dkeenan7/LyteFyba/web/BMUs_installed.jpg

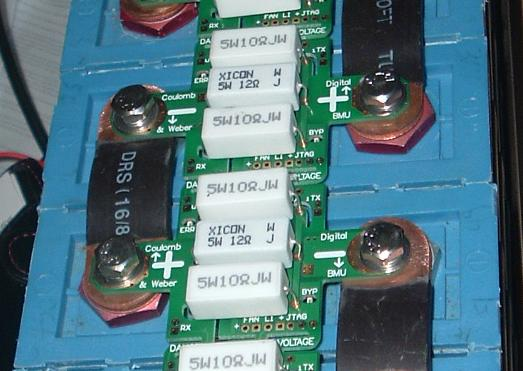
web/BMUs_installed.jpg
