dkeenan7/LyteFyba/web/BMU_tester_04_sm.jpg

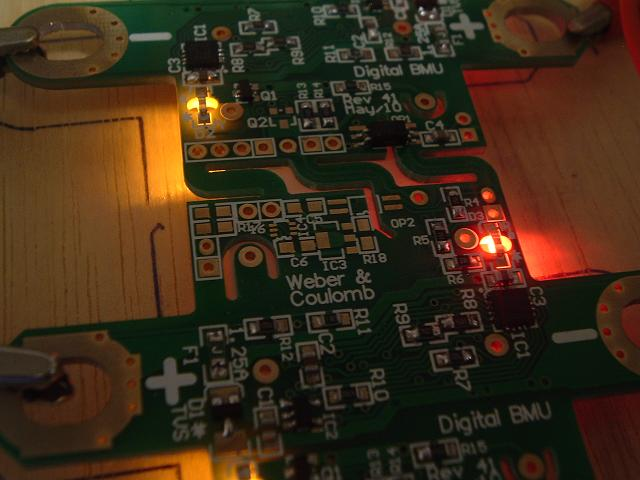
web/BMU_tester_04_sm.jpg
