dkeenan7/LyteFyba/wmonolith/LyteFyba Modbus protocol.odt

LyteFyba BMS

Modbus Protocol

The LyteFyba Battery Management System can communicate with the system controller using Modbus/ASCII over an RS232 port at 9600 bits per second, with a male D9 connector configured as a DTE. No handshaking is required, and appropriate signals are set so that any system expecting hardware handshaking will be satisfied. The communications port requires either 8 bits, no parity, and 1 stop bit, or 7 bits, space parity, and 1 stop bit.

Modbus commands must end with a carriage return character (hex 0D), which can optionally be followed by a linefeed character (hex 0A). All LyteFyba Modbus responses are terminated with a carriage return and a linefeed.

The main device address is 247 (although it may be changed in the source code, e.g. 100 for Geli). Results are read with function code 3 (read holding registers) only. All results are single register.

Parameter name | Register | Type | Units | Range | Equivalent plain-text command
Battery Energy Capacity | 43649 | Uint16 | Wh | 0-65,535 Wh | E@
Battery Discharge Capability | 43393 | Uint16 | W | 0-65,535 W | D@
Battery Charge Capability | 43137 | Uint16 | W | 0-65,535 W | C@
Battery Voltage | 40119 | Uint16 | 0.1 V | 0-400 V | v
Battery Current | 40109 | Sint16 | 0.5 A | -750 to 750 A | l
State Of Charge | 40103 | Uint16 | 0.1% | 0-100% | f
Maximum Cell Stress | 40113 | Bit fields | | See below | p

The register numbers above, use the strange Modbus convention whereby you must subtract 40001 to obtain the register address that is actually transmitted. For LyteFyba, this address corresponds to the equivalent plain-text (non-modbus) command, hence the large gaps between the numbers.

Uint16 = unsigned integer, 16 bits, range 0 to 65535

Sint16 = signed integer, 16 bits, range -32768 to 32767

It is also possible to address individual Cell Management Units (CMUs), using their cell number as their device address (e.g. 1-16 in a typical 48 V LiFePO4 battery). In this case, the Battery Voltage register contains the cell's voltage in millivolts, and the Maximum Cell Stress register contains the stress bit fields for that cell alone. There is also a broadcast device address, 246 (or one less than the main device address), to which all devices will respond – their responses arriving sequentially.

Maximum Cell Stress bit fields:

15-7 6 5 4 3 2 1 0

+------- -------+---------+---------+---------+---------+---------+---------+---------+

| Always | Comms | Stress type | Stress level (0 to 15 in binary) |

| 0 | error | | |

+------- -------+---------+---------+---------+---------+---------+---------+---------+

Treat 00 don't ignore 0-7 Normal

as 01 ignore on discharge 8-11 Warning

stress 10 ignore on charge 12-15 Alarm

8 11 all in bypass, and (BMU disconnects battery at 15)

ignore on discharge

Cell stress

The simplest battery monitoring systems use a single alarm-wire which is daisy-chained through all of the CMUs (Cell Management Units) so that if any cell goes outside its safe operating area the circuit is broken. This single-bit all-or-nothing approach does not give the rest of the system any warning of impending disconnection and so the LyteFyba system instead uses a four-bit number (0 to 15) to represent the "stress level" of each cell. Stress may be due to under-voltage, over-voltage, under-temperature, over-temperature, excessive charge current or excessive discharge current (whichever is the worst at the time). Stress levels 7 down to 0 are increasingly safe and levels 8 up to 15 are increasingly unsafe.

At regular intervals, the first CMU sends its stress level to the second CMU which, like all the remaining CMUs, either passes it on or substitutes its own stress level if this is greater. So the stress level that arrives at the BMU (Battery Management Unit) a few milliseconds later is the stress level of the most stressed cell. The BMU then substitutes a stress level based on the current if this is greater, and makes this available as register 40113 to the system controller. Stress updates can be configured to be as fast as 15 times per second or as slow as one every 1.9 seconds.

If stress is starting to rise when the system controller is discharging the battery, it can anticipate problems by responding to the increasing stress of say 8 to 9 to 10 by reducing the demand on the battery (direct the inverter to transfer less power). By reacting to the lower levels of stress, a potentially unstable situation where the battery voltage oscillates due to the inverter power surging high and low, as could happen with a single alarm condition, is avoided. Similarly, when charging the battery, as the battery approaches higher states of charge, its impedance rises, making it susceptible to surges. By heeding the lower stress levels and smoothly tapering the charge power, instability is again avoided.

The system controller, battery management system and battery form a control system. Ideally, but not required, a proportional / integral (PI) control algorithm would be used to control both discharge power (and hence current), and charge power (and hence current; the cells only care about current). That is the reason for the wide range of normal stress levels; a PI control algorithm is able to use these stress levels to better anticipate an alarm condition, resulting in better protection of the cells.

When the stress-type field is 00, 01 or 11, the stress should be treated like maximum cell voltage, and when the stress-type field is 00 or 10, the stress should be treated like minimum cell voltage, except in this case higher stress corresponds to lower cell voltage. If the stress is actually due to temperature or current, the same strategy will act to protect the battery, lowering discharge or charge current as needed. In all cases, the goal is to keep the stress below 8.

End of charge

For the BMS to consider that charging is complete and so resynchronise the coulomb-counting State-of-Charge register at 100%, and to avoid loss of capacity by keeping the cells balanced, the charge current will need to be reduced to a low value after the first cell nears full charge, and it will need to be held there while the other cells come up to the same voltage, which is the voltage at which the bypass resistors turn on. The bypass resistors can bypass a maximum of 0.8 amps.

A PI-control algorithm based on a stress setpoint of 7 would automatically accomplish this. Balancing is complete, and hence charging should be terminated, when the stress-type field of the stress register contains the bit values 11 and the stress-level field contains 7.

– Mike Van Emmerik, 05-Oct-2015 [Updated, 15-Feb-2016]
