dkeenan7/LyteFyba/PCB/TC charger/charger_interface2.gif

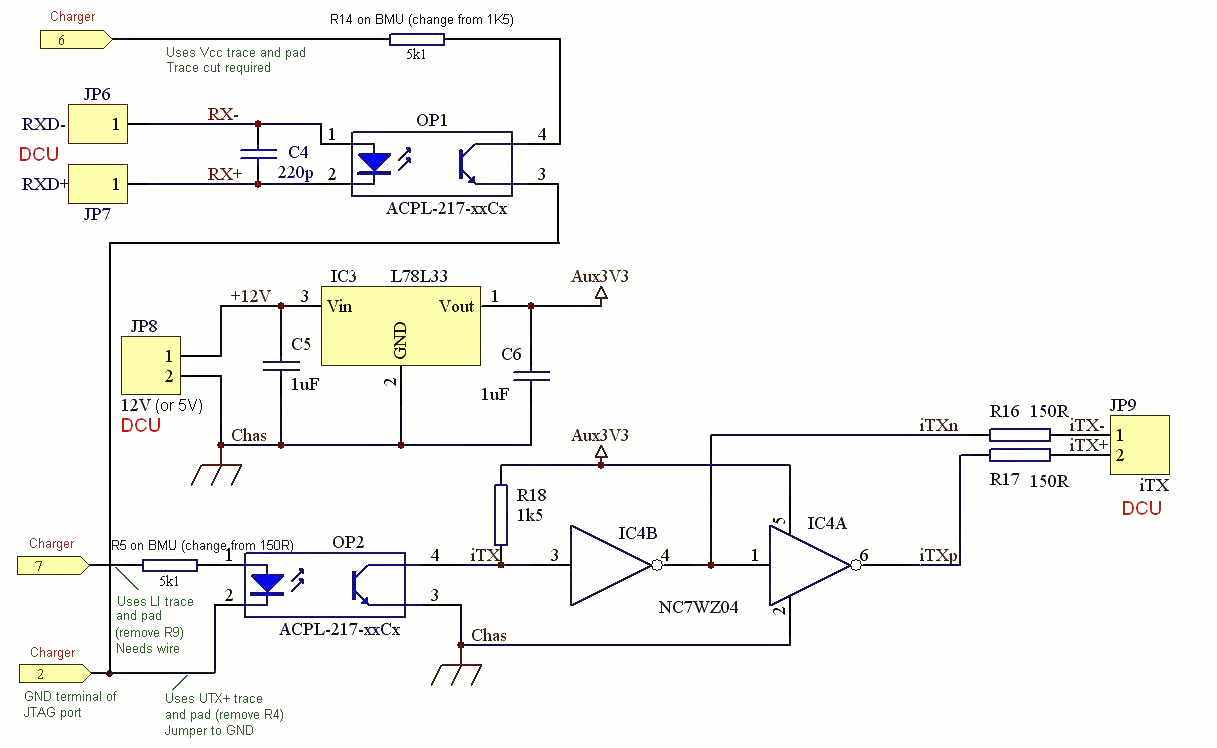
PCB/TC charger/charger_interface2.gif
