dkeenan7/LyteFyba/web/bms_digital41_pcb.gif

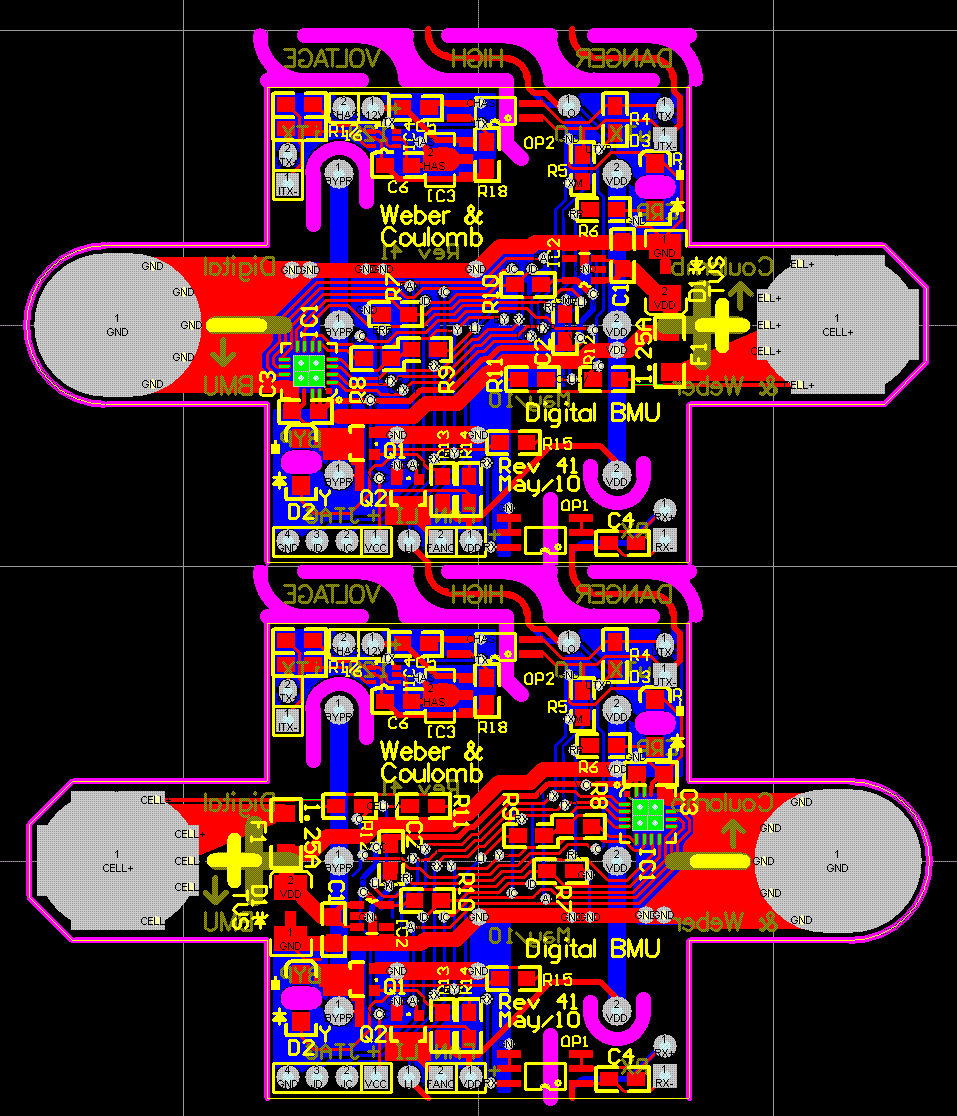
web/bms_digital41_pcb.gif
