dkeenan7/LyteFyba/web/bms_digital41_sch1.gif

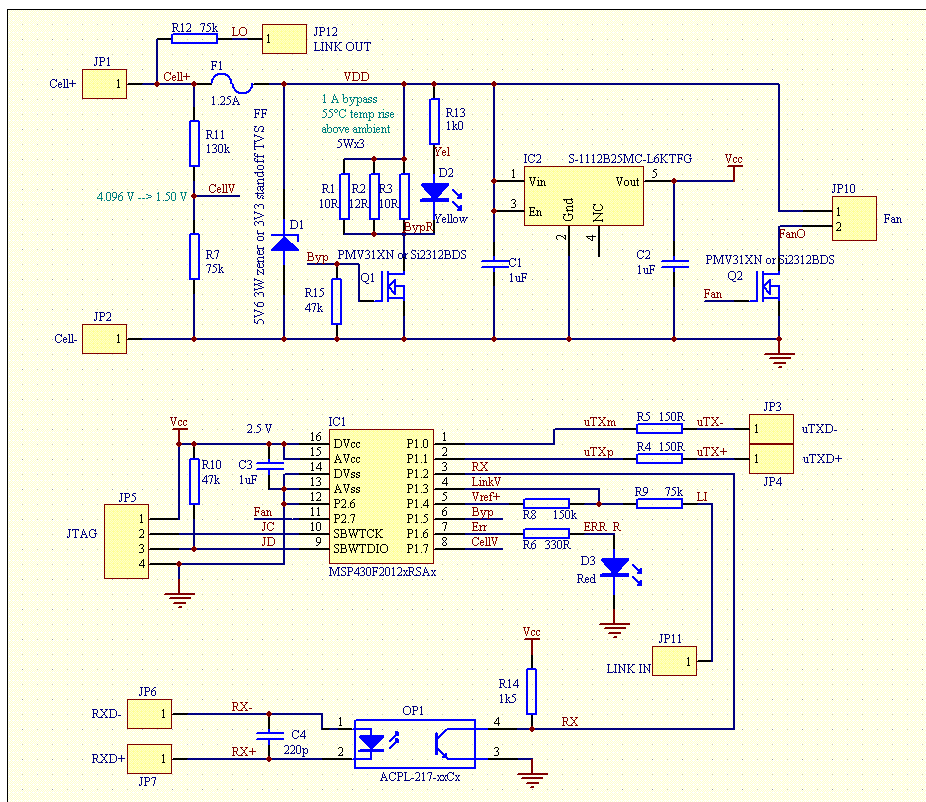
web/bms_digital41_sch1.gif
