dkeenan7/LyteFyba/web/bms_digital41_sch2.gif

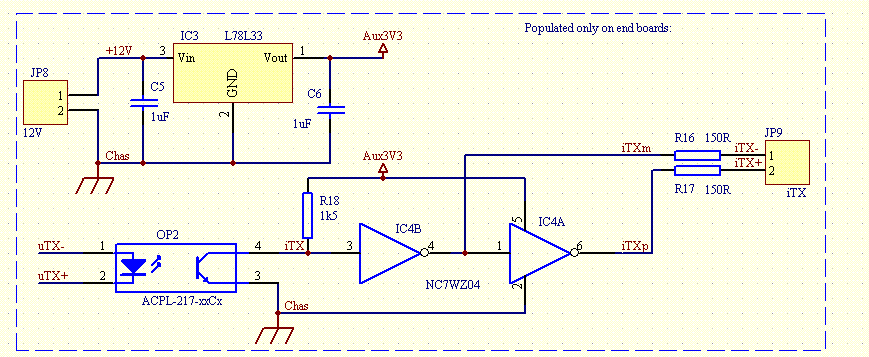
web/bms_digital41_sch2.gif
