dkeenan7/LyteFyba/web/JTAG 003 crop_sm.jpg

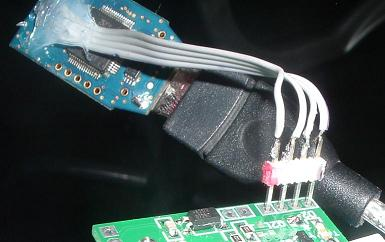
web/JTAG 003 crop_sm.jpg
