dkeenan7/LyteFyba/PCB/MidCMU (BoM).xlsx

Ref Name | Qty | Total | THD-DNP | Component | Description | Value | Package | Manufacturer | MPN | Digikey | Mouser
D5, D6 | 2 | 288 |  | 1N4148 |  |  | SOD523 | Micro Commercial Co | 1N4148X-TP | http://www.digikey.com.au/product-detail/en/micro-commercial-co/1N4148X-TP/1N4148XTPMSCT-ND/789335 | http://au.mouser.com/ProductDetail/Micro-Commercial-Components-MCC/1N4148X-TP/
P2, P3 | 2 | 288 | THD | 3WP | 3 way Pin Header |  | DSC | Wurth | 61300311121 | http://www.digikey.com.au/products/en?keywords=61300311121 | http://au.mouser.com/ProductDetail/Wurth-Electronics/61300311121/
P4, P5 | 2 | 288 | DNP | 4-2WP | 4 way Pin Header |  | DSC |  |  | http://www.digikey.com.au/product-detail/en/640453-4/A1917-ND/108991
P1, P6 | 2 | 288 | DNP | 4WP | 4 way Pin Header | Molex22-05-2041 | DSC |  |  | http://www.digikey.com.au/scripts/DkSearch/dksus.dll?vendor=0&keywords=WM4102-ND
C6, C7, C8, C9 | 4 | 576 |  | C | Capacitor | 1u0 | M1608 | Samsung | CL10B105MO8NNWC | http://www.digikey.com.au/product-detail/en/samsung-electro-mechanics-america-inc/CL10B105MO8NNWC/1276-6524-1-ND/5961383 | http://au.mouser.com/ProductDetail/Murata-Electronics/GRM188R71C105KA12J/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
C2, C3, C4 | 3 | 432 |  | C | Capacitor | 2n2 | M1608 | Samsung | CL10B222KB8WPNC | http://www.digikey.com.au/product-detail/en/samsung-electro-mechanics-america-inc/CL10B222KB8WPNC/1276-6530-1-ND/5961389 | http://au.mouser.com/ProductDetail/Wurth-Electronics/885012206085/
D1 | 1 | 144 |  | DIODE 2010 |  | CGRA4007-G | SM | Comchip Technology | CGRA4007-G | http://www.digikey.com.au/product-detail/en/CGRA4007-G/641-1018-1-ND/1121140 | http://au.mouser.com/ProductDetail/Comchip-Technology/CGRA4007-G/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
U4 | 1 | 144 |  | Dual Inverter |  | 74LVC2G04DW-7 | SOT363 | Diodes Inc | 74LVC2G04DW-7 | http://www.digikey.com.au/product-detail/en/diodes-incorporated/74LVC2G04DW-7/74LVC2G04DW-7DICT-ND/4505236 | http://au.mouser.com/ProductDetail/Diodes-Incorporated/74LVC2G04DW-7/
F1 | 1 | 144 |  | FUSE IEC |  | 1.25A | 2410 | Bell Fuse Inc | SSQ 1.25 | http://www.digikey.com.au/product-detail/en/SSQ%201.25/507-1046-1-ND/615027 | http://au.mouser.com/ProductDetail/Bel-Fuse/SSQ-125-1K/
U3 | 1 | 144 | DNP | IR RECEIVER |  | TSDP34156 | MISC |  |  | http://www.digikey.com.au/product-search/en?vendor=0&keywords=tsdp34156&stock=1 | http://au.mouser.com/ProductDetail/Vishay/TSDP34156/
D9 | 1 | 144 |  | LED |  | LB Q39G-L2OO-35-1 | LED M1608 | Osram | LB Q39G-L2OO-35-1 | http://www.digikey.com.au/product-detail/en/osram-opto-semiconductors-inc/LB-Q39G-L2OO-35-1/475-2816-1-ND/2176355 | http://au.mouser.com/ProductDetail/Osram-Opto-Semiconductor/LB-Q39G-L2OO-35-1/
D4 | 1 | 144 | DNP | LED |  | LTE-302 | LED side view thru hole |  |  | http://www.digikey.com.au/product-detail/en/LTE-302/160-1063-ND/153264 | http://au.mouser.com/ProductDetail/Lite-On/LTE-302/
D8 | 1 | 144 |  | LED |  | SML-D12M1WT86 | LED M1608 | Rohm | SML-D12M1WT86 | http://www.digikey.com.au/product-detail/en/rohm-semiconductor/SML-D12M1WT86/SML-D12M1WT86CT-ND/5843861 | http://au.mouser.com/ProductDetail/ROHM-Semiconductor/SML-D12M1WT86/
D16 | 1 | 144 |  | LED |  | SML-D12U1WT86 | LED M1608 | Rohm | SML-D12U1WT86 | http://www.digikey.com.au/product-detail/en/rohm-semiconductor/SML-D12U1WT86/SML-D12U1WT86CT-ND/5843858 | http://au.mouser.com/ProductDetail/ROHM-Semiconductor/SML-D12U1WT86/
D2 | 1 | 144 |  | LED |  | SML-D12Y1WT86 | LED M1608 | Rohm | SML-D12Y1WT86 | http://www.digikey.com.au/product-detail/en/rohm-semiconductor/SML-D12Y1WT86/SML-D12Y1WT86CT-ND/5843860 | http://au.mouser.com/ProductDetail/ROHM-Semiconductor/SML-D12Y1WT86/
U1 | 1 | 144 |  | MSP430G2553IPW20 | MSP430 Ultra-Low Power Microcontroller | MSP430G2553IPW20 | IPW20 | Texas Instruments | MSP430G2553IPW20R | http://www.digikey.com.au/product-detail/en/MSP430G2553IPW20R/296-28430-1-ND/2638889 | http://au.mouser.com/ProductDetail/Texas-Instruments/MSP430G2553IPW20R/
Q1 | 1 | 144 |  | NMOS SMD | MOSFET | RTR030N05TL | SMD | Alpha & Omega | AO3422 | https://www.digikey.com.au/product-detail/en/rohm-semiconductor/RTR030N05TL/RTR030N05TLCT-ND/2000247 | http://au.mouser.com/ProductDetail/ROHM-Semiconductor/RTR030N05TL/
OP1 | 1 | 144 |  | OPTO |  | TLP293(GR-TPL,E | SM | Toshiba | TLP293(GR-TPL,E | http://www.digikey.com.au/product-detail/en/toshiba-semiconductor-and-storage/TLP293(GR-TPL,E/TLP293(GR-TPLECT-ND/4562968 | http://au.mouser.com/ProductDetail/Broadcom-Avago/ACPL-217-50BE/
SG1 | 1 | 144 | THD | PIEZO_SMD |  | 4 kHz peak | PIEZO |  |  | http://www.digikey.com.au/products/en?keywords=PKM13EPYH4000 | http://au.mouser.com/ProductDetail/Murata/PKM13EPYH4000-A0/
R1 | 1 | 144 | DNP | R | Resistor | 0R | SM
R18 | 1 | 144 |  | R | Resistor | 5k1 | M1608 | Yageo | RC0603JR-075K1L | https://www.digikey.com.au/product-detail/en/yageo/RC0603JR-075K1L/311-5.1KGRCT-ND/729743 | http://au.mouser.com/ProductDetail/Yageo/RC0603JR-075K1L/
R17 | 1 | 144 |  | R | Resistor | 6k8 | M1608 | Yageo | RC0603JR-076K8L | https://www.digikey.com.au/product-detail/en/yageo/RC0603JR-076K8L/311-6.8KGRCT-ND/729760 | http://au.mouser.com/ProductDetail/Yageo/RC0603JR-076K8L/
R16, R19 | 2 | 288 |  | R | Resistor | 39R | M1608 | Yageo | RC0603JR-0739RL | https://www.digikey.com.au/product-detail/en/yageo/RC0603JR-0739RL/311-39GRCT-ND/729726 | http://au.mouser.com/ProductDetail/Yageo/RC0603JR-0739RL/
R10, R15 | 2 | 288 |  | R | Resistor | 47k | M1608 | Yageo | RC0603JR-0747KL | https://www.digikey.com.au/product-detail/en/yageo/RC0603JR-0747KL/311-47KGRCT-ND/729741 | http://au.mouser.com/ProductDetail/Yageo/RC0603JR-0747KL/
R5, R6 | 2 | 288 |  | R | Resistor | 150R | M1608 | Yageo | RC0603JR-07150RL | https://www.digikey.com.au/product-detail/en/yageo/RC0603JR-07150RL/311-150GRCT-ND/729661 | http://au.mouser.com/ProductDetail/Yageo/RC0603JR-07150RL/
R3, R4 (abc) | 6 | 864 |  | R | Resistor | 150k 0.1% | 0805 HV | Yageo | RT0805BRD07150KL | http://www.digikey.com.au/product-detail/en/yageo/RT0805BRD07150KL/YAG1784CT-ND/5139232 | http://au.mouser.com/ProductDetail/TE-Connectivity-Neohm/CPF0805B150KE1/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
R2, R7, R8, R9 | 4 | 576 |  | R | Resistor | 237k 0.1% | M1608 | Panasonic | ERA-3AEB2373V | http://www.digikey.com.au/product-detail/en/panasonic-electronic-components/ERA-3AEB2373V/P237KDBCT-ND/3075878 | http://au.mouser.com/ProductDetail/Susumu/RG1608P-2373-B-T5/
R13, R14 | 2 | 288 |  | R | Resistor | 510R | M1608 | Yageo | RC0603JR-07510RL | http://www.digikey.com.au/product-detail/en/yageo/RC0603JR-07510RL/311-510GRCT-ND/729748 | http://au.mouser.com/ProductDetail/Yageo/RC0603JR-07510RL/
R11 | 1 | 144 |  | R | Resistor | 750k | M1608 | Yageo | RC0603JR-07750KL | https://www.digikey.com.au/product-detail/en/yageo/RC0603JR-07750KL/311-750KGRCT-ND/729773 | http://au.mouser.com/ProductDetail/Yageo/RC0603JR-07750KL/
B1 | 1 | 144 | DNP | R | Resistor | Incandescent lamp | T-1-3_4 lamp | Visual Communications Company | 2181 | https://www.digikey.com.au/product-detail/en/visual-communications-company-vcc/2181/CM2181-ND/3151432 | http://au.mouser.com/ProductDetail/JKL-Components/2181/?qs=sGAEpiMZZMuSFBMFeRq2EXVNJElXobfD
C1 | 1 | 144 | THD | Supercap | Electrolytic Capacitor | 1F | DSCV | Nichicon | JUWT1105MCD | http://www.digikey.com.au/product-detail/en/JUWT1105MCD/493-4330-ND/2538684 | http://au.mouser.com/ProductDetail/Nichicon/JUWT1105MCD/
U2 | 1 | 144 |  | VREG |  | NCP699SN25T1G | SOT23-5 | ON Semiconductor | NCP699SN25T1G | http://www.digikey.com.au/product-detail/en/NCP699SN25T1G/NCP699SN25T1GOSCT-ND/1630377 | http://au.mouser.com/ProductDetail/ON-Semiconductor/NCP699SN25T1G/
XT1 | 1 | 144 |  | XTAL SMD |  |  | MC-146 | Abracon | AB26TRQ-32.768KHZ-T | http://www.digikey.com.au/product-detail/en/abracon-llc/AB26TRQ-32.768KHZ-T/535-12051-1-ND/3915232 | http://au.mouser.com/ProductDetail/ABRACON/AB26TRQ-32768kHz-T/
