dkeenan7/LyteFyba/PCB/bms_digital.xls

 |  |  |  | Mouser |  |  |  |  | Digikey |  |  |  |  | Element 14 (formerly Farnell)
Comment | Pattern | Quantity | Components | Part number | Price @1 | Price @250 | Total @1 | Total @250 | Part number | Price US$ | US$ @250 | US$ @1 | US$ @250 | Part number | Price @1 | Price @250 | Total @1 | Total @250
1.25A Superfast fuse | 1206 | 1 | F1 | 576-04661.25NR (http://au.mouser.com/ProductDetail/Xicon/280-CR5-10-RC/?qs=q%2fLDDvhnLwxm9P97CSW9MQ%3d%3d) | 0.621 (http://au.mouser.com/ProductDetail/Xicon/280-CR5-10-RC/?qs=q%2fLDDvhnLwxm9P97CSW9MQ%3d%3d) | 0.513 (http://au.mouser.com/ProductDetail/Xicon/280-CR5-10-RC/?qs=q%2fLDDvhnLwxm9P97CSW9MQ%3d%3d) | 0.621 (http://au.mouser.com/ProductDetail/Xicon/280-CR5-10-RC/?qs=q%2fLDDvhnLwxm9P97CSW9MQ%3d%3d) | 0.513 | MFU12061.25CT-ND (http://search.digikey.com/scripts/DkSearch/dksus.dll?Detail&name=MFU12061.25CT-ND) | 0.58 | 0.4038 | 0.58 | 0.4038 | 1596526 | 0.782 | 0.733 | 0.782 | 0.733
10R 5W | 5W | 2 | R1 R3 | 280-CR5-10-RC (http://au.mouser.com/ProductDetail/Xicon/280-CR5-10-RC/?qs=q%2fLDDvhnLwxm9P97CSW9MQ%3d%3d) | 0.527 (http://au.mouser.com/ProductDetail/Xicon/280-CR5-10-RC/?qs=q%2fLDDvhnLwxm9P97CSW9MQ%3d%3d) | 0.324 (http://au.mouser.com/ProductDetail/Xicon/280-CR5-10-RC/?qs=q%2fLDDvhnLwxm9P97CSW9MQ%3d%3d) | 1.054 (http://au.mouser.com/ProductDetail/Xicon/280-CR5-10-RC/?qs=q%2fLDDvhnLwxm9P97CSW9MQ%3d%3d) | 0.648 | 10W-5-ND | 0.34 | 0.225 | 0.68 | 0.45 | 1457957 (http://au.farnell.com/irc-tt-electronics/caw510r0jlf/power-resistor/dp/1457957) | 0.273 | 0.223 | 0.546 | 0.446
12R 5W | 5W | 1 | R2 | 280-CR5-12-RC (http://au.mouser.com/ProductDetail/Xicon/280-CR5-12-RC/) | 0.527 | 0.324 | 0.527 | 0.324 | 12W-5-ND | 0.34 | 0.225 | 0.34 | 0.225 | none in the shape we want (same as 10R) |  |  | 0.000 | 0.000
150R resistor | 0805 | 2 | R5 R4 | 260-150-RC | 0.054 | 0.027 | 0.108 | 0.054 | RHM150ARCT-ND | 0.034 | 0.02 | 0.068 | 0.04 | 1514819 | 0.046 | 0.028 | 0.092 | 0.056
330R | 0805 | 1 | R6 | 260-330-RC (http://au.mouser.com/ProductDetail/Xicon/260-330-RC/?qs=gb35HGp1gQJqBE8HQDEi3A%3d%3d) | 0.054 | 0.027 | 0.054 | 0.027 | RHM330ARCT-ND | 0.034 | 0.02 | 0.034 | 0.02 | 1127768 (http://au.farnell.com/multicomp/mc0805waf3300t5e-tc/thick-film-chip-resistor/dp/1127768) | 0.037 | 0.017 | 0.037 | 0.017 | Prices have increased
750R | 0805 | 1 | R15 | 260-750-RC (http://au.mouser.com/ProductDetail/Xicon/260-750-RC/) | 0.054 | 0.027 | 0.054 | 0.027 | RHM750ACCT-ND (http://search.digikey.com/scripts/DkSearch/dksus.dll?Detail&name=RHM750ARCT-ND) | 0.034 | 0.02 | 0.034 | 0.02 | 1537995 (http://au.element14.com/vishay-dale/crcw0805750rjnea/resistor-thick-film-750ohm-125mw/dp/1537995) | 0.075 | 0.025 | 0.075 | 0.025 | Value may change
1k5 | 0805 | 2 | R13 R14 | 260-1.5K-RC | 0.054 | 0.027 | 0.108 | 0.054 | RHM1.5KARCT-ND | 0.034 | 0.02 | 0.068 | 0.04 | 1652940 (http://au.farnell.com/vishay-draloric/crcw08051k50fkea/thick-film-chip-resistor/dp/1652940) | 0.021 | 0.019 | 0.042 | 0.038
75k 1% | 0805 | 2 | R7 R9 | 292-75K-RC | 0.054 | 0.035 | 0.108 | 0.070 | RHM75.0KCRCT-ND | 0.038 | 0.022 | 0.076 | 0.044 | 1632515 (http://au.farnell.com/multicomp/mc0805s8f7502t5e/thick-film-chip-resistor/dp/1632515?Ntt=1632515) | 0.061 | 0.024 | 0.122 | 0.048
130k 1% | 0805 | 1 | R11 | 292-130K-RC (http://au.mouser.com/ProductDetail/Xicon/292-130K-RC/?qs=iOOsOneZHhauxxWjN%2f7VTw%3d%3d) | 0.054 | 0.027 | 0.054 | 0.027 | RHM130KCRCT-ND | 0.038 | 0.022 | 0.038 | 0.022 | 9332570RL (http://au.farnell.com/multicomp/mc-0-1w-0805-1-130k/resistor-0805-130k/dp/9332570RL) | 0.01 | 0.075 | 0.010 | 0.075 | Use 3218314 for qty 1 (http://au.farnell.com/multicomp/mc-0-1w-0805-1-130k/resistor-0805-130k/dp/3218314)
150k 1% | 0805 | 1 | R8 | 292-150K-RC (http://au.mouser.com/ProductDetail/Xicon/292-150K-RC/?qs=wz62vPPJnUwi2jwBiBIyvw%3d%3d) | 0.054 | 0.027 | 0.054 | 0.027 | RHM150KCRCT-ND | 0.038 | 0.022 | 0.038 | 0.022 | 1500680RL | 0.268 | 0.208 | 0.268 | 0.208
47k | 0805 | 1 | R10 | 260-47K_RC | 0.054 | 0.027 | 0.054 | 0.027 | RHM47KARCT-ND | 0.034 | 0.02 | 0.034 | 0.02 | 1469929 | 0.03 | 0.02 | 0.030 | 0.020
1u0 capacitor | 0805 | 3 | C1 C2 C3 | 81-GRM219R71E105KA8D (http://au.mouser.com/ProductDetail/Murata/GRM219R71E105KA88D/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) | 0.068 | 0.049 | 0.204 | 0.147 | 445-3463-1-ND | 0.099 | 0.034 | 0.297 | 0.102 | 1683651 (http://au.farnell.com/taiyo-yuden/emk212b7105kd-t/ceramic-multilayer-capacitor/dp/1683651) | 0.05 | 0.05 | 0.150 | 0.150
220p | 0805 | 1 | C4 | 140-CC501B221K-RC (http://au.mouser.com/ProductDetail/Xicon/140-CC501B221K-RC/) | 0.054 | 0.036 | 0.054 | 0.036 | 445-4133-1-ND | 0.099 | 0.059 | 0.099 | 0.059 | 1708766 (http://au.farnell.com/multicomp/mc0805b221m101ct/multilayer-ceramic-capacitor/dp/1708766) | 0.037 | 0.031 | 0.037 | 0.031
3V3 standoff TVS | SOT-23 | 1 | D1 | 78-GSOT03C | 0.149 | 0.122 | 0.149 | 0.122 | 751-1398-1-ND | 0.5 | 0.169 | 0.5 | 0.169 | 1617669 | 0.63 | 0.393 | 0.630 | 0.393
Red LED Lite-On LTST-S110KRKT | 1206P | 1 | D3 | 859-LTST-S110KRKT | 0.203 | 0.135 | 0.203 | 0.135 | 54-1165-1-ND | 0.19 | 0.19 | 0.19 | 0.19 | 8530106 (http://au.farnell.com/kingbright/kptd-3216surc/led-smd-1206-lens-red/dp/8530106) | 0.355 | 0.254 | 0.355 | 0.254
Yellow LED Lite-On LTST-S110KSKT | 1206P | 1 | D2 | 859-LTST-S110KSKT | 0.203 | 0.135 | 0.203 | 0.135 | 754-1166-1-ND | 0.19 | 0.19 | 0.19 | 0.19 | 8530084 (http://au.farnell.com/kingbright/kptd-3216syc/led-smd-1206-lens-yellow/dp/8530084) | 0.355 | 0.254 | 0.355 | 0.254
MSP430F2012 microcontroller | PQFP16 | 1 | IC1 | 595-MSP430F2012IRSAT | 3.200 | 1.920 | 3.200 | 1.920 | 296-19732-1-ND (http://search.digikey.com/scripts/DkSearch/dksus.dll?Detail&name=296-19732-1-ND) | 3.33 | 1.943 | 3.33 | 1.943 | 1649403 (http://au.farnell.com/texas-instruments/msp430f2012irsat/16-bit-microcontroller-ic/dp/1649403) | 3.74 | 2.48 | 3.740 | 2.480 | Digikey no stock
ACPL-217 opto isolator (rank C) | SOP-4 | 1 | OP1 | ACPL-217-56CE (http://au.mouser.com/ProductDetail/Avago-Technologies/ACPL-217-56CE/?qs=dcm2zoLQumDNSqvWo37Wmw%3d%3d) | 0.405 | 0.338 | 0.405 | 0.338 | None suitable;some 2.54 mm pin spacing | 0 | 0 | 0 | 0 | 1602619 (http://au.farnell.com/avago-technologies/acpl-217-50ce/optocoupler-transistor-o-p/dp/1602619) | 0.707 | 0.368 | 0.707 | 0.368 | ACPL-M75L-000E; Digikey no stock
Si2312BDS 31 mR mosfet | SOT-23 | 1 | Q1 | 781-SI2312BDS-E3 (http://au.mouser.com/ProductDetail/Vishay/SI2312BDS-T1-E3/?qs=jcx%252b0HVgj2b3YhM4OoQ%252brQ%3d%3d) | 0.486 | 0.378 | 0.486 | 0.378 | SI2312BDS-T1-GE3CT-ND | 0.67 | 0.348 | 0.67 | 0.348 | 1497608 | 1.05 | 0.56 | 1.050 | 0.560 | PMV31XN is cheaper from Farnell
Voltage reg LDO 2V5 | SOT23-5 | 1 | IC2 | 628-1112B25MC-G (http://au.mouser.com/ProductDetail/Seiko-Instruments/S-1112B25MC-L6KTFG/?qs=KgNrcv8ZCHN3XG62sC2pOw%3d%3d) | 0.648 | 0.594 | 0.648 | 0.594 | TC1014-2.5VCT713CT-ND | 0.41 | 0.25 | 0.41 | 0.25 | 1736452 | 1.09 | 0.515 | 1.090 | 0.515 | Mouser region problem? Farnell was 1706403
Total |  | 26 |  |  |  |  | 8.348 | 5.603 |  |  |  | 7.676 | 4.5578 |  |  |  | 10.118 | 6.671
End of row only:
150R | 0805 | 2 | R16 R17 | 260-150-RC | 0.054 | 0.027 | 0.108 | 0.054 | RHM150ARCT-ND | 0.034 | 0.022 | 0.068 | 0.044 | 1514819 | 0.046 | 0.028 | 0.092 | 0.056
1k5 | 0805 | 1 | R18 | 260-1.5K-RC | 0.054 | 0.027 | 0.054 | 0.027 | RHM1.5KARCT-ND | 0.034 | 0.022 | 0.034 | 0.022 | 1652937 (http://au.farnell.com/vishay-draloric/crcw08051k00jnea/thick-film-chip-resistor/dp/1652937) | 0.055 | 0.033 | 0.055 | 0.033
1u0 | 0805 | 2 | C5 C6 | 81-GRM219R71E105KA8D (http://au.mouser.com/ProductDetail/Murata/GRM219R71E105KA88D/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) | 0.068 | 0.049 | 0.136 | 0.098 | 445-3463-1-ND | 0.099 | 0.034 | 0.198 | 0.068 | 1683651 (http://au.farnell.com/taiyo-yuden/emk212b7105kd-t/ceramic-multilayer-capacitor/dp/1683651) | 0.05 | 0.05 | 0.100 | 0.100
NC7WZ04 dual inverter | SC70-6 | 1 | IC4 | 512-NC7WZ04P6X_Q (http://au.mouser.com/ProductDetail/Fairchild-Semiconductor/NC7WZ04P6X_Q/) | 0.122 | 0.109 | 0.122 | 0.122 | NC7WZ04P6XCT-ND | 0.52 | 0.52 | 0.52 | 0.52 | 1417665 (http://au.farnell.com/jsp/search/productdetail.jsp?sku=1417665) | 0.33 | 0.322 | 0.330 | 0.322
L78L33 | SOT-89 | 1 | IC3 | 511-L78L33ACU (http://au.mouser.com/ProductDetail/STMicroelectronics/L78L33ACUTR/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) | 0.527 | 0.385 | 0.527 | 0.527 | 497-1200-1-ND | 0.66 | 0.66 | 0.66 | 0.66 | 1467767 (http://au.farnell.com/jsp/search/productdetail.jsp?sku=1467767) | 0.784 | 0.61 | 0.784 | 0.610
ACPL-217 opto isolator (rank C) | SOP-4 | 1 | OP2 | ACPL-217-56CE (http://au.mouser.com/ProductDetail/Avago-Technologies/ACPL-217-56CE/?qs=dcm2zoLQumDNSqvWo37Wmw%3d%3d) | 0.405 | 0.338 | 0.405 | 0.338 | None suitable | 0 | 0 | 0 | 0 | 1602619 (http://au.farnell.com/avago-technologies/acpl-217-50ce/optocoupler-transistor-o-p/dp/1602619) | 0.707 | 0.368 | 0.707 | 0.368 | ACPL-M75L-000E
Total |  | 8 |  |  |  |  | 1.244 | 1.112 |  |  |  | 1.48 | 1.314 |  |  |  | 2.068 | 1.489
Optional:
Si2312BDS 31 mR mosfet | SOT-23 | 1 | Q2 (fan) | 781-SI2312BDS-E3 | 0.783 | 0.324 | 0.783 | 0.324 |  |  |  | 0 | 0 | 1497608 (http://au.farnell.com/vishay-siliconix/si2312bds-t1-e3/mosfet-n-sot-23/dp/1497608) | 1.05 | 0.56 | 1.050 | 0.560 | PMV31XN is cheaper from Farnell
Alternatives:
ACPL-M75L opto isolator | SOP-5 | 2 | OP1 OP2 | ACPL-M75L-000E | 3.960 | 2.630 | 7.920 | 5.260 |  |  |  | 0 | 0 | 1640554 (http://au.farnell.com/avago-technologies/acpl-m75l-000e/optocoupler-smd-cmos/dp/1640554?Ntt=acpl-m75l) | 6.88 | 3.6 | 13.760 | 7.200
5V6 3W zener | 1810P | 1 | D1 | 863-1SMB5919BT3G (http://au.mouser.com/ProductDetail/ON-Semiconductor/1SMB5919BT3G/?qs=y2kkmE52mdM3jh3bYB7JjQ%3d%3d) | 0.338 | 0.227 | 0.338 | 0.227 |  |  |  | 0 | 0 | 1431162 (http://au.farnell.com/on-semiconductor/1smb5919bt3g/diode-zener-5-6v-3w/dp/1431162) | 0.24 | 0.176 | 0.240 | 0.176
Voltage reg LDO 3V3 | SOT-23-5 | 1 | IC2 | 628-1112B33MC-G (http://au.mouser.com/ProductDetail/Seiko-Instruments/S-1112B33MC-L6STFG/?qs=BnzAdGEH%252bAfFoO6Kq4fgFg%3d%3d) | 0.648 | 0.594 | 0.648 | 0.594 |  |  |  | 0 | 0 | 1706429 (http://au.farnell.com/austriamicrosystems/as13985h28-t/ldo-regulator-ic/dp/1706429) | 1.16 | 0.968 | 1.160 | 0.968
PMV31XN Threshold vrange too wide!! | SOT-23 | 1 | Q1 | 771-PMV31XN-T/R | 0.783 | 0.324 | 0.783 | 0.324 |  |  |  | 0 | 0 | 1081481 | 0.269 | 0.207 | 0.269 | 0.207
Diffamp boards only:
MCP6001 | SOT23-5 | 1 | IC5 |  |  |  |  |  | MCP6001T-I/OTCT-ND (http://search.digikey.com/scripts/DkSearch/dksus.dll?Detail&name=MCP6001T-I/OTCT-ND)
150k 0.1% | 0805 | 1 | R20 |  |  |  |  |  | RG20P150KBCT-ND (http://search.digikey.com/scripts/DkSearch/dksus.dll?Detail&name=RG20P150KBCT-ND) |  |  | 0.409
15k 0.1% | 0805 | 2 | R21 R22 |  |  |  |  |  | RG20P15.0KBCT-ND (http://search.digikey.com/scripts/DkSearch/dksus.dll?Detail&name=RG20P15.0KBCT-ND) |  |  | 0.409
300k 0.1% | 0805 | 2 | R23 R24 |  |  |  |  |  | RG20P300KBCT-ND (http://search.digikey.com/scripts/DkSearch/dksus.dll?Detail&name=RG20P300KBCT-ND) |  |  | 0.409
100n 2% PPS | 1210 | 2 | C20 C21 |  |  |  |  |  | PCF1189CT-ND (http://search.digikey.com/scripts/DkSearch/dksus.dll?Detail&name=PCF1189CT-ND)
1u0 | 0805 | 1 | C22 |  |  |  |  |  | 445-3463-1-ND
1k0 alternative value | 0805 | 1 | R8 |  |  |  |  |  | RHM1.0KARCT-ND
200A 50mV shunt 0.25% |  | 1 |  |  |  |  |  |  | 811-1096-ND (http://search.digikey.com/scripts/DkSearch/dksus.dll?Detail&name=811-1096-ND) |  |  | 30 |  | 1454630 (http://au.element14.com/murata-power-solutions/3020-01101-0/shunt/dp/1454630) | 65
 |  |  |  |  |  |  |  |  |  |  |  |  |  | http://www.rpc.com.au/catalog/external-shunt-200a-75mv-with-base-p-338.html
