dkeenan7/LyteFyba/(list of files, drawings)

Other design files:
PCB/12MidCMUs.pcb
PCB/BMU.pcb
PCB/CMU daughters.pcb
PCB/CMU.pcb
PCB/IMsection.pcb
PCB/MidCMU.pcb
PCB/MinCMU.pcb
PCB/OctCMU.pcb
