dkeenan7/LyteFyba/master/tritium/tri86.c

/*
 * Tritium TRI86 EV Driver Controls, version 2 hardware
 * Copyright (c) 2010, Tritium Pty Ltd.  All rights reserved.
 *
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
 */

// Include files
#include <msp430x24x.h>
#include <signal.h>
#include "tri86.h"
#include "can.h"
#include "usci.h"
#include "pedal.h"
#include "gauge.h"
#include "bms.h"
#include "charger.h"
#include "control.h"

#ifdef __ICC430__								// MVE: attempt to make the source code more IAR friendly, in case
#define __inline__								//	press F7, and so that "go to definition of X" works better
#define __volatile__
#define interrupt(x) void
void eint();
void dint();
#endif

#define LED_PORT			P4OUT				// MVE: modified DCU; uses port 3 for UART, port 4 for
												//	GREENn and REDn LEDs

// Macro needed to swap from little to big endian for 16-bit charger quantities:
#define SWAP16(x) ((x >> 8) | ((x & 0xFF) << 8))

// Function prototypes
void clock_init( void );
void io_init( void );
void timerA_init( void );
void timerB_init( void );
void adc_init( void );
static void __inline__ brief_pause(register unsigned int n);
void update_switches( unsigned int *state, unsigned int *difference);

// Global variables
// Status and event flags
volatile unsigned int events = 0x0000;
unsigned int charger_count = CHARGER_SPEED;
ctl_state hCtlDrive;						// State for the control algorithm for drive current
ctl_state hCtlCharge;						// State for the control algorithm for charge current

// Data from controller
float motor_rpm = 0;
float motor_temp = 0;
float controller_temp = 0;
float battery_voltage = 0;
float battery_current = 0;


void fault() {
	events |= EVENT_FAULT;				// Breakpoint this instruction and use stack backtrace
										//	(but beware the compiler may well inline it)
}

// Main routine
int main( void )
{
	// Local variables
	// Switch inputs - same bitfield positions as CAN packet spec
	unsigned int switches = 0x0000;
	unsigned int switches_diff = 0x0000;
	unsigned char next_state = MODE_OFF;
	// Comms
	unsigned int comms_event_count = 0;
	// LED flashing
	unsigned char charge_flash_count = CHARGE_FLASH_SPEED;
	// Debug
	unsigned int i;
	
	// Stop watchdog timer
	WDTCTL = WDTPW + WDTHOLD;

	// Initialise I/O ports
	io_init();

	// Wait a bit for clocks etc to stabilise, and power to come up for external devices
	// MSP430 starts at 1.8V, CAN controller need 3.3V
	for(i = 0; i < 10000; i++) brief_pause(10);

	// Initialise clock module - internal osciallator
	clock_init();

	// Initialise SPI port for CAN controller (running with SMCLK)
	usci_init(0);
	
	// Reset CAN controller and initialise
	// This also changes the clock output from the MCP2515, but we're not using it in this software
	can_init();
	events |= EVENT_CONNECTED;

	// Initialise Timer A (10ms timing ticks)
	timerA_init();

	// Initialise Timer B (gauge outputs PWM / pulses)
	timerB_init();

	// Initialise A/D converter for potentiometer and current sense inputs
	adc_init();

	// Initialise switch & encoder positions
	update_switches(&switches, &switches_diff);
	
	// Initialise command state
	command.rpm = 0.0;
	command.current = 0.0;
	command.bus_current = 1.0;
	command.flags = 0x00;
//	command.state = MODE_OFF;
	command.state = MODE_D;			// For now, we're like "drive, baby, drive!" (FIXME)
	
	// Init gauges
	gauge_init();
	
	// Init BMS and charger
	bms_init();
	chgr_init();

	// Enable interrupts
	eint();

	// Check switch inputs and generate command packets to motor controller
	// and control charging while monitoring BMUs.
	while(TRUE){
		// Monitor switch positions & analog inputs
		if( events & EVENT_TIMER ) {
			events &= ~EVENT_TIMER;

			// Convert potentiometer and current monitoring inputs
			ADC12CTL0 |= ADC12SC;               	// Start A/D conversions. Reset automatically by hardware
			while ( ADC12CTL1 & ADC12BUSY );		// DCK: Busy wait for all conversions to complete TODO: replace with ADC ISR

			// TODO: Check for 5V pedal supply errors
			// TODO: Check for overcurrent errors on 12V outputs
			// Update motor commands based on pedal and slider positions
			process_pedal( ADC12MEM0, ADC12MEM1, ADC_MAX, motor_rpm );	// MVE: For now, pass constant regen as 3rd arg
			
			// Update current state of the switch inputs
			update_switches(&switches, &switches_diff);
			
			// Track current operating state
			switch(command.state){
				case MODE_OFF:
					if(switches & SW_IGN_ON) next_state = MODE_N;
					else next_state = MODE_OFF;
					P5OUT &= ~(LED_GEAR_ALL);
					break;
				case MODE_N:	// MVE: we get here briefly when the fuel door closes, and a few other cases
								// With the
#if 0
					if((switches & SW_MODE_R) && ((events & EVENT_SLOW) || (events & EVENT_REVERSE))) next_state = MODE_R;
					else if((switches & SW_MODE_B) && ((events & EVENT_SLOW) || (events & EVENT_FORWARD))) next_state = MODE_B;
					else if((switches & SW_MODE_D) && ((events & EVENT_SLOW) || (events & EVENT_FORWARD))) next_state = MODE_D;
					else
#endif
						 if (!(switches & SW_IGN_ON)) next_state = MODE_OFF;
					else if (switches & SW_CHARGE_CABLE) next_state = MODE_CHARGE;
//					else next_state = MODE_N;
					else next_state = MODE_D;			// Always proceed to MODE_D unless ignition is off or fuel door is open
					P5OUT &= ~(LED_GEAR_ALL);
					P5OUT |= LED_GEAR_3;
					break;
				case MODE_R:							// MVE: we never get here now
					if(switches & SW_MODE_N) next_state = MODE_N;
					else if((switches & SW_MODE_B) && ((events & EVENT_SLOW) || (events & EVENT_FORWARD))) next_state = MODE_B;
					else if((switches & SW_MODE_D) && ((events & EVENT_SLOW) || (events & EVENT_FORWARD))) next_state = MODE_D;
					else if (!(switches & SW_IGN_ON)) next_state = MODE_OFF;
					else if (switches & SW_CHARGE_CABLE) next_state = MODE_CHARGE;
					else next_state = MODE_R;
					P5OUT &= ~(LED_GEAR_ALL);
					P5OUT |= LED_GEAR_4;
					break;
				case MODE_B:
					if(switches & SW_MODE_N) next_state = MODE_N;
					else if((switches & SW_MODE_R) && ((events & EVENT_SLOW) || (events & EVENT_REVERSE))) next_state = MODE_R;
					else if((switches & SW_MODE_D) && ((events & EVENT_SLOW) || (events & EVENT_FORWARD))) next_state = MODE_D;
					else if (!(switches & SW_IGN_ON)) next_state = MODE_OFF;
					else if (switches & SW_CHARGE_CABLE) next_state = MODE_CHARGE;
					else next_state = MODE_B;
					P5OUT &= ~(LED_GEAR_ALL);
					P5OUT |= LED_GEAR_2;
					break;
				case MODE_D:
#if 0
					if(switches & SW_MODE_N) next_state = MODE_N;
					else if((switches & SW_MODE_B) && ((events & EVENT_SLOW) || (events & EVENT_FORWARD))) next_state = MODE_B;
					else if((switches & SW_MODE_R) && ((events & EVENT_SLOW) || (events & EVENT_REVERSE))) next_state = MODE_R;
					else
#endif
						if (!(switches & SW_IGN_ON)) next_state = MODE_OFF;
					else if (switches & SW_CHARGE_CABLE) next_state = MODE_CHARGE;
					else next_state = MODE_D;
					P5OUT &= ~(LED_GEAR_ALL);
					P5OUT |= LED_GEAR_1;
					break;
				case MODE_CHARGE:
					if (switches_diff & SW_CHARGE_CABLE)
						// Just started charging
						chgr_start();
					if(!(switches & SW_CHARGE_CABLE)) next_state = MODE_N;
					else if (!(switches & SW_IGN_ON)) next_state = MODE_OFF;
					else next_state = MODE_CHARGE;
					if (next_state != MODE_CHARGE) {
						// Coming out of charge mode, because the cable is pulled, or the ignition is on
						chgr_off();
					}
					// Flash N LED in charge mode
					charge_flash_count--;
					P5OUT &= ~(LED_GEAR_4);
					if(charge_flash_count == 0){
						charge_flash_count = (CHARGE_FLASH_SPEED * 2);
						P5OUT |= LED_GEAR_3;
					}
					else if(charge_flash_count == CHARGE_FLASH_SPEED){
						P5OUT &= ~LED_GEAR_3;
					}
					break;
				default:
					next_state = MODE_OFF;
					break;
			}
			command.state = next_state;
				
			// Control brake lights
			if((switches & SW_BRAKE) || (events & EVENT_REGEN)) P1OUT |= BRAKE_OUT;
			else P1OUT &= ~BRAKE_OUT;
			
			// Control reversing lights
			if(command.state == MODE_R) P1OUT |= REVERSE_OUT;
			else P1OUT &= ~REVERSE_OUT;
			
			// Control CAN bus and pedal sense power
			if((switches & SW_IGN_ACC) || (switches & SW_IGN_ON)) {
			  	P1OUT |= CAN_PWR_OUT;
				P6OUT |= ANLG_V_ENABLE;
			}
			else{
				P1OUT &= ~CAN_PWR_OUT;
				P6OUT &= ~ANLG_V_ENABLE;
				events &= ~EVENT_CONNECTED;
				events |= EVENT_REQ_SLEEP;
			}

			chgr_timer();
			bmu_timer();
			
		} // End if( events & EVENT_TIMER )
		
		readBMUbytes(command.state == MODE_CHARGE);
		readChargerBytes();
		
		// Handle outgoing communications events (to motor controller)
		if(events & EVENT_COMMS){
			events &= ~EVENT_COMMS;

			// Update command state and override pedal commands if necessary
			if(switches & SW_IGN_ON){
				switch(command.state){
					case MODE_R:
					case MODE_D:
					case MODE_B:
						if(switches & SW_BRAKE){
							command.current = 0.0;	
							command.rpm = 0.0;
						}
						break;
					case MODE_CHARGE:
					case MODE_N:
					case MODE_START:
					case MODE_OFF:
					case MODE_ON:
					default:
						command.current = 0.0;
						command.rpm = 0.0;
						break;
				}
			}
			else{
				command.current = 0.0;
				command.rpm = 0.0;
			}

			// Transmit commands and telemetry
			if(events & EVENT_CONNECTED){
				// Blink activity LED
				// events |= EVENT_ACTIVITY;

				// Transmit drive command frame
				can.identifier = DC_CAN_BASE + DC_DRIVE;
				can.data.data_fp[1] = command.current;
				can.data.data_fp[0] = command.rpm;
				can_transmit();	
	
				// Transmit bus command frame
				can.identifier = DC_CAN_BASE + DC_POWER;
				can.data.data_fp[1] = command.bus_current;
				can.data.data_fp[0] = 0.0;
				can_transmit();
				
				// Transmit switch position/activity frame and clear switch differences variables
				can.identifier = DC_CAN_BASE + DC_SWITCH;
				can.data.data_u8[7] = command.state;
				can.data.data_u8[6] = command.flags;
				can.data.data_u16[2] = 0;
				can.data.data_u16[1] = 0;
				can.data.data_u16[0] = switches;
				can_transmit();
				
				// Transmit our ID frame at a slower rate (every 10 events = 1/second)
				comms_event_count++;
				if(comms_event_count == 10){
					comms_event_count = 0;
					can.identifier = DC_CAN_BASE;
					can.data.data_u8[7] = 'T';
					can.data.data_u8[6] = '0';
					can.data.data_u8[5] = '8';
					can.data.data_u8[4] = '6';
					can.data.data_u32[0] = DEVICE_SERIAL;
					can_transmit();		
				}
			}
		}
			
		
		// MVE: send packet to charger
		// Even though the current may not have changed, so we haven't sent a message for a while, the
		// charger will still time out if it doesn't see any message for ~ 10 seconds
		if (events & EVENT_CHARGER) {
			events &= ~EVENT_CHARGER;
			handleChargerEvent();
		}

		// Check for CAN packet reception
		if((P2IN & CAN_INTn) == 0x00){
			// IRQ flag is set, so run the receive routine to either get the message, or the error
			can_receive();
			// Check the status
			if(can.status == CAN_OK){
				// We've received a packet, so must be connected to something
					// MVE TODO: Distinguish between connecting to other DCU and to motor controller?
				events |= EVENT_CONNECTED;
				// Process the packet
				switch(can.identifier){
					case MC_CAN_BASE + MC_VELOCITY:
						// Update speed threshold event flags
						if(can.data.data_fp[1] > ENGAGE_VEL_F) events |= EVENT_FORWARD;
						else events &= ~EVENT_FORWARD;
						if(can.data.data_fp[1] < ENGAGE_VEL_R) events |= EVENT_REVERSE;
						else events &= ~EVENT_REVERSE;
						if((can.data.data_fp[1] >= ENGAGE_VEL_R) && (can.data.data_fp[1] <= ENGAGE_VEL_F)) events |= EVENT_SLOW;
						else events &= ~EVENT_SLOW;
						motor_rpm = can.data.data_fp[0];		// DCK: Was [1] for m/s (confirmed with TJ)
						gauge_tach_update( motor_rpm );
						break;
					case MC_CAN_BASE + MC_I_VECTOR:
						// Update regen status flags
						if(can.data.data_fp[0] < REGEN_THRESHOLD) events |= EVENT_REGEN;
						else events &= ~EVENT_REGEN;
						break;
					case MC_CAN_BASE + MC_TEMP1:
						// Update data for temp gauge
						controller_temp = can.data.data_fp[1];
						motor_temp = can.data.data_fp[0];
						gauge_temp_update( motor_temp, controller_temp );
						break;
					case MC_CAN_BASE + MC_BUS:
						// Update battery voltage and current for fuel and power gauges
						battery_voltage = can.data.data_fp[0];
						battery_current = can.data.data_fp[1];
						gauge_power_update( battery_voltage, battery_current );
						gauge_fuel_update( battery_voltage );
						break;
				}
			}
			if(can.status == CAN_RTR){
				// Remote request packet received - reply to it
				switch(can.identifier){
					case DC_CAN_BASE:
						can.data.data_u8[3] = 'T';
						can.data.data_u8[2] = '0';
						can.data.data_u8[1] = '8';
						can.data.data_u8[0] = '6';
						can.data.data_u32[1] = DEVICE_SERIAL;
						can_transmit();
						break;
					case DC_CAN_BASE + DC_DRIVE:
						can.data.data_fp[1] = command.current;
						can.data.data_fp[0] = command.rpm;
						can_transmit();
						break;
					case DC_CAN_BASE + DC_POWER:
						can.data.data_fp[1] = command.bus_current;
						can.data.data_fp[0] = 0.0;
						can_transmit();
						break;
					case DC_CAN_BASE + DC_SWITCH:
						can.data.data_u8[7] = command.state;
						can.data.data_u8[6] = command.flags;
						can.data.data_u16[2] = 0;
						can.data.data_u16[1] = 0;
						can.data.data_u16[0] = switches;
						can_transmit();
						break;
				}
			}
			if (can.status == CAN_ERROR) {
				if (can.identifier == 0x0002) {
					// Wake up CAN controller
					can_wake();
				}
				// Comment out for now: will always get CAN errors
				// fault();		// MVE: see the CAN error in fault light
			}
		}
		
		// Check sleep mode requests
/*		if(events & EVENT_REQ_SLEEP){
			events &= ~EVENT_REQ_SLEEP;
			can_abort_transmit();
			can_sleep();
			P4OUT &= ~LED_PWM;
			__bis_SR_register(LPM3_bits);     // Enter LPM3
		}
*/	} // End of while(True) do
	
	// Will never get here, keeps compiler happy
	return(1);
} // End of main


/*
 * Delay function
 */
static void __inline__ brief_pause(register unsigned int n)
{
#ifndef __ICC430__
    __asm__ __volatile__ (
		"1: \n"
		" dec	%[n] \n"
		" jne	1b \n"
        : [n] "+r"(n));
#endif
}

/*
 * Initialise clock module
 *	- Setup MCLK, ACLK, SMCLK dividers and clock sources
 *	- ACLK  = 0
 *	- MCLK  = 16 MHz internal oscillator
 *	- SMCLK = 16 MHz internal oscillator
 *
 * Note: We can also use the 2, 4, 8 or 16MHz crystal clock output from the MCP2515 CAN controller, which
 *       is a more accurate source than the internal oscillator.  However, using the internal
 *       source makes using sleep modes for both the MSP430 and the MCP2515 much simpler.
 */
void clock_init( void )
{
	BCSCTL1 = CALBC1_16MHZ;
	DCOCTL = CALDCO_16MHZ;
//	BCSCTL1 = 0x8F;			// FIXME!
//	DCOCTL = 0x83;
}

/*
 * Initialise I/O port directions and states
 *	- Drive unused pins as outputs to avoid floating inputs
 *
 */
void io_init( void )
{
	P1OUT = 0x00;
	P1DIR = BRAKE_OUT | REVERSE_OUT | CAN_PWR_OUT | P1_UNUSED;
	
	P2OUT = 0x00;
	P2DIR = P2_UNUSED;

//	P3OUT = CAN_CSn | EXPANSION_TXD | LED_REDn | LED_GREENn;
	P3OUT = CAN_CSn | CHARGER_TXD | BMS_TXD;
//	P3DIR = CAN_CSn | CAN_MOSI | CAN_SCLK | EXPANSION_TXD | LED_REDn | LED_GREENn | P3_UNUSED;
	P3DIR = CAN_CSn | CAN_MOSI | CAN_SCLK | CHARGER_TXD | BMS_TXD | P3_UNUSED;
	
	P4OUT = LED_PWM | LED_REDn | LED_GREENn;
	P4DIR = GAUGE_1_OUT | GAUGE_2_OUT | GAUGE_3_OUT | GAUGE_4_OUT | LED_PWM | LED_REDn | LED_GREENn;
	
	P5OUT = 0x00;
	P5DIR = LED_FAULT_1 | LED_FAULT_2 | LED_FAULT_3 | LED_GEAR_BL | LED_GEAR_4 | LED_GEAR_3 | LED_GEAR_2 | LED_GEAR_1 | P5_UNUSED;
	
	P6OUT = 0x00;
	P6DIR = ANLG_V_ENABLE | P6_UNUSED;
	
	// Initialise charger and BMS UARTs
	P3SEL |= CHARGER_TXD | CHARGER_RXD | BMS_TXD | BMS_RXD;// Set pins to peripheral function, not GPIO
	UCA0CTL1 |= UCSSEL_2;					// SMCLK
	UCA1CTL1 |= UCSSEL_2;					// SMCLK
	// Baud rate charger 2400 b/s, 16000 / 2.4 / 16 = 416.667 = 0x01A0 with 0xB1 for the fractional part
	UCA0BR1=0x01; UCA0BR0=0xA0; UCA0MCTL=0xB1;
	// Baud rate BMS     9600 b/s, 16000 / 9.6 / 16 = 104.167 = 0x0068 with 0x31 for the fractional part
	UCA1BR1=0x00; UCA1BR0=0x68; UCA1MCTL=0x31;
	UCA0CTL1 &= ~UCSWRST;					// **Initialize USCI state machine**
	UCA1CTL1 &= ~UCSWRST;
	IE2 |= UCA0RXIE;						// Enable charger RX interrupt
	UC1IE |= UCA1RXIE;						// Enable BMS RX interrupt
}


/*
 * Initialise Timer A
 *	- Provides timer tick timebase at 100 Hz
 */
void timerA_init( void )
{
	TACTL = TASSEL_2 | ID_3 | TACLR;			// MCLK/8, clear TAR
	TACCR0 = (INPUT_CLOCK/8/TICK_RATE);			// Set timer to count to this value = TICK_RATE overflow
	TACCTL0 = CCIE;								// Enable CCR0 interrrupt
	TACTL |= MC_1;								// Set timer to 'up' count mode
}


/*
 * Initialise Timer B
 *	- Provides PWM and pulse outputs for gauges
 *	- 10000Hz timer ISR
 *	- With 16MHz clock/8 = 200 count resolution on PWM
 *
 */
void timerB_init( void )
{
	TBCTL = TBSSEL_2 | ID_3 | TBCLR;			// MCLK/8, clear TBR
	TBCCR0 = GAUGE_PWM_PERIOD;					// Set timer to count to this value
	TBCCR2 = 0;									// Gauge 3
	TBCCTL2 = OUTMOD_7;
	TBCCR1 = 0;									// Gauge 4
	TBCCTL1 = OUTMOD_7;
	P4SEL |= GAUGE_3_OUT | GAUGE_4_OUT;			// PWM -> output pins for fuel and temp gauges (tacho and power are software freq outputs)
	TBCCTL0 = CCIE;								// Enable CCR0 interrupt
	TBCTL |= MC_1;								// Set timer to 'up' count mode
}

/*
 * Initialise A/D converter
 */
void adc_init( void )
{
	// Enable A/D input channels											
	P6SEL |= ANLG_SENSE_A | ANLG_SENSE_B | ANLG_SENSE_C | ANLG_SENSE_V | ANLG_BRAKE_I | ANLG_REVERSE_I | ANLG_CAN_PWR_I;
	// Turn on ADC12, set sampling time = 256 ADCCLK, multiple conv, start internal 2.5V reference
	ADC12CTL0 = ADC12ON | SHT0_8 | SHT1_8 | MSC | REFON | REF2_5V;	
	// Use sampling timer, ADCCLK = MCLK/4, run a single sequence per conversion start
	ADC12CTL1 = ADC12SSEL_2 | ADC12DIV_3 | SHP | CONSEQ_1;
	// Map conversion channels to input channels & reference voltages
	ADC12MCTL0 = INCH_3 | SREF_1;			// Analog A
	ADC12MCTL1 = INCH_2 | SREF_1;			// Analog B
	ADC12MCTL2 = INCH_1 | SREF_1;			// Analog C
	ADC12MCTL3 = INCH_4 | SREF_1;			// Analog V Supply
	ADC12MCTL4 = INCH_5 | SREF_1;			// Brake light current
	ADC12MCTL5 = INCH_6 | SREF_1;			// Reverse light current
	ADC12MCTL6 = INCH_7 | SREF_1 | EOS;		// CAN Bus current / End of sequence
	// Enable interrupts on final conversion in sequence
//	ADC12IE = BIT6;	// Some bug with this - keep using polling for the moment
	// Enable conversions
	ADC12CTL0 |= ENC;											
}

/*
 * Timer B CCR0 Interrupt Service Routine
 *	- Interrupts on Timer B CCR0 match at GAUGE_FREQUENCY (10kHz)
 */
interrupt(TIMERB0_VECTOR) timer_b0(void)
{
	static unsigned int gauge_count;
	static unsigned int gauge1_on, gauge1_off;
	static unsigned int gauge2_on, gauge2_off;
	
	// Toggle gauge 1 & 2 pulse frequency outputs
	if(gauge_count == gauge1_on){
		P4OUT |= GAUGE_1_OUT;
		gauge1_on = gauge_count + gauge.g1_count;
		gauge1_off = gauge_count + (gauge.g1_count >> 2);
	}
	if(gauge_count == gauge1_off){
		P4OUT &= ~GAUGE_1_OUT;
	}

	if(gauge_count == gauge2_on){
		P4OUT |= GAUGE_2_OUT;
		gauge2_on = gauge_count + gauge.g2_count;
		gauge2_off = gauge_count + (gauge.g2_count >> 2);
	}
	if(gauge_count == gauge2_off){
		P4OUT &= ~GAUGE_2_OUT;
	}

	// Update pulse output timebase counter
	gauge_count++;
	
	// Update outputs if necessary
	if(events & EVENT_GAUGE1){
		events &= ~EVENT_GAUGE1;
	}
	if(events & EVENT_GAUGE2){
		events &= ~EVENT_GAUGE2;
	}
	if(events & EVENT_GAUGE3){
		events &= ~EVENT_GAUGE3;
		TBCCR2 = gauge.g3_duty;		
	}
	if(events & EVENT_GAUGE4){
		events &= ~EVENT_GAUGE4;
		TBCCR1 = gauge.g4_duty;		
	}	
}

/*
 * Timer A CCR0 Interrupt Service Routine
 *	- Interrupts on Timer A CCR0 match at 100Hz
 *	- Sets Time_Flag variable
 */

interrupt(TIMERA0_VECTOR) timer_a0(void)
{
	static unsigned char comms_count = COMMS_SPEED;
	static unsigned char activity_count;
	static unsigned char fault_count;

	
	// Trigger timer based events
	events |= EVENT_TIMER;	


	// Trigger comms events (command packet transmission)
	comms_count--;
	if( comms_count == 0 ){
		comms_count = COMMS_SPEED;
		events |= EVENT_COMMS;
	}

	// MVE: Trigger charger events (command packet transmission)
	if((command.state == MODE_CHARGE) && (--charger_count == 0) ){
		charger_count = CHARGER_SPEED;
		events |= EVENT_CHARGER;
	}

	// Check for CAN activity events and blink LED
	if(events & EVENT_ACTIVITY){
		events &= ~EVENT_ACTIVITY;
		activity_count = ACTIVITY_SPEED;
		LED_PORT &= ~LED_GREENn;
	}
	if( activity_count == 0 ){
		LED_PORT |= LED_GREENn;
	}
	else{
		activity_count--;
	}

	// MVE: similarly for FAULT LED
	if (events & EVENT_FAULT) {
		events &= ~EVENT_FAULT;
		fault_count = FAULT_SPEED;
		LED_PORT &= ~LED_REDn;
	}
	if ( fault_count == 0)
		LED_PORT |= LED_REDn;
	else
		--fault_count;

}

/*
 * Collect switch inputs from hardware and fill out current state, and state changes
 *	- Inverts active low switches so that all bits in register are active high
 */
void update_switches( unsigned int *state, unsigned int *difference)
{
	unsigned int old_switches;
	
	// Save state for difference tracking
	old_switches = *state;

	// Import switches into register

#if 0
	if(P2IN & IN_GEAR_4) *state |= SW_MODE_R;
	else *state &= ~SW_MODE_R;
	
	if(P2IN & IN_GEAR_3) *state |= SW_MODE_N;
	else *state &= ~SW_MODE_N;

	if(P2IN & IN_GEAR_2) *state |= SW_MODE_B;
	else *state &= ~SW_MODE_B;

	if(P2IN & IN_GEAR_1) *state |= SW_MODE_D;
	else *state &= ~SW_MODE_D;
#endif
	
	if(P1IN & IN_IGN_ACCn) *state &= ~SW_IGN_ACC;
	else *state |= SW_IGN_ACC;
	
	if(P1IN & IN_IGN_ONn) *state &= ~SW_IGN_ON;
	else *state |= SW_IGN_ON;

	if(P1IN & IN_IGN_STARTn) *state &= ~SW_IGN_START;
	else *state |= SW_IGN_START;

	if(P1IN & IN_BRAKEn) *state &= ~SW_BRAKE;
	else *state |= SW_BRAKE;

	if(P1IN & IN_FUEL) *state |= SW_CHARGE_CABLE;
	else *state &= ~SW_CHARGE_CABLE;

	// Update changed switches
	*difference = *state ^ old_switches;	
}

/*
 * ADC12 Interrupt Service Routine
 *	- Interrupts on channel 6 conversion (end of sequence)
 */
 /*
interrupt(ADC12_VECTOR) adc_isr(void)
{
	// Read data to clear ISR flag
	ADC12IFG = 0x0000;

	// Trigger adc events
	events |= EVENT_ADC;
}
*/
