dkeenan7/LyteFyba/master/tritium/control.h

//	Control.h
//	Interface for a simple PID controller
//

#ifndef __CONTROL_H_
#define __CONTROL_H_

typedef struct _ctl_state {
	int		set_point;		// Desired set point
	int		Kp;				// Proportional control constant
	int		Ki;				// Integral control constant
	int		Kd;				// Derivative control constant
	int		prev_error;		// Previous error
	int		prev_result;	// Previous result
	int		prev_deriv;		// Previous derivative, to find second derivative
} ctl_state;

int ctl_tick(ctl_state* pState, int measure);	// Main function every tick of time:
												// Use the measurement to produce an output

void ctl_init(ctl_state* pState, int iSet_point, int iKp, int iKi, int iKd, int measure);

#endif		// ifndef __CONTROL_H_
