dkeenan7/LyteFyba/LyteFlash/MainFrm.cpp

// MainFrm.cpp : implementation of the CMainFrame class
//

#include "stdafx.h"
#include "LyteFlash.h"

#include "MainFrm.h"

#ifdef _DEBUG
#define new DEBUG_NEW
#endif


// CMainFrame

IMPLEMENT_DYNCREATE(CMainFrame, CFrameWnd)

BEGIN_MESSAGE_MAP(CMainFrame, CFrameWnd)
	ON_WM_CREATE()
END_MESSAGE_MAP()

static UINT indicators[] =
{
	ID_SEPARATOR,           // status line indicator
	ID_INDICATOR_CAPS,
	ID_INDICATOR_NUM,
	ID_INDICATOR_SCRL,
};


// CMainFrame construction/destruction

CMainFrame::CMainFrame()
{
}

CMainFrame::~CMainFrame()
{
}


int CMainFrame::OnCreate(LPCREATESTRUCT lpCreateStruct)
{
	if (CFrameWnd::OnCreate(lpCreateStruct) == -1)
		return -1;
	
	if (!m_wndToolBar.CreateEx(this, TBSTYLE_FLAT, WS_CHILD | WS_VISIBLE | CBRS_TOP
		| CBRS_GRIPPER | CBRS_TOOLTIPS | CBRS_FLYBY | CBRS_SIZE_DYNAMIC) ||
		!m_wndToolBar.LoadToolBar(IDR_MAINFRAME))
	{
		TRACE0("Failed to create toolbar\n");
		return -1;      // fail to create
	}

	if (!m_wndStatusBar.Create(this) ||
		!m_wndStatusBar.SetIndicators(indicators,
		  sizeof(indicators)/sizeof(UINT)))
	{
		TRACE0("Failed to create status bar\n");
		return -1;      // fail to create
	}

	// TODO: Delete these three lines if you don't want the toolbar to be dockable
	m_wndToolBar.EnableDocking(CBRS_ALIGN_ANY);
	EnableDocking(CBRS_ALIGN_ANY);
	DockControlBar(&m_wndToolBar);

	return 0;
}

BOOL CMainFrame::PreCreateWindow(CREATESTRUCT& cs)
{
	if( !CFrameWnd::PreCreateWindow(cs) )
		return FALSE;
	// TODO: Modify the Window class or styles here by modifying
	//  the CREATESTRUCT cs
	cs.cx = 500;
	cs.cy = 200;

	return TRUE;
}


// CMainFrame diagnostics

#ifdef _DEBUG
void CMainFrame::AssertValid() const
{
	CFrameWnd::AssertValid();
}

void CMainFrame::Dump(CDumpContext& dc) const
{
	CFrameWnd::Dump(dc);
}

#endif //_DEBUG


// CMainFrame message handlers



CMainFrame* GetFrame() {return (CMainFrame*)theApp.m_pMainWnd;}

void CMainFrame::GetMessageString(UINT nID, CString& rMessage) const {
	if ((nID >= ID_FILE_MRU_FILE1) && (nID <= ID_FILE_MRU_FILE16))
		rMessage = theApp.GetRecentFile(nID - ID_FILE_MRU_FILE1);
	else
		CFrameWnd::GetMessageString(nID, rMessage);
}
