dkeenan7/LyteFyba/LyteFlash/MainFrm.h

// MainFrm.h : interface of the CMainFrame class
//


#pragma once

class CMainFrame : public CFrameWnd
{
	
protected: // create from serialization only
	CMainFrame();
	DECLARE_DYNCREATE(CMainFrame)

// Attributes
public:
	CStatusBar& GetStatusBar() {return m_wndStatusBar;}


// Operations
public:

// Overrides
public:
	virtual BOOL PreCreateWindow(CREATESTRUCT& cs);
	virtual void GetMessageString(UINT nID, CString& rMessage) const;

// Implementation
public:
	virtual ~CMainFrame();
#ifdef _DEBUG
	virtual void AssertValid() const;
	virtual void Dump(CDumpContext& dc) const;
#endif

protected:  // control bar embedded members
	CStatusBar  m_wndStatusBar;
	CToolBar    m_wndToolBar;

// Generated message map functions
protected:
	afx_msg int OnCreate(LPCREATESTRUCT lpCreateStruct);
	DECLARE_MESSAGE_MAP()
};

CMainFrame* GetFrame();
