dkeenan7/LyteFyba/(commit log)

2010-08-05 * Fixed major problems caused by using xLIT with the addresses of labels * Added 'b' command (caliBrate link voltage) * Added flashWrite (non-interactive) command * Added MS1 for 1.04 ms delay (saves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
2010-08-05 Control flow macros required by the interpreter
2010-08-08 Split off voltage measurement to separate file measure.s43; changed temp calibration to be a non-shifted offset from 273. No new data format for this.
2010-08-09 Oops! Was not calling measure at all. Fixed some missing <<12. Document that measure returns a 12.2 bit result. Don't calibrate twice. Fix typo ADC10AE -> ADC10AE0
2010-08-10 GUI BMUsend program now with Refresh button in Serial dialog
2010-08-10 Clear the listbox before adding items when the Refresh button is pressed
2010-08-11 Implemented Mike's excellent saving of three words in the BSL (for a total of 4 spare) due to his brilliant transformation of the password-recognising FSM to eliminate two unconditional jumps, and mo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
2010-08-13 Reread the file before sending, in case sending the same file with changes (saves a little time)
2010-08-13 Oops, infinite recursion fixed. Reread the file before sending, in case sending the same file with changes (saves a little time)
2010-08-14 Separation of WriteByte from Readbyte. This necessitates version 4 data layout for the BSLwriter. sendprog has a double delay now; erasing happens between last password byte and first data byte now. 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
2010-08-16 Split off 3 include-files from interpreter.s43: ForthXCompileMacros.s43, ForthCoreWords.s43, BytecodeInterpreter.s43. Added macros and runtime support for all ISO-Forth counted loops, plus FOR..NEXT.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
2010-08-16 Used new xFOR xNEXT and other Forth control-flow macros to eliminate all labels and explicit jumps from all xColon definitions. See particularly EmitDec and Discharge. Wrote Forth versions of Bypass 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
2010-08-16 Added conditional assembly for CHECKSUM (off) and OKPROMPT (on). No need to type those fake checksums now.
    Replaced FOR NEXT loops with ISO standard ?DO LOOPs. '1m' now works correctly.
    I reinstated OnePlus, with bytecode ';' semicolon. Implemented 'TYPE', bytecode 'T' which EMITs a whole string. And I debugged the string literal macros and their runtime bytecode '"' (double-quote).
    I fixed 'z', 'q', and 'g' bytecodes which I had broken by redefining xNEXT for a loop ending without replacing their machine code routine endings with the new 'next'.
    Interpreter.txt now has a complete list of bytecode assignments in ASCII order, at the end.
2010-08-18 Fix a minor bug whereby IDs were not preserved if CALIBRATE was off
2010-08-19 Eliminated RETT bytecode in favour of EXIT. Added EXECUTE, EXECUTECODE Forth words and execute, executecode assembler subroutines for calling both bytecode and machine-code Forth words by address fro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
2010-08-23 First cut at badness channel logic. No change to 'u' command yet.
2010-08-24 Restored the machine code version of the outer interpreter as an option, and added backspace editing to it (shows how to use assembler _CASE macros). 6 bytes smaller without checksum checking, only 2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
2010-08-27 Implemented badness channel and timer interrupt based master/slave badness logic. Fixed incorrect word operations on CHKSUM byte. Removed some commented out code, e.g. SLOWSAMP is now effectively alw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
2010-08-30 Updated web page with circuit and PCB layout
2010-08-30 Added cellmonitor directory; has working timer interrupt based 9600 baud code designed for 1 MHz
2010-09-03 Committed optional code to use P1.5 as inverted TA0 via USI SCLK (for timer-synchronised jitter-free differential TXD output).
2010-09-05 Transmits to P1.5 and P1.1 now (inverted output to P1.1); simplified transmit interrupts
2010-09-05 Simplified receive interrupts (no false start bit detection; no majority voting; a larger capacitor is assumed
2010-09-06 First cut at assembly language measurement loop and badness logic; removed old callback code. NOTE: UNTESTED
2010-09-08 Support new layout with TXDp on TA0; clear bypass and LED at initialise time; fixed several compare and branch errors; disable link checking for now; turn off CPUOFF bit in saved status on timer over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
2010-09-09 Add support to the frequency calibration code at to uncompress 4 MHz calibration data
2010-09-09 Added facility to force a value to the 4MHz calibration byte (temporary)
2010-09-09 Added a jump to main at in case code is started by BSL; 4 MHz frequency is via MHz4Cal; forgot to clear R10 before a divide; saturate link voltage at zero (low end) in link badness code
2010-09-11 Version 5 calibration data layout and conversion from version 4. Removed conversions from earlier versions. Removed #if 0 code and #if TXONSCLK code. Wrapped comments to 104 chars max.
2010-09-12 Insert missing DB Space for 'b' (link caliBrate) command; still not working
2010-09-12 Can't use xLIT2 for 000 in 'b' (link caliBrate) command
2010-09-16 Added definitions.s43; moved definitions there; _OPCODETBL now 0 bytes hard against interrupt vectors
2010-09-17 Removed the TEST conditional assembly (so it's always on now)
2010-09-17 Mods to remove 32-byte sample buffer (1/4 of available RAM) with conditional assembly; modified measurement code to use 4 MHz clock regime; SetIDs command. All untested
2010-09-17 First cut at translating most of the BMU related functions to assembly language; not tested
2010-09-18 Now using a 3-register 'stack', though most application bytecodes don't DROP parameters. Moved #includes to end of monitor.s43. Fixed some tabs. Added l and y definitions. Changed LED behaviour.
2010-09-18 Simplified waitTxCmpl; minor changes to 's' command; use 15,000 to display ?000 for uncalibrated link voltage; Added 'b' command (caliBrate link); in 'i' command wait for transmit complete, at least 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
2010-09-20 Many mods to try and spend less time in interrupt routines, and keep interrupts off while in interrupt routines (not quite there yet). Not working all that well so far, for unknown reasons, but I sus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
2010-09-29 Reset to 0x1000 in case of crash; define BSLErase for data version 4
2010-09-30 Read 'I' and cell ID from serial port if RESETIDS; fixed clock #defines; reset watchdog timer where needed; adjust errorFlash timing as for 4MHz
2010-10-02 Changed the structure of the main loop to avoid double testing. Wrote it using structured control-flow macros. Made badness processing explicit in main loop, instead of by callback from RX_ByteNW.
2010-10-05 Implemented: ~ change-sign (postfix negate) k chec(K)sum toggle [type twice, in a packet of its own, to Kill chec(K)sum] x e(X)clusive (singleBMU interaction mode) <ESC> ESCape from eXclusive mode
2010-10-07 Made special link value that used to print as ?000, print as Q000.
2010-10-10 The debugger is ready for first test, though nowhere near finished yet. It has a ReadByte loop now. Improved copying of calibration values to RAM.
2010-10-11 Cleaned up measurement code for link voltages; might not have set P1.3 to analogue mode sometimes Finished converting 'c' command from old code; tested Added a version of measAndCal to debugger.d43
2010-10-14 Fixed a few copy and paste typos Set up P1OUT after all, in case need errorFlash Fixed data version logic Fix missing # on call to initialise Update command tested and working now
2010-10-15 Prettyprint works in the current output radix now (even for 'r' command which would normally want hex). Added 'g' and 'z' commands. Deleted some unused flash programming code. Moved 'i' code, though 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
2010-10-17 Changed comments. Deleted unused conditional assembly flags.
2010-10-17 Added interpreter project to celltopbmu.eww. Changed some command letters in interpreter to agree with monitor and debugger. Changed millisecond commands in interpreter to assume 4 MHz clock. In moni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
2010-10-18 Use structured control flow macros to avoid $+2+6
2010-10-18 Turned off FET debugger options: System breakpoints: PutChar and GetChar, in interpreter.ewd and BSLwriter.ewd.
2010-10-19 Removed now-unnecessary clearing of the watchdog timer in "i" command (no longer needed since the result is written to RAM, not flash-programmed) Renamed monitor target from cellmonitor.hex to monito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
2010-10-20 Added slash '/' as synonym for '|' EXIT/comment command and made PrettyPrint output the slash. Output only 2 digits for temperature and change emitNum to never use less than 2 digits irespective of h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
2010-10-23 Adding the PCB folder. These were originally called bms_digital_panel41.ddb (Protel Design Explorer 99) bms_digital_with_sense2.ddb (also Protel; this has just one board with the end-of-row circuit r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
    [bms_digital.xls]
2010-10-24 Replaced the 7M bms_digital_panel.ddb with the 1M bms_digital_panel.zip Compressed bms_digital_with_sense.ddb with the Protel utility Added bms_digital.ddb (single BMU version, the one that is modifi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
    In the previous checkin, I incorrectly named the original file as bms_digital_panel41.ddb; it was bms_digital42_panel.ddb
    This is the canonical checkin for Rev 41 BMU PCB files.
2010-10-28 ReadMe.txt: Added description of PCB folder. common/definitions.txt: Changed descriptions 'b' to uppercase 'K' for KillBadnessSending (toggle). Assigned 'b' to local badness. 'c' for commsState (moni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
2010-10-29 Fixed bug I introduced into "measure" at last commit. And another of long-standing where the ADC core and reference were left on all the time, after the first call of "measure". Previous commit fixed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
    Restored optional buffered version of "measure" selected by "NOBUF=0" conditional assembly.
2010-10-29 74 bytes free in monitor now. Wohoo! I factored the common code out of "measures" and the 'v', 't' and 'l' commands and put it in common/measure.s43 as 3 routines called cellV, temp and linkV.
    Changed ADC10 to use MCLK and divide it by 2 itself. That way we're free to do what we like with SMCLK for the timer. Not that there's anything we need to change there AFAIK.
    Renamed measAndCal to measAndScale since the values it returns for temp and linkV are not fully calibrated.
    Changed 'c' for commsState to 'r' for RxState and made it return ticks since last Rx. Monitor only.
2010-11-02 There were no changes to the monitor code, but I have finally made it possible to bootstrap-load a new monitor using only TeraTerm or Hyperterminal. I have set the appropriate options in Projects/Opt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
    I added comments in monitor.s43 (near the end) regarding the necessary linker options.
2010-11-09 Applied the 'three wire rotation', e.g. processor pin 1 is now BYP
2010-11-12 Combined the diffamp and regular PCB artwork and schematics into one new file, bms_digital_diffamp.ddb. bms_digital.ddb is now deprecated; soon to be deleted. Rev 44 on the artwork; 2% capacitors are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
2010-11-15 Routed VREF+ to diff-amp at the expense of the FAN net. Cosmetic work on schematic.
2010-11-25 Rev 46. Made the layout of all the common components, tracks and vias the same in both iTX and diff-amp flavours. Added a pad for manual wiring of Fan net on diff-amp BMUs. Added note to schematic ab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
2010-11-25 Deleted the obsolete single-flavour .ddb file in favour of the one with both isolated-transmit and current-shunt-differential-amplifier variants ("flavours").
2010-12-14 no idea what changed
    [bms_digital.xls]
2010-12-29 Error LED goes on when any badness now minLEDbad is a new define for the badness threshold to turn on the LED monitor and debugger projects generate .hex instead of .bin now Removed some unused defin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
    [bms_digital.xls]
2010-12-29 Changed the 'a' command in monitor from r(a)w-voltage to (a)larm, as a toggle, which causes the affected BMU to stop sending badness information except by sending BELL characters when badness is non-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
2010-12-30 [f was Fetch word (peek word)] Saved space by using tables instead of CASE statements for translating sub $60 bytecodes and characters that specify calibration types. Reinstated watchdog timer use. C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
2011-01-04 New folder for BMS master(s). Initial checkin is of original source code for Tritium Driver Controls
2011-01-04 Some changes to compile under gcc Some custom hacks for using a CAN bus Elcon charger Other minor enhancements
2011-01-14 Rev 47: added dual diode D4 to hopefully make bypassing failsafe. That is, if the cell falls below about 3 V, the bypass transistor won't turn on.
2011-01-18 makefile makes verbose asm files if requested later .eww file version back to 500 kbps CAN bus speed added ASSUME_IGN_ON define, so the charger DCU doesn't need ignition on Added chgr_transmit(), UAR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
    [tri86.c, usci.c]
2011-01-20 LEDs on port5 now; restored handling of LEDs CAN_ACTIVITY -> ACTIVITY (RS232 or CAN) skeleton code to do something with received charger packets charger timeout and resend events variable for charger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
    [tri86.c, usci.c]
2011-01-25 Added Driver controls mods.gif image (needs LED mods completed)
2011-01-26 Transmit serial to charger, not CAN Remove hello world testing Moved some variable to tri86 so all code can access it Minor bug fixes: ignore key switch properly; turn on 5 V Declare more variables a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
    [tri86.c, usci.c]
2011-01-29 Attempt at implementing a simple charger algorithm (not finished yet)
2011-01-30 Strikethrough on PMV31 MOSFET in spreadsheet; removed from circuit diagrams Changed layout to make two diodes in series with the bypass transistor the default. Can still go to one diode by bridging a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
    [bms_digital.xls]
2011-02-01 Added code to drive second serial port (USC1A) as BMU string Added CHGR_CURR_DELTA to allow faster charger current ramps Process badness as an event
2011-02-01 End of charge check
2011-02-02 Parse the voltage response string correctly End of charge condition is 3.59 VPC minimum, was 3.60 VPC Initialise chgr_curr_cell at right place Fixed format string for sprintf for sending voltage comm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
    [tri86.c, usci.c]
2011-02-03 Comment out endless loop with ADC12 code; no idea why it's looping now Fix some, not all, errors with timing variables; is still sending voltage request to BMUs incorrectly Replace "sprinf" call with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
    [tri86.c, usci.c]
2011-02-04 R13 was listed as 1K0; we've made it 1K5 since we already need that value for R14, and the brightness of the yellow LED seems the same
    [bms_digital.xls]
2011-02-04 Rev 49: remove solder blob from under D4 Angled "arrows" on solder mask to distinguish them from component outlines Fixed spreadsheet: R15 now 750R, fixed R10
    [bms_digital.xls]
2011-02-04 Rev 50: Moved center of board to 2000,2000 in absolute terms. Added instructions to schematic saying to Edit/Origin/Reset before generating Gerbers and NC Drill files (to make them line up). Then set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
2011-02-04 Implement a round-robin voltage check that runs off badness coming from the BMU string. On all cells bypassing, there is a soak at 0.5 A for 5 minutes, then the charger is turned off. Added a workaro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
    [tri86.c]
2011-02-07 Move the charger soak timing logic inside the test for a timer event (was timing out way too quickly) Added test for CHGR_END_CHARGE so we don't send a voltage check at the end of charge
2011-02-09 If there is an unknown data version, instead of stopping with an error code, program as if it is the latest data version, then stop with the error flash code In errorFlash, set the frequency calibrat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
2011-02-09 monDefinitions.s43: Changed 'a' (alarm) command to take a boolean parameter instead of being a toggle. definitions.txt: Updated for change to Alarm command. comMisc.s43: Handled case of checksum = ca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
2011-02-10 comMisc.s43: Handled case of checksum = any control character by stuffing a space, but code is commented out for lack of space. serialio.s43: Added comments to transmit routines "Preserves R8. Trashe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
2011-02-10 Fixed bug where unbuffered ADC10 conversion was reading same value 16 times. Needed to clear interrupt flag after each conversion. Fixed bug where ADC10 buffer would be overwritten by text input buff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
2011-02-16 Preserve the link calibration value (why was this ever commented out?)
2011-03-01 Added resistor, diode and capacitor to detect a break on the serial input and cause it to reset the processor. Changed red error/activity LED to a bicolour LED with blue for activity and red for erro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
2011-03-01 Removed square outline used for alignment. Bumped rev number to 52 and month to Mar/11. Made creepage distance of rotated isomer as good as standard isomer. Added "ACT" text for blue LED. Added "+" s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
2011-03-02 Added TC Charger folder and charger_interface2.gif (circuit diagram of the charger interface)
2011-03-02 Changed RX, uTX and iTX pads to increase hole size from 40 to 48 mil (1.2 mm) and diameter from 80 to 100 mil (2.5 mm) and spacing between centres from 100 to 120 mil (3 mm) and to put them in lines 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
2011-03-03 Enlarged LI and LO pads and holes same as RX and TX. Made square 90x90 mil pads for iTX- and Chas. Swapped order of RX pads to agree with uTX (iTX still reversed). Moved via away from candy-cane rout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
2011-04-04 Rev 55. Pads for external wires have been enlarged on the diffamp board as they are on the iTX board (Sheet5.SCH and Unrotated.PCB). All the parts in common between diffamp and iTX boards have been m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
2011-04-10 Change the debugger so it doesn't immediately write a new BSL on power up. This immediate flash writing could happen when the cell and hence processor voltage is less than the 2.2 V needed to guarant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
2011-04-10 Made BSLWriter use the forced 4MHz clock cal value for its own operation, instead of using whatever random garbage might be in infoflash, when the FORCEFCAL4 conditional assembly flag is set.
2011-04-15 Added comments re 1p command not working (till we can control REFOUT correctly) Various improvements to the charging algorithm in Driver Controls
    [bms_digital.xls]
2011-04-20 Changes required to use MSP430G2452 (8k flash) and the diffamp for current measurement. Made BSLWriter and debugger check for $FFFF at $10C4 for new chip. Made debugger and monitor turn on the voltag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
2011-05-06 Use MCLK = DCOCLK/2 = 8MHz/2 Version 6 data Password is now ^C^B^A^@ Use ADC10 cal data from unprogrammed G2452 VoltCal is now a word Flash program and compareImage loops use bytes now; use xxxDataSt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
2011-05-06 Fixed frequency calibration transfer from V5 data to V6 Fixed voltage calibration Removed unused definitions
2011-05-06 Fixed voltage calibration (part of previous checkin)
2011-05-06 Problem with JTAGging BSLWriter on ASUS netbook (#M4) seems to be fixed. Don't know why. IDs are now preserved by BSLWriter unless RESETIDS = 1. In monitor fixed 'q' command by adding watchdog reset 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
2011-05-08 Trying to track down reason for 5 mV jitter in monitor voltage readings compared to 1 mV for debugger. In monitor.s43 made P1DIR init same as in debugger.s43. Removed ROTATE3 conditional assembly. Ad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
2011-05-13 ADC10CLK = ADC10OSC/3 innsread of MCLK/2 for stability of ADC readings (especially the monitor) Added #if WATCHDOG NOBUF -> ~ADCBUF
2011-05-21 First cut at implementing Dave's pedal algorithm. Untested.
2011-05-26 Simple hacks to force Driver Controls into SW_MODE_D (drive mode). For testing only.
2011-05-29 MVE added code to clear 7 ADC12 interrupt flags
2011-06-01 Removed "cut-throat" of can_transmit so we can talk to the WaveSculptor. Polled busy bits for ADC10 and ADC12 instead of interrupt flags. Tried to improve readability of pedal regen code. Deleted MIN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
2011-06-03 Changed print setup of Driver Controls mods.gif to portrait so it fills the page. Cleaned up REDn and GREENn LED modification and eliminated writes to GEAR_LED_1 and 2. Added test avoiding buffer ove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
    [tri86.c, usci.c]
2011-06-12 Wrote procedure for performing modifications to Tritium Driver Controls unit for async serial comms with our BMS and charger, and Mike updated the schematic to match.
2011-06-12 Fixed some typos in the Driver Controls mods.txt procedure
2011-06-12 Added missing "3.3V" to R44
2011-06-12 Minor mods, mainly labels on 3.3V and names of external signals
2011-06-13 Minimum and maximum cell voltage in 0x266 CAN packet Changes for front panel LEDs on port 4 Ignore gear change inputs Moved setting of EVENT_ERROR to central function for ease of debugging Charger ev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
2011-06-14 Set can.address_ext for 0x266 packet Comment dubious case label; should make no difference since we're not using the Elcon charger over real CAN
2011-06-17 Fixed apparent Tritium bug where motor_rpm was being set to vehicle velocity (m/s).
    [tri86.c]
2011-06-25 In DriverControlsMods.gif, changed "RX" labels to "RX-".
2011-06-25 Commented out CAN "printf" debugging in process_pedal. REGEN_MAX = 1.0. Initial BMU_MINMAX event. Treat as acked when correct cell id received. Show fault LED on timeout. Number of cells = 28. Test c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
    [tri86.c, usci.c]
2011-07-08 In common/measure.s43 cleared sum of samples where it used to be cleared by preceding loop. In master/tritium/tri86.c added and then commented out code to delay 1 ms between sent characters. In maste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
2011-07-09 Removed Rev 274's fiddling with stop bits. It didn't work, and after some thought, with interrupt latency and the receive and transmit buffers, it will always be ineffective.
2011-07-09 In monitor.s43 increased Rx buffer size from 4 bytes (3 used) to 8 bytes (7 used) to eliminate dropped bytes in chain of 28 BMUs doing repeated v commands.
2011-07-09 Added checksum code; untested, so disabled for now Removed code for using 2 stop bits; didn't fix the missing characters and never will
    [tri86.c, usci.c]
2011-07-11 Changed monitor and debugger initialisations to only clear variables in RAM, not all of RAM, to avoid clearing the stack. Got rid of the warning about a multiple-defined macro when assembling the mon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
2011-07-12 Switched back to the old (stack-using) version of emitNum to free up enough flash to implement the following. Enforced a 40 character limit on the Text Input Buffer (packet buffer) so it cannot run i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
2011-07-13 In serialio.s43, replaced #TAIV_TACCR1 with #2 because when we switch from MSP430F2012 to MSP430G2452 its name changes to #TA0IV_TACCR1 (zero inserted) for no apparent reason. Fixed emitNum (stack-us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
2011-07-14 Changed monitor initialisation so it does not clear worstBadness. Changed description of the character that follows a measurement from "unit" to "type", e.g. 'T' for 'Temperature'. Fixed worst-badnes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
2011-07-23 Partial implementation of a proper queues for bmu and charger I/O. Not complete yet, but compiles.
2011-07-28 Declare highly inlineable functions as static, so the compiler doesn't have to emit code for their bodies Fixed queue_length verses queue_space logic TX interrupts disable themselves when queue is em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
    [usci.c]
2011-07-28 Mainline uses chgr_lastrx and bmu_lastrx instead of interrupt queues now Added functions like bmu_getByte() and bmu_queueLength() for tri86.c to call
2011-07-28 Fixed another logic error in queue_space(). Don't check for dequeue() failure in the transmit interrupt routines, since it can never happen.
    [usci.c]
2011-11-25 Removed duplicated code from interrupt routines, that belongs in main line
2011-12-02 Removed queue_length() and made the getByte() functions return a bool with true on success. Code using queue_length() seemed to be inserting nulls into the bmu buffer
2011-12-04 Fixed bug where bmu_queueEmpty() and chgr_queueEmpty() mixed tx and rx pointers. Renamed them to bmu_tx_queueEmpty() and chgr_tx_queueEmpty().
    [tri86.c, usci.c]
2011-12-09 Temporary changes to allow inspection of bad checksum packets. Lots of things commented out with "FIXME!!!" just to get enough code space.
    [tri86.c]
2011-12-18 Output checksum and carriage return after bad packet from q command. Output residual checksum as a number, not a character. Added clearing of bad packet on { command. Renamed "checksum" to "RXCksum".
2012-01-12 Changed so any bad packet that gets recorded is terminated by carriage return and only that packet up to its CR is reported by "q" command.
2012-02-08 Update all .ewp and .ewd files to IAR version 5.40. Uncomment the EMIT routine in comDefinitions so debugger will assemble.
2012-02-09 Fixed the command to turn on checksumming; if checksumming is off, it would actually keep it turned off by sending "kk\r"
    [tri86.c]
2012-02-09 Enable charger code; set for 73 cells and 19 BMUs
2012-02-09 In Driver Controls mods schematic, added LED GEAR BL pin 14 going to iTX 12V.
2012-02-09 Removed CHGR_NEEDS_CAN code Removed other charger CAN code Fixed uninitialised charger off (i.e. chgr_txbuf[8] bug when soaking Defined CHGR_SOAK_CURR since BMU bypass capacity will be changing
    [tri86.c]
2012-02-11 Uncommented next_state code so MODE state machine could change from Drive to Charge and back. Renamed SW_FUEL to SW_FUEL_DR_OPEN. Corrected and expanded comments regarding turning BMU checksummming o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
    [tri86.c]
2012-02-12 Weber's updates; I only added that the .sch file is in the PCB folder. Includes instructions on enabling libraries that appear greyed.
2012-02-24 Re-enabled CAN_PWR_OUT logic to power the CAN bus. This was accidentally commented on in Rev 331.
2012-02-24 Send min and max cell voltages to CAN bus even if not driving (i.e. while charging). This is so we can watch the maximum cell voltage in the telemetry window while charging.
2012-02-26 First version of celltop BMU schematic in DesignSpark
    [CellTopBMU.sch]
2012-02-27 Almost complete DesignSpark schematic. Need piezo and LED part numbers. Beginning of moving BMS related code from tri86.c to new files bms.c and .h
    [CellTopBMU.sch]
2012-03-01 I believe the schematic is complete, apart from supplier catalog numbers (which are not required to generate a PCB).
    [CellTopBMU.sch]
2012-03-02 Made a start on the PCB in DesignSpark.
    [CellTopBMU.pcb, CellTopBMU.sch]
2012-03-04 More progress with blue side of the board. Added "connect" pad style (16 mil pad, no hole) for connections that are made when the middle part of the board is rotated.
    [CellTopBMU.pcb]
2012-03-04 Restored correct resistor and capacitor values. Flipped dual LED footprint and called it "Dual LED (shine thru PCB)". Changed order of Err LED and its resistor. Routed dual LED.
    [CellTopBMU.pcb, CellTopBMU.sch]
2012-03-05 Most of the stuff from the Protel artwork has has now been laid out and is passing DRC. The central rotating region is complete except for the cell terminal pads. SOT-23s need smaller pads to match P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
    [CellTopBMU.pcb, CellTopBMU.sch]
2012-03-09 Right angle IFO footprint; 2510 resistors; 3-pin Phoenix connectors; fixed some rotation connections; rotated opto
    [CellTopBMU.pcb, CellTopBMU.sch]
2012-03-10 Increased number of bypass resistors to 8 and placed them roughly symmetrically. Changed phoenix connectors back to 0.1" headers. Changed layer colours to match Protel.
    [CellTopBMU.pcb, CellTopBMU.sch]
2012-03-10 Bypass resistors 2512 size; added R9a-R9d; changed value of R12; minor track improvements
    [CellTopBMU.pcb, CellTopBMU.sch]
2012-03-10 Sorted out R19, C7, Q2, R10, D5. Moved bypass resistors around a little.
    [CellTopBMU.pcb, CellTopBMU.sch]
2012-03-11 Fixed logic error in makeVoltCmd(): was not sending tens digit if required by a hundreds digit The split of functions into bms.c and queue.c is complete enough now to compile Added some dependencies 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
    [tri86.c, usci.c]
2012-03-11 Finished laying out the south side components (except bypass resistors).
    [CellTopBMU.pcb, CellTopBMU.sch]
2012-03-11 North area red side components routed. Major progress on the bypass resistors. The West-Southwest one needs more work.
    [CellTopBMU.pcb, CellTopBMU.sch]
2012-03-15 Fully placed and routed with no design-rule failures. Still needs cell terminal holes and copper pours (filled polygons). Rotation catered for, but not tested. The bypass circuitry now rotates. i.e. 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
    [CellTopBMU.pcb, CellTopBMU.sch]
2012-03-16 First version where the mid-section rotates (saved as rotated isomer). Result of an EV day's work by Mike and Dave. Has bypass resistor heat sinking copper pours. Has routs in new layer "Unplated int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
    And still need to do squiggle joins.
    [CellTopBMU.pcb, CellTopBMU.sch]
2012-03-17 More clearance around unfused Cell+; vias over large pads for terminals; minor tidy-ups
    [CellTopBMU.pcb, CellTopBMU.sch]
2012-03-17 Thickened some ground tracks; added plus and minus signs; added tracks from processor grounds to thermal pad
    [CellTopBMU.pcb]
2012-03-17 Re-created the group selection; unrotated the middle section; fixed a few errors due to rotation.
    [CellTopBMU.pcb]
2012-03-17 Made board outline symmetrical. Added two slots under the opto and at 180 degrees from there. Added another bottom documentation guide-line. Removed unused other guide-lines.
    [CellTopBMU.pcb]
2012-03-18 Added text to bottom and top silkscreen layers. Centred slots under opto-coupler. Added keep-out area for P6. Still have squiggle joins to do.
    [CellTopBMU.pcb, CellTopBMU.sch]
2012-03-19 Moved the LEDs to clear bypass resistors better. Made board edge slots for LEDs. Put routs in cell terminal pads in the board-edge "layer" as outlines. Made bypass resistor layout more symmetrical. T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
    [CellTopBMU.pcb, CellTopBMU.sch]
2012-03-20 Schematic made publishable (screen shot posted on AEVA). Cell terminal slots and squiggle joins done in board outline "layer". See 3D/3D View.
    [CellTopBMU.pcb, CellTopBMU.sch]
2012-03-20 Fixed C&W library footprints so thru-hole parts appear on the correct side of the board in 3D view. They need to be mirrored in the PCB file, not in the library file.
    [CellTopBMU.pcb]
2012-03-21 Changed semi-octagonal positive end to semicircular so outline doesn't need to rotate. Routed squiggle-join tracks. Switched the order of layers Bottom Silkscreen and Bottom Copper back to the defaul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
    [CellTopBMU.pcb, CellTopBMU.sch]
2012-03-22 Flipped squiggle-joins and rerouted tracks to maintain 90 mil creepage between soldered copper and 70 mil between masked copper in the SE area.
    [CellTopBMU.pcb]
2012-03-22 Added more area to the SE bypass resistor heatsink, with a circular and rectangular keep-out pour to keep the creepage distances the same.
    [CellTopBMU.pcb]
2012-03-22 Enlarged corner heatsink areas as suggested by Mike
    [CellTopBMU.pcb]
2012-03-22 Reduced the thickness of reference labels, and 48 mil high text on the silkscreen layers. Improves readability.
    [CellTopBMU.pcb]
2012-03-23 Made JTAG pads bigger, and lotsa other stuff.
    [CellTopBMU.pcb]
2012-03-23 To workaround the lack of panellisation in DesignSpark we have hidden the real Names (designators/references) and created Values called "Name" with the same info. This is so the copies don't get auto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
    [CellTopBMU.pcb]
2012-03-24 Update panellisation procedure to rotate the upper board; has to be original board.
2012-03-24 Cleaned up blue tracks near JTAG connector Moved some text away from other silk screen items
    [CellTopBMU.pcb]
2012-03-24 Re-added LO tracks to Rotatables group; removed arrows from group; added arrows to their own tight group; added GND via and increased ground copper pour slightly
    [CellTopBMU.pcb]
2012-03-24 Fixed a minor but crucial error in the top documentation layer, that led to seven errors in the panellised string of 8
    [CellTopBMU.pcb]
2012-03-24 Turned off hilighting of LO net. Changed net highlight stripe colour to cyan. Changed dangling track stripe colour to purple. Turned on non-45-degree-multiple track stripe and set to grey. Straighten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
    [CellTopBMU.pcb]
2012-03-25 Added outline for 8 joined BMUs (by deleting all but second-bottom BMU from panel of 8 made by Mike and unrotating its mid-section). Added the new GND via to the Rotatables group. Remade the arrows o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
    [CellTopBMU.pcb]
2012-03-25 First pass at a daughter board for the IFO connectors.
    [CellTopBMU.pcb]
2012-03-25 IFO daughter board complete and able to be mounted either (a) horizontally within the cell footprint, pointing away from the RX or TX header, or (b) vertically down the side of the cell. Usable for e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
    [CellTopBMU.pcb]
2012-03-26 IFO daughter board completed ready for checking.
    [CellTopBMU.pcb]
2012-03-26 Widened the narrowest part of the daughter board to eliminate two P-B errors (actually hole-to-board-edge errors). Made all rotatable bottom silkscreen text run south to north, same as rotatable top 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
    [CellTopBMU.pcb]
2012-03-27 Changed holes for breaking off daughter-board tab from 50 mil to 48 mil (more like a multiple of 0.1 mm). Nudged a few component designators away from vias.
    [CellTopBMU.pcb]
2012-03-28 This is the first version to be sent to PCBcart (as a string of 8). Deleted multiple BMU outlines from Top Documentation layer. Changed Top Silkscreen + and - signs from characters to lines so they d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
    [CellTopBMU.pcb]
2012-03-28 Added "DANGER HIGH VOLTAGE" text on squiggles in largest possible Arial.
    [CellTopBMU.pcb]
2012-03-28 Made opto-RX GND stay separate from Bypass GND after rotation.
    [CellTopBMU.pcb]
2012-03-29 Moved IFO header RA and ST pad centres 16 mil apart as suggested by PCBcart so they would not break through to each other. Changed revision number text to "rev 57". Uploaded new 8 BMU board files to 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
    [CellTopBMU.pcb]
2012-03-29 Added all the "Name" values (hidden) to the schematic so it is safe to Forward Design Changes to the PCB again. Restored lost "Value" value of C6 to "100u 16V". Forwarded schematic changes to the PCB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
    [CellTopBMU.pcb, CellTopBMU.sch]
2012-03-30 Added E14, Digikey and Mouser URLs to some parts. Added P7 and P8 parts, 4-way right angle headers (with 2 middle pins removed) for optional IFO daughter boards.
    [CellTopBMU.sch]
2012-04-02 Added reverse blocking diode and reduced to one failsafe diode in series with the bypass MOSFET gate. Changed high divider resistor R11 to be 3 resistors in series, like R9. Change R9 and R11 to high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
    [CellTopBMU.sch]
2012-04-05 Re-arranged near D2 and R13 to make space north of U2. Started attempting to lay out R11 a/b/c. Bad mess.
    [CellTopBMU.pcb, CellTopBMU.sch]
2012-04-05 Triplicated R12 and increased values of R7 thru R12. Added C8, a 1F 2V7 supercap. Relocated and rearranged the triplicated resistors R9, R11 and R12 so the two isolation regions are more obvious on t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
    [CellTopBMU.sch]
2012-04-07 Completed PCB layout of version with blocking diode and three resistor ladders and supercap. Designed to not arc when subjected to 866 V in reverse or 63 V forward. It may even survive such events.
    [CellTopBMU.pcb, CellTopBMU.sch]
2012-04-08 Got rid of vestigial middle pads from P7 and P8 (IFO headers). Enlarged blue heatsink copper pours. Added central GND copper pour on red side, same size as on blue side. Moved text away from via hole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
    [CellTopBMU.pcb, CellTopBMU.sch]
2012-04-08 Moved C8 north to fix problem of interfering with C6 as suggested/noted by Mike. Moved various text items in response.
    [CellTopBMU.pcb, CellTopBMU.sch]
2012-04-09 Added bms.c and queue.c to the gcc project
2012-04-09 Work with all 19 BMUs (testing) Replaced constant 9 with BMU_BYPASS_CAP Don't send voltage request in response to receiving badness
2012-04-09 Move the resend packet code from the timer interrupt routine to the mainline, via CHGR_RESEND and BMU_RESEND events
2012-04-09 Don't increment current BMU number if the last packet wasn't valid or was for the wrong BMU number
2012-04-09 Corrected some typos made in a last minute bugfix attempt.
    [tri86.c]
2012-04-11 Corrected a couple of comments
2012-04-11 Added charger.c, charger.h, and moved charger related functions and data there Separated events and state for BMU and charger Added bmu_timer() and chgr_timer() chgr_soaking -> chgr_soakCnt Added han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
2012-04-12 Added charger.c to the project (gcc.ewp) file
2012-04-13 Eliminate BMU_RESEND event. Move bmu_timer() and chgr_timer() from from interrupt handler to main loop in response to EVENT_TIMER. Move readBMUbytes() and readChgrBytes() to part of main loop where t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
    [tri86.c]
2012-04-14 Moved bmu_sendVoltReq() call to inside of if (bmu_id == bmu_curr_cell) and if valid voltage response. And other changes to help with debugging.
2012-04-14 Back to optimisation level -O2 and re-enabled resend of voltage reqest on timeout.
2012-04-14 Re-enabled sending of \CHG messages. Tested. Charging works again!
2012-04-15 Changes to schematic and PCB in response to assembling and testing rev 57 PCBs. Quick-n-dirty change to BSLwriter to make blue activity LED do something on rev 57 PCBs.
    [CellTopBMU.pcb, CellTopBMU.sch]
2012-04-16 Many small changes arising out of testing the rev 57 PCB.
    [CellTopBMU.pcb, CellTopBMU.sch]
2012-04-16 Increased the minimum clearance around the LO net from 10 mil to 14.7 mil (15 mil in most places) in the hope of increasing the chance that the BMU will survive a high-R link or cell event.
    [CellTopBMU.pcb]
2012-04-17 Straightened out the R9abc staircase. Removed heatsink copper-pour area projecting into the "wing" from the junction of D1 and F1 because it would be sitting against the copper link between cells. Ad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
    [CellTopBMU.pcb, CellTopBMU.sch]
2012-04-17 Conditional assembly of BSLwriter, for PCBVERSION < 57 or otherwise, is no longer quick-n-dirty, but done properly. Still 6 bytes free in BSL. But pass-on-break on reset not implemented yet.
2012-04-18 In BSL, slowed watchdog clock by a factor of 8 (now 32 ms). A reset BMU will now send a 27 ms break to reset the next BMU. Updated Monitor, Debugger and Interpreter to use the new BSL on the pre-v57 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
2012-04-19 All BMU software (BSL, BSLwriter, debugger and monitor) has now been updated to operate on the rev 57 boards with the blue activity LED and different micro pin assignments and break-to-reset. All hav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
2012-04-20 Added to schematic, Digikey part number for D1. Added to debugger, initialisation for 3 kHz ACLK to drive piezo, and modified 'e' command to turn the piezo on and off as well as the red LED. Tested O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
    [CellTopBMU.pcb, CellTopBMU.sch]
2012-04-29 Changed 2.5 V regulator to NCP699SN25. Changed blue and yellow LED resistors to 39R and 560R and IFO PT pullup to 470R. Changed D6 (in IFO voltage doubler) to MBR0520L schottky. Can't get Value: Name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
    [CellTopBMU.pcb, CellTopBMU.sch]
2012-04-30 Changed fuse from 1206 to 2410 size to get voltage rating up from 63 V to 125 V. Increased rating from 750 mA to 1 A to allow for temperature and vibration. Changed yellow text "Digital BMU" to "Batt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
    [CellTopBMU.pcb, CellTopBMU.sch]
2012-04-30 Changed R8 to 1% 1M0 to take advantage of lower price than 1% 1M2. Changed R4abc and R9abc to 160k+180k+160k = 500k to match R8 = 1M0. Added several "E14" values (Element 14 URLs for parts).
    [CellTopBMU.pcb, CellTopBMU.sch]
2012-04-30 Added pads to allow for optional supercap with 8 mm dia and 3.5 mm lead spacing. Unfortunately such a supercap will hang over two edges of the board by about 0.7 mm.
    [CellTopBMU.pcb]
2012-05-03 Increased LI to IFO creepage from 30 to 62.5 mil. Changed reverse blocking diode D1 from SMA to SMC size (big). SMA can still be used.
    [CellTopBMU.pcb, CellTopBMU.sch]
2012-05-04 Implemented a myriad of creepage and heatsink area improvements suggested by Mike. Ready to get 30 boards (248 BMUs) made. Rev 58.
    [CellTopBMU.pcb]
2012-05-04 Fixed several problems with the LO net 14.7 mil clearance being violated. Also problems with Names being shown instead of "Name" Values on new components like the big diode, the supercap and the IFO 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
    Prevented the PCB from being a solder-paste spaghetti machine. I got all via holes off SMD pads, cut back LED and IFO mounting pads where they were hanging over the board edge, and I figured out how to make that IFO pad with the different sizes on the two sides work properly. It doesn't appear in the paste mask at all now, but still has the right sized hole in the solder mask.
    [CellTopBMU.pcb, CellTopBMU.sch]
2012-05-06 Added 125 mil mounting hole near OP1 so manufacturers can screw it down to fully rout the outline. Changed D1 to S8MC. Added some parts URLs. This was "panelised" and gerbers/drills sent to PCBcart a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
    [CellTopBMU.pcb, CellTopBMU.sch]
2012-06-01 PCB schematic: updated month April to May Added common/common.h for definitions like PCBVERSION and FLASH_START Set FLASH_START tp $E000 for 8k flash chips Changed bsl.s43 to use FLASH_START rather t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
    [CellTopBMU.sch]
2012-06-15 Experimental: use /8 instead of /3 for ADC10CLK. IImproves accuracy of link voltage 5%, and seems to reduce jitter on ordinary voltage measurements as well
2012-06-15 Reverted the /8 for ADC10CLK mod; seems to upset the monitor. Changed so now only the link voltage command uses /8
2012-06-22 Fixed bug where q command was falling thru to { command.
    [CellTopBMU.pcb, CellTopBMU.sch]
2012-06-22 Moved 'm' command from comDefinitions.s43 to debDefinitions.s43 Added a reset of the watchdog when measuring, for slower ADC samples Comment out 'b' command in 2K versions Moved badness table to make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
2012-06-22 More digikey component URLs added. BSLwriter and interpreter .ewp files changed to MSP430G2452.
    [CellTopBMU.sch]
2012-06-23 Added a heap of URLs for parts, mainly for Digi-key
    [CellTopBMU.sch]
2012-06-30 Changed red LED resistor to 470R. Completed Digikey URLs for everything.
    [CellTopBMU.pcb, CellTopBMU.sch]
2012-07-21 Changed paste-mask from 3 thou reduction to 2 thou enlargement (same as Protel) to give better paste coverage on microcontroller and other small pads.
    [CellTopBMU.pcb]
2012-07-27 Used $PROJ_DIR$\..\common for the path to the .ddf (device description) file, to avoid absolute path names that will change from computer to computer
2012-08-04 Moved "octave setting"" code to where a new chip is discovered Changed debugger config for the BSLWriter project to use $PROJ_DIR$ Added jInterpretByte vector to the BSLWriter project Started PCB/Tes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
2012-08-04 Fix or -> bis Initialise voltage and temp calibrations to $8000, not $FFFF
2012-08-04 Reduced R13 (the yellow LED's resistor) from 470R to 82R to give reasonable yellow LED brightness.
    [CellTopBMU.pcb, CellTopBMU.sch]
2012-08-11 Schematic changed to have correct part number for right-angle headers. Testing procedure extended.
    [CellTopBMU.sch]
2012-08-13 Enabled any printable ASCII character to be defined as a command, instead of only lowercase letters.
2012-08-13 Added '<n>z' command to send n nulls with no gaps. Max of 256. For testing for false positives in break-to-reset circuit of following BMU.
2012-08-14 Added piezo initialisation to monitor, same as debugger. Added 'Q' for 'Quiet' command to both monitor and debugger. 1Q prevents piezo from beeping, even when error LED is on. 0Q restores normal beha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
2012-08-17 Removed all references to PCBVERSION; for older boards, we'll now have to use older software.
2012-08-17 Added the some- and all- in-bypass logic. Assembles, but is NOT TESTED.
2012-08-18 Fixed a missing ".b" that was causing the type of worst badness not to be reported for the 'q' command Changed the measures logic to not update the worstBadMeas if the current badness is zero. The ef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
2012-09-01 BSLWriter: set most commonly needed octave for checked-in frequency cal value Debugger: initialise L cal value to zero; separate from temperature cal
2012-09-08 Completed the separation of charger code to charger.c. Various items of cleanup, e.g. better handling of pressing F7 or using Project/Make to attempt to compile the GCC code with the IAR compiler.
2012-09-09 Removed the charger "retransmit" logic; we don't get an echo from the charger, so we can't retransmit. However, added chgr_rx_timeout to check that we have received something from the charger in the 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
2012-09-09 Changed paste mask inset/outset to zero. Made test procedure less ambiguous for unskilled labour.
    [CellTopBMU.pcb]
2012-09-16 Pain -> stress or status as appropriate. New 5-bit stress encoding. Assembles, but is not yet functional.
2012-09-19 Fixed bug in monitor where blue LED would always stay on when red LED was on.
2012-09-23 Changed the thresholds as needed for the latest DCU charge algorithm Implemented latest status byte bit assignment Removed bypassVolts RAM location Implemented low temperature stress One last removal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
2012-10-01 First cut at PID control of charger current
2012-10-02 Don't send same-current commands to charger However, send every 5 seconds minimum End of charge logic
2012-10-02 Changed PID algorithm to "velocity form" to avoid integral wind-up.
    [control.c, control.h]
2012-10-03 Converted all code to C++; queues are object oriented now Added queue::empty, inlines properly Added assert2.h PID code still needs proper encapsulation Updated dependencies.in
2012-10-04 Use the hardware multiply and accumulate facility pid::tick() does clipping to +- 1.0 now No set point; pid algorithm works towards zero Adjusted bit assignments yet again; fixed scaling and biasing 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
2012-10-05 Fixed scaling on input and output from pid::tick() Fixed number of cells Ready fix for the can_transmit lockup problem (when debugging)
2012-10-05 Increased Kp, Kd and even Kd to get a more desirable charging response
2012-10-13 Oops bms.c should have been deleted with the other .c files
2012-10-13 Made voltage requests optional, and not continuous (Want to make them overlapped eventually, so the don't take so long) Make voltage limit 3.65 x number of cells Added bms.h and charger.h to the work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
2012-10-17 Eliminated all possibilities for overflow from pid::tick(measure). Untested. Renamed pid::dummy() to pid::tick().
2012-10-19 Changed RESLONG to signed, and PID controller works at last!
2012-10-20 Changed Monitor to send status at a regular 4 Hz. Untested
2012-10-20 Adjusted stress levels down 50 mV, since the PID and charger system seems to bias towards stress level 4. Bypass now down to 3.50 V, so stress level 3 is always in bypass now.
2012-10-20 Adjusted stress levels to be only 25 mV apart; bypass at 3.55 V, suitable for PID set point of 3.0
2012-10-20 In bms.cc, fixed 2 errors in the status encoding table and changed the status mask from $07 to $0F.
2012-10-21 Changed chargePID to the best possible Kp Ki Kd parameters. Explained in comments.
2012-10-22 Got rid of old code that was restarting charging at 1.5 A after charging had terminated normally.
2012-10-25 Prevent resending of "0K{" and "\CHG..." BMS packets. Remove workaround for * 100 compiler bug since it seems to be fixed.
2012-11-05 Some changes to help with debugging DCU code for charging.
2012-11-07 In master/tritium/tri86.h changed fault LED sustain from 200 ms to 10 ms. In monitor, rewrote DoMeasurement (factoring out DoStress) and rewrote DoStatus, all with the aim of making them easier to un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
2012-11-09 Add Mike's schematic and mechanical drawing for adding industrial fibre interfaces to the Tritium Driver Controls Unit. These mods are assumed by the master/tritium/ software.
2012-11-10 Restored logic for leaving the cells in the all-in-bypass state for 5 minutes at the end of the charge
2012-11-10 Fixed a bug in the logic for charge termination Set all-in-bypass time to 1 minute (was 5 minutes)
2012-11-10 Fix another thing causing an erroneous call to fault(): don't decrement chgr_rx_timeout if charger off.
2012-11-26 Renamed "debugger" to "TestICal" (TEST Id and CALibrate), to avoid confusion with the IAR Workbench IDE (JTAG) debugger.
2012-11-27 Added an Init Command String to TestICal to hopefully render BSLwriter unnecessary, even for resetting corrupted DCO frequency calibration values.
2012-11-27 Added code so the modified Tritium DCU's piezo beeper will operate at the same time as its red fault LED.
2012-11-29 Added a monitor command '1f' to mean "Freezing is stress". Modified the DCU master code to send it when going to charge mode and to send '0f' when leaving charge mode.
2013-03-29 Changed from 114 to 109 cells. Changed all_in_bypass to all_near_bypass (for charge termination). Changed bypass level from 3.56 to 3.57 V, leaving near-bypass at 3.56 V.
2013-03-29 Added test for quiescent current <= 1 mA to PCB test procedure.
2013-04-08 Added alternative part number for the voltage regulator (TLV713...)
    [CellTopBMU.sch]
2013-04-19 Fixed problem with DCU switching between charge and drive modes. Raised difference between link stress levels to 30 mV.
2013-04-26 First cut at limiting motor controller current (drive and regen) based on stress levels from the BMUs. Also has some debugging code, so we can test this with fake stress levels on a pot input.
2013-04-26 Use battery current, not motor current, in debugging code
2013-05-03 Fixed the annoying fauly light; was assuming always charging in chgr_timer()
2013-05-03 Fix side effect of last checkin (fixing fault LED and alarm); now there is a CHGR_CHARGING state.
2013-05-13 Testing wavesculptor dc current control by PID loop with BMS stress as input.
2013-05-13 Arranged for bus_current CAN packets to be sent immediately based on output of cell-stress PID controller.
2013-05-17 Added separate PID controller for Drive versus Charge.
2013-05-17 Added BMS status timeout and limp mode and started coordination of two DCUs.
2013-05-17 Added ADC conversion before first call to process_pedal(). Corrected LIMP mapping.
2013-05-18 Turned on power to pedal before first ADC conversion and test for pedal.
2013-05-18 Allowed a time delay between turning on power to pedal snd reading its value.
2013-05-23 Added 20 ms delay to end of adc_init() to allow time for Vref capacitor to charge before checking for existence of pedal.
2013-06-19 Added clock frequency check to PCB/Testing.txt. Increased commsErrTicks from 3 to 9 in monitor to avoid spurious comms errors during v or t commands now that we have 15 ticks per second.
2013-07-11 Merged Advanced/Password and Advanced/Image menus into one Image menu Fixed the lengths of two image selections
    [resource.h]
2013-07-12 More consistent naming of labels After monitor password detect, exit to BSL2 with suitable BSL1 address on stack Fixed bug in monitor password detect Synch interrupt vectors and entry point branches 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
2013-07-29 Set Monitor under and over voltage stress thresholds back to normal so bypass works again. In DCU, doubled size of Charger TX buffer to 32 bytes (untested).
2013-08-02 Rearranged the charger and bms queue classes so that the buffer size is always correct. I should make it so that queue can't be instantiated as a concrete class, but I'm rusty on how to do that clean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
2013-08-28 Added uCharging timer, and logic such that if we have seen charger packets in the last 60 seconds, we don't go to drive mode, and will go from drive mode to charge mode on charger activity. This is f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
2013-08-30 Changed DCU to default to charge mode to prevent drive-off when charger is active.
2013-08-30 bugfixes for charger activity detection
2013-08-31 Cleaned up anti-drive-off code and added charge termination on stress 11. Also distinguished charger idle from charger off.
2013-09-18 Added DCU pin assignments and wiring diagram and truth table for contactor control.
    [Contactors Truth Table.xlsx, DCU wiring.xlsx]
2013-09-20 Implemented contactor drive on brake and reverse outputs Differentiate between DCU A and B using FAULT_NO_PEDAL Implement crash switch logic
2013-09-21 Cleaned up OFF/DRIVE/CHARGE mode code
2013-09-22 Changed charge controller so it only sends a packet to the charger if the requested current has changed or if 500 ms has passed since the last packet.
2013-09-22 No more contactor activity on DCU startup. No more spurious dropping out of charge mode. No more fault() beeping. Can now charge without the key and cannot drive off when charger is powered.
2013-09-23 Tacho code that actually compiles, and better calibrated to our MX-5's tacho.
2013-09-23 Added required initialisation of counter I added in timerB interrupt for tacho
2013-09-27 Define waitingIDAddr in monitor, so it will assemble. Unforutunately, this means we can no longer use the BSL2 that is assembled as part of monitor.bin. This will all be rewritten soon when we rewrit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
2013-10-05 Try a dual linear torque pedal curve with a 5% dead zone (coasting, no power). This is an attempt at a temporary fix for the motor controller field weakening problem.
2013-10-06 Limit charge current to global uChgrCurrLim When receive CAN with ID CHGR_LIM, update this global charger current limit Fixed a typo in pedal.cc that failed compilation Fixed a warning about unused v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
2013-10-08 Choose 1/2, 3/4 or full charge current with a backwards-connected pot on the analog_b input. No pot = 0 V = full charge current. Reinstate Tritium's original no-regen torque-control accelerator pedal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
2013-10-08 Set up a CAN message box for the charger limit data
2013-10-08 Added global bDcuB to simplify code checking which DCU this is Added code to send status from DCUB to DCUA Added code to send CAN packet which should place the stress from half-pack A in the min cell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
2013-10-20 Increase chsrger voltage limit by 2.1% to allow for measurement error of charger-B. Reinstate quadratic regen pedal function, with 40% max regen.
2013-10-25 Treat communications errors on the BMU bus as stress 8 Should cut charge current to zero, end enter limp mode when driving
2013-10-29 Added the following commands to Monitor and TestICal, although most of them won't work properly with TestICal until we eliminate BSL1 and give TestICal more control over echoing. These have not been 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
2013-10-31 Set step size between link stress levels to 1500 mV so spurious link voltage measurements can have no effect on stress.
2013-10-31 Replaced these literals with named constants in bms.cc #define ALL_NBYP (1<<5) #define ENC_STRESS 0x1F #define STRESS 0x0F
2013-11-01 For sending worst stress from DCUB to DCUA, use a CAN ID in the DC_CAN_BASE range. We know this works. I can't figure out why the filter and mask doesn't work for CAN ID 0x7F0/7F2 - Mike
2013-11-01 When driving, consider stress of half-pack connected to DCU-B, and act on stress from worst half-pack. Initialise statusB to zero, in case there is no DCU-B or CAN communications isn't working - Mike
2013-11-01 Separate local and DCUB status bytes Process statusB for charging as well as driving When faking a status byte, add COM_ERR bit
2013-11-03 Restructured handleBMUstatusByte() for better flow and readability (without duplication). Untested. Renamed "bDcuB" to "bDCUb" as described here http://en.wikipedia.org/wiki/CamelCase#Criticism Chang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
2013-11-04 Corrected timer compare register assignments so gauge 2 can work as a PWM simulated resistance to represent stress on the oil pressure gauge.
2013-11-15 Trimmed the PEDAL_TRAVEL constants to the actual accelerator pedal range of the MX-5. Changed the test for pedal presence (DCU-A vs DCU-B) so it isn't fooled by a damaged analog input stage in the MS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
2013-11-16 Use only DCU-A's analog inputs; send current limit to DCU-B
2013-11-16 Increased PEDAL_TRAVEL_MIN and decreased PEDAL_TRAVEL_MAX to allow for noise on the pedal signal when motor controller is running. Added creep -- small torque and rpm with no pedal. Added BUS_CURRENT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
2013-11-16 Send charger currents to tacho during charging: MVE
2013-11-16 Had wrong update rate for charger current counter Was updating the wrong charger current on receipt of CAN packet: MVE
2013-11-16 Fixed bugs in code that displays the two charger currents on the tacho. -- Mike
2013-11-16 Changed so both charge currents are displayed on the tacho whenever we are not in drive mode. Non-charging DCUs should display as zero current. Untested.
2013-11-19 Increase the minimum charge terminstion current from 0.8 A to 1.0 A to allow for high powered accessories like headlights and fan (but not heater) also being powered by the charger via the DC-DC conv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
2013-11-22 Changed DCU code for crash switch moved from GEAR1 to GEAR2 input and LATCHED_START removed from BRAKE input and unlatched START connected to GEAR3 input.
2013-11-22 DCU wiring spreadsheet updated with new connections for (unlatched) START, crash switch, inhibit traction, brake switch, temp gauge, fuel gauge and alternator warning light.
    [DCU wiring.xlsx]
2013-11-24 Don't turn off DCU-B's brake output in MODE_OFF; would briefly turn off brake lights even with heavy regen or actual brake pedal Fixed comment re DCU-B's brake input (comes from DCU-A)
2013-11-24 Updated the diagram significantly. All computer drawn now. Don't know if we want to keep the logic equations on this diagram (two missing, one poorly copied) Partly colour coded wiring.
2013-11-24 Deleted second "A25" DCU pin designation and corrected some descriptions of wires between DCUs, in DCU wiring spreadsheet.
    [DCU wiring.xlsx]
2013-12-02 Improved some comments in DCU code and DCU wiring spreadsheet. Rescaled overvoltage stress so balancing occurs at 3.51 V instead of 3.56 V. Rescaled undervoltage after first run-flat event, to give m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
    [DCU wiring.xlsx]
2013-12-06 Made bsttery stress 1 occur more easily, for earlier warning. Over Voltage: One stress unit for each 20 mV in excess of 3.350 V, to a max of 15 at >= 3.65 V. Setpoint is 3.49 to 3.50 V. Alarm at 3.57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
2013-12-07 Limit tacho to 7000 rpm to hopefully prevent needle wraparound
2013-12-07 Increased the resolution of the tacho gauge output by a factor of 8 by using a timer B compare register to generate the required interrupts.
2013-12-08 Reduced tacho interrupt rate from 80 kHz to 40 kHz. Adjusted tacho calibration function. Commented tacho interrupt routine.
2013-12-08 Fixed bug in tacho interrupt routine. Tweaked tacho calibration. Now +-50 rpm from 1000 to 6000 rpm. Calibrated fuel gauge to show average cell voltage of 3.25 V as empty, 3.30 V as half-full and 3.3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
2013-12-09 For DCU code: Added compiler switches for warnings -Wconversion and -Wsign-conversion. Changed code as required to eliminate all warnings.
2013-12-09 Added the ability to use ignition key momentary start activations to cycle through the 3 charge currents in charge mode (240 Vac: 5 A, 7.5 A, 15 A)(DC 2.7 A, 3.1 A, 5.5 A), and the four tacho display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
2013-12-10 Added DCU code to allow BMS sniff and inject via CAN bus, and hence via Tritium's CAN-Ethernet Bridge.
2013-12-11 Recalibrated fuel gauge after changing switched resistor from 10R to 5R to allow it to reach full before 100% duty cycle.
2013-12-16 Temporarily disabled the charge cable and crash switch inputs where noise on them might cause us to drop out of drive mode, until 1k pullups can be installed in the DCUs to replace the original 10k.
2013-12-22 Initial commit of schematic and PCB for Insulation and current Monitoring Unit (IMU).
    [IMU.pcb, IMU.sch]
2013-12-23 Various corrections and improvements to the Insulation Monitoring Unit's DesignSpark files, including the updated libraries that I should have committed last time.
    [IMU.pcb, IMU.sch]
2013-12-25 Sch: fixed TouchV net PCB: moved manufacturing holes Tidied tracks: red near C6 red near U2 red near OP2, OP3 blue near P8 Centred "HIGH" on blue silkscreen Removed unused vias: Rly2, TouchV Thickene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
    [IMU.pcb, IMU.sch]
2014-01-01 Insulation Monitoring Unit schematic and PCB as ordered from BatchPCB.
    [IMU.pcb, IMU.sch]
2014-01-07 Added links to Element14 for parts in IMU schematic.
    [IMU.sch]
2014-02-07 Changed code to take advantage of Tritium giving us faster velocity telemetry. We now call process_pedal only when we receive a velocity packet and send the resulting drive command packet immediately.
2014-02-08 Changed tacho "torque display" mode from showing quadrature motor current (Iq) in amps x 100, to showing the product of direct and quadrature motor current (Id * Iq) in "square amps" x 1000. This is 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
2014-02-09 Added fifth tacho display in drive mode (instantaneous battery voltage). The order is now: rpm, power, torque, battery voltage, limiter.
2014-02-09 Changed tacho battery voltage display to an expanded scale, V-300 x 10, as per Mike's excellent suggestion.
    In gauge_tach_update(), made it clamp values below zero rather than taking absolute value. The callers apply fabsf() to the argument when required.
    The MX-5 tacho only has 3 divisions between 0 and 1 (r/min x 1000) while it has 4 divisions between the other integers. Normally it wouldn't move off zero until it got to 0.25 and the next two marks would represent 0.5 and 0.75. But because we use the tacho to display things other than rpm, I've offset and rescaled that section so these marks now represent 0.33 and 0.67.
2014-02-16 Changed worst-stress datalogging so it also records the worst case of each measurement separately - OV, UV, OT, UT, AL. All shown by the 'q' for query command.
2014-02-19 Apply a slew-rate-limit to torque zero-crossings in process_pedal() to try to avoid problems with backlash causing clutch slip.
    In DCU wiring.xlsx, remove the BLK-LGN from DCU-B (pin B2).
    [DCU wiring.xlsx]
2014-02-20 Added initialisation of variables for torque zero-crossing slew-rate limit. Extended slew rate limit from 80 to 160 ms. e.g. On a positive-going zero-crossing we spend 40 ms each at -10%, -1%, +1%, +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
2014-02-20 Fixed mistake in torque zero-crossing slew-rate limit.
2014-02-22 Display 12V battery voltage on tacho when key is on but we're not in drive mode or charge mode. With expanded scale V-10. Assumes DCU-A has been modified so BulbSense2 (Reversing light current sense 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
2014-02-26 Also put the 12V battery voltage display in the sequence of tacho displays in drive mode (between main battery voltage and limiter).
2014-02-27 In short-circuit conditionals, replaced _CS_SWAP _ENDIF with _END_PRIOR_IF.
2014-03-09 Fixed bug in printing worst stress in 'q' command. Had word move when it should have been byte.
2014-03-23 Added ramps to velocity setpoint
2014-03-25 Reinstated Tritium's original no-regen torque-only pedal mapping.
2014-03-27 Added a notch filter on command.current to try to reduce the 5 Hz drivetrain oscillation.
2014-03-28 Added notch filter constants for 3.8 Hz and 5.2 Hz. #ifdef out 100 ms sends of drive command CAN packets.
2014-03-28 Changed calling of process_pedal() so it is called at 100 Hz instead of only 25 Hz, so the notch filter works more smoothly. Added notch filter constants for 100 Hz operation.
2014-04-04 Fixed bug where auxiliary battery voltage display on tacho was being overwritten by charge current on MODE_OFF.
2014-04-07 Changed to monitor and testical to allow preliminary testing of IMUs, Insulation monitoring units.
    [IMU.pcb, IMU.sch]
2014-04-16 Added EVCU code to automatically charge the auxiliary battery (12 V), from the traction pack via the DC-DC converters, even when in OFF mode, if its voltage has fallen below a threshold. Untested.
2014-05-18 Initial check-in of the new universal cell-top-mounting cell management unit.
    [UniCellTopCMU.pcb, UniCellTopCMU.sch]
2014-05-27 Tested EVCU code to automatically charge the auxiliary battery (12 V), from the traction pack via the DC-DC converters, even when in OFF mode. Fixed bug where contactor on and off were swapped. Teste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
2014-05-28 Moved 100 Hz tick timing from Timer A to Timer B, to free up Timer A for a possible software UART. Updated DCU wiring spreadsheet and diagram. Added DCU mods for stronger pullups and pulldowns.
    [DCU wiring.xlsx]
2014-05-31 Added a software UART that uses Timer A (translated to C from the assembler version used in the Monitor program for the CMUs). Untested. This will be used to communicate with a voice synthesiser. Add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
2014-06-01 Arranged for automatic charging of the auxiliary (12 V) battery to occur not only in OFF mode but also in CHARGE mode after traction battery charging has terminated. Untested. Added a new CRASH mode 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
2014-06-01 Changed accelerator pedal constants to give 0 to 100% with negligible wasted travel at each end. Temporarily disbled OFF mode charging of auxiliary battery (12 V) by EVCU-B until its micro is replace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
2014-06-12 Increased REGEN_MAX from 0.5 to 0.7. Increased upper threshold for auxiliary battery charging, in OFF mode and CHARGE-terminated mode, from 14000 mV to 14180 mV. Implemented debounce/noise-spike-reje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
2014-06-13 Fixed bug in auxiliary battery charging code for CHGR_IDLE mode.
2014-07-12 Changed BMU 'f' command (FreezeIsStress) to 'c' (Charging) and made it ignore undervoltage, as well as take notice of undertemperature, when charging.
2014-07-12 Changed serialio and monitor initialisation code so that BMUs can change their baud rate from the default 9600, by changing a new BitTime variable in RAM. This is to allow future masterless control o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
2014-07-12 Added 'o' [ C(o)ntr(o)l Charger ] command to BMUs to allow masterless operation. It only makes sense to issue this command to the last BMU. e.g. '8s1o'. This causes it to run a PI controller on cell 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
2014-07-13 Fixed bug in 'c' (Charging) command where sense of boolean parameter was reversed. Fixed bug in 'o' (COntrOlCharger) command where it was sending at 4800 baud instead of 2400 baud. Tested OK using Te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
2014-07-25 Committed for checking
    [UniCellTopCMU.pcb]
2014-07-26 Added pads and strain relief holes for flying leads on positive ear. Mike, please check Top and Bottom Solder Mask layers to see if this looks like it will work.
    [UniCellTopCMU.pcb, UniCellTopCMU.sch]
2014-08-03 Moved LEDs to blue side of PCB and moved tracks and vias to try to restore some of the lost heatsinking to the bypass resistors.
    [UniCellTopCMU.pcb, UniCellTopCMU.sch]
2014-08-03 Increased the area of the northeast bypass resistor pad
    [UniCellTopCMU.pcb]
2014-08-09 Fixed bug where TestICal was not using RAM versions of the calibration values.
2014-08-12 Added voice synthesizer message on entering drive mode. (untested) Rearranged pedal notch filter code and added a comment on how to change it to a bandpass filter for when we try accelerometer feedba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
2014-08-22 Added code to request current readings from the IMUs (Insulation and current monitoring units) on the BMS fibre-optic loop (ID = 0) and display it on the tacho as Amps x 50, 0.5 second for half-pack 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
2014-08-22 Changed monitor so neither IMU (ID = 0) nor first CMU (ID = 1) complain about not receiving status bytes.
2014-08-23 Fixed the code that parses BMS responses to: (a) expect the latest response format, with command letter between ID and value, (b) allow for a possible minus sign on current (amps) responses from an I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
2014-08-24 Updated the DCU wring diagram and spreadsheet to show the new and revised pin assignments due to adding the 3rd UART (this one in software) for the voice synthesizer. Updated the DCU modification ins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
    [DCU wiring.xlsx]
2014-08-25 Changed update_switches() to take SW_INH_TRACTION and SW_NEUT_OR_CLCH from the GEAR 5 and 6 inputs instead of GEAR 3 and 4 which are now used as voice synth RX and TX.
2014-08-27 Replaced all occurrences of "BMU" with "BMS" or "CMU" as appropriate. Fixed the bug I introduced to bms_processPacket(). Moved checksum checking and write-index resetting from bms_processPacket() to 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
2014-08-27 Added a timeout on DCU-A not receiving BMS status via CAN-bus from DCU-B. This will generate a fake status byte with a comms errors and a stress of 8, just the same as a timeout on any DCU receiving 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
2014-08-28 When the WaveSculptor's DC current limit needs to be cut back to keep the worst cell's stress level below 8, we continue to allow a minimum current for getting out of danger. This is initially 12.5%,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
2014-08-28 Added code and updated wiring spreadsheet and diagram to use the LED_FAULT_2 output (DC37 pin 34) to drive a loud piezo beeper as a cell stress alarm when stress goes to 11 or more.
    [DCU wiring.xlsx]
2014-09-02 Fixed the 'f' (frequency) command so we get a proper square wave at TX- and TX+ that can be measured with any multimeter's Hz range. The solution was to turn TX+ into an input for the duration so the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
2014-09-05 Commented out unnecessary disabling of interrupts at start of monitor's main loop. Shaved a few cycles off the receive interrrupt service routine by calculating the half bit time at assembly time lik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
2014-09-06 Mike and I fixed a long-standing bug in the receive interrupt service routine. When testing the TIOV register to distinguish between timer overflow and receive capture/compare interrupts we used a cm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
2014-09-08 Enabled interrupts after monitor initialisation. Replaced timer-A interrupt sub-vector (TIOV) jump table with a single compare again, but this time after reading TIOV into a register to avoid the dou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
2014-09-09 Made the Monitor default to requiring and transmitting checksums on powerup or reset. Added and improved many comments.
2014-09-09 Some UniCellTopCMU PCB updates from weeks ago. A comment improvement in tri86.h.
    [UniCellTopCMU.pcb]
2014-09-10 Changed the Monitor 'o' command (masterless charger c(o)ntrol running in the last CMU) to take voltage-limit and current-limit parameters in tenths of a volt/amp. I note that a '1c' command must be i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
2014-09-10 Implemented 'I' (insulation test) command for IMUs that returns the prospective touch current through a 100 ohm human who touches a HazV battery terminal and the chassis. Added conditional assembly c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
2014-09-10 Reduced maximum time between charger packets for CMU masterless control of charging, from 5 seconds to 4 seconds, after reading at end of http://www.endless-sphere.com/forums/download/file.php?id=348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
2014-09-11 Clamped touch current replies ('I' command) to 9999 (99.99 mA) and sent 4 digits instead of 5, to simplify parsing by the EVCU. Sends 8888 on self-test failure. Added a watchdog reset to the start of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
2014-09-11 Added master/tritium EVCU code to send an insulation-test command (uppercase i) to its IMU whenever the IGN key is turned to ON, and to parse the response, and (for now) display it on the tacho in A: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
2014-09-13 Fixed problem with 'q' command watchdogging-out because of poorly coded new TX_StringCk routine. It was only 5 lines of assembly language. The only line I got right was the return instruction :-). Fo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
2014-09-13 Fixed problem where Insulation test command would cause a watchdog timeout if it came immediately after another command. The problem was the delay32ms routine. It was cutting things too fine relative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
2014-09-14 Made a start towards eliminating BSL1 and thereby freeing up info-flash for more calibration constants such as the battery capacity for the fuel gauge function of the IMUs. Wrapped BSL2 as a macro an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
2014-09-16 Updated wiring spreadsheet to include: LGN: Joined to RED-BLU under the dash, Powers IMUs in contactor boxes A2 and B2.
    [DCU wiring.xlsx]
2014-09-16 Fixed bugs in Insulation test command, but there remains a problem due to nonlinearity of the optocouplers. Larger prospective touch currents are exaggerated. e.g. while 3.6 mA reads correctly, 36 mA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
2014-09-18 Final tweak to opto nonlinearity-compensation for Insulation test, based on testing with leakage resistors in the E6 series from 1k5 to 680k. Added piezo alarm for prospective touch currents above 17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
2014-09-19 Added IMU fuel gauge commands 'g' (DoD in tenths of a percent) and '%' (reset DoD to 0%) in both Monitor and TestICal. Battery capacity is currently fixed at 40 Ah in the code. Will be stored in info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
2014-09-24 Added 200 ms delay between rising edge of key ON and sending insulation test request to BMS, to give time for battery contactors to pull in.
2014-09-24 Implemented EVCU code for reading state of charge from IMU and displaying the minimum of the SoC for the A and B half-packs on the fuel gauge. And resetting each to 100% on charge completion. Replace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
2014-09-25 Increased EVCU's charger tx buffer from 32 to 64 bytes to reduce overflows during rapid changes of cell stress. (Was beeping while charging). Reduced end of auxiliary battery charge from 14.18 V to 1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
2014-09-25 Rescale tacho display of traction battery voltage for the range of 600 to 740 V.
2014-10-01 Uses timeBeginPeriod() and timeEndPeriod() to make the timer resolution 3 ms instead of 15.6 ms. NOTE: now requires Visual Studio 2010 or later. I could not get this to link (would compile) with Visu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
2014-10-01 Version 1.3a: * Support for 8k (or 6K or any other sized) images with password 0x5 0x4 0x3 0x2 * Tidied up menu handling * Timer resolution is now 2 ms, but we ask for 3 ms for all delays other than 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
2014-10-06 Removed unwanted named groups Started editing Readme.txt to apply to the UniCellTopCMU.
    [UniCellTopCMU.pcb]
2014-10-06 Outline completed for the lower 4 CMUs in such a way that the rotation and panelisation procedures can be applied. IFO daughter board moved to southmost CMU. Rotatables group created. Readme.txt impr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
    [UniCellTopCMU.pcb]
2014-10-06 World's most complex PCB outline completed.
    [UniCellTopCMU.pcb]
2014-10-06 Rotated C6 and C8 to avoid a short when rotated Moved "Weber & Coulomb" text to suit Bumped Rev 59->60, Aug'14 -> Oct'14
    [UniCellTopCMU.pcb]
2014-10-06 Reverted last commit; moved C6 north only. This hopefully keeps C6 away from the vent. Have not bumped version number or date.
    [UniCellTopCMU.pcb]
2014-10-06 Special kink of track causes it to fit between the pads of R9 when rotated.
    [UniCellTopCMU.pcb]
2014-10-07 Achieved rotation that doesn't add any new DRC errors.
    [UniCellTopCMU.pcb, UniCellTopCMU.sch]
2014-10-07 Moved C6 (100 uF, 6.3 mm high) to the blue side, so it can't foul on any cell vents. Highest item on red side (underside when on top of cell) is now the fuse (2.6 mm high).
    [UniCellTopCMU.pcb]
2014-10-12 Ready for checking and posting to AEVA forum. Rotation works. Optional smaller piezo. C6 moved a little away from bypass resistors.
    [IMU.sch, UniCellTopCMU.pcb, UniCellTopCMU.sch]
2014-10-13 Zero DRC errors in both rotations, with and without copper pours. Isolated islands minimised (and removed).
    [UniCellTopCMU.pcb, UniCellTopCMU.sch]
2014-10-13 Minor improvements.
    [UniCellTopCMU.pcb]
2014-10-14 Strain relief holes for TX and RX wires. Backed off copper around bolt holes. Bumped rev number to 61.
    [UniCellTopCMU.pcb]
2014-10-30 Changed fuse from 1 A to 1.25 A. Changed some parts links to Digikey and Element14.
    [UniCellTopCMU.sch]
2014-11-17 Fixed component designators which were incrementing between CMUs. Made positive cell terminal solder pad look a little like a plus sign. Changed LED outlines to reflect top-of-LED markings. Many smal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
    [UniCellTopCMU.pcb, UniCellTopCMU.sch]
2014-11-19 Added ErrLedOn/Off and ActLedOn/Off macros with conditional assembly for the rev 61 PCB.
2014-11-25 Commented out peeQ command so TestICal will assemble with new LED macros.
2014-11-25 Changed comments and command summary because TestICal 'f' command now uses a 10 cycle loop (not toggling LED) so desired measurements are now around 200 kHz. Zeroed the bus current offset for new Wav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
2014-12-08 Added "Strap-" comment next to "GND" in CMU schematic.
    [UniCellTopCMU.sch]
2014-12-08 Added code to allow EVCU-A to obtain both half-pack voltages from the two IMUs. Not used yet.
2014-12-08 Added #if (PROG_START < $F000) around some command definitions, so Monitor and TestICal would still assemble 4 KiB versions, to allow upgrading more 4 KiB CMUs/IMUs to 8 KiB.
2014-12-09 Added Monitor uppercase 'P' command with 3 parameters, to set the stress-7 PI-loop setpoint and step size, for the various stressors. Currently only works for overvoltaqe. 3490 20'VP is normal. 3322 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
2014-12-14 Added new folder monolith with new project, based on monitor project Moved serialio.s43 to common folder Added crc.s43 with CRC-16-CCITT code. Assembles but is otherwise untested and not called yet
2014-12-22 Default to no echo and don't send stress bytes on Monolith IMU. Handle negative HazV voltages on Monolith IMU which is modified to have the bottom of its voltage divider connected to Vref+ instead of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
2014-12-27 Re-spelled names in serialio.s43 and crc.s43 to newly agreed naming convention (variables lowerCamelCase, subroutines and runtime constants UpperCamelCase, no underscores except in non-runtime consta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
2014-12-27 SendChargerPackets() is complete. It now calls SendPipPacket() twice, in the right order for float and bulk. Modified SendStatus(), PiController() and the 'o' command, to work with the PIP-4048MS inv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
2014-12-28 In 'o' command changed ChargerControl to bChargerControl. In DoStatus, call SendStatus if IMU In DoStatus, comment out _IF matching already commented _ELSE and _ENDIF
2014-12-28 Fixed a byte/word issue with chargerTxTimer UpdateCrc now preserves R10 _NV -> _NEVER in ControlFlowMacros.h For testing, insert an 'o' and 'c' command Watchdog timer resets in SendPipPacket()
2014-12-28 Stable PI control of PIP-4048MS inverter/charger achieved! Thanks Mike. :-) In serialio.s43 reduced StatusFreq from 16 Hz to 2 Hz as a way of reducing the integral gain. In monolith.s43 set PiControl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
2014-12-30 Renamed short-circuit conditional macros with shorter, more logical and fewer different names. Only 6 required instead of 10. Replaced remaining overlapping-structure short-circuit conditionals with 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
2015-01-01 Fixed problem where ErrLedOn and ErrLedOff macros in comMacros.h were interfering with the 1Y (relay) command in an IMU compiled with the REV61 switch.
2015-01-01 Fixed the remaining problem with the 1Y (relay) command, by moving its code outside of the #if INSULATION_MONITORING conditional assembly. Changed tests of ID (e.g. for checking if we're an IMU) use 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
2015-01-03 Added macro "ClearWatchdog", in comMacros.h. Replaced the raw code and conditional assembly with that macro, everywhere. Deleted the unused routine RxByteNoWait from serialio.s43. Renamed RxRawByteNo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
2015-01-04 In monolith.s43 for IMUs, make relays initialise to ON, so as not to lose power immediately. Implement source or load relay dropout on stress 12 or more, and turn them back on again if the stress dro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
2015-01-05 In the cellV routine in measure.s43: Replaced "ID" with "&ID". Tested IMU negative voltage measurement code and calibration method. Improved comments re calibration method.
2015-01-11 Initialise only the load relay on. Turn on source relay only id PV array voltage is less than 140 V.
2015-01-11 Push and pop R8 around call to cellV for checking PV array voltage. Add PIP initialisation (untested). Moved Delay130ms to common.h. Added TxString to serialio.s43.
2015-01-11 Moved Delay130ms to after end of main loop Fixes 64 kB assembled binary problem
2015-01-12 At last! No more NAKs (or NCKs) in response to commands sent to the PIP inverter/charger. Although the occasional ACK arrives missing a checksum byte. Ensured only IMU sends PIP init commands (Mike).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
2015-01-12 Four more PIP initialisation strings added. Changed PIP priority to "SBU" (solar, battery, utility).
2015-01-14 Arranged for IMU to send current (in tenths of an amp) to CMUs, as an 'i' command, which they multiply by a fixed internal resistance (presently 1.0 mR) and subtract from their measured voltage, to c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
2015-01-16 Corrected the sign of the compensation for current times internal resistance. Arranged to send a 2400 baud carriage return before, and a left paren after, each set of 2400 baud commands send to the P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
2015-01-17 Eliminated sending of 'c' commands and based CMU charge/discharge on 'i' commands (no hysteresis). Used postfix minus signs for negative currents in 'i' commands, as prefix minus signs were ignored. 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
2015-01-17 Temporarily raised chargerVoltMin and chargerVoltMax to 54.6 V and 56.6 V to allow it to achieve the temporary 100% charge. Added some 'ClearWatchdog's to prevent IMU watchdogging out.
2015-01-18 Changed OV step from 3 mV to 20 mV. Created constants for charger volt min and max. Some temporary hacks for debugging.
2015-01-18 Got all PIP initialisations working. Thanks Mike! Temporarily sending only Bulk voltage commands under PI control, at 2 second intervals.
2015-01-19 Added extra 2 second delay, in case sending monolith, which could spend 2 seconds away from the main loop Bumped to revision 1.3d.
2015-01-19 Preceded 'i' commands with CR. Moved POP02 (SBU priority) command to start of PIP initialisation. Changed to POP00 (UtI priority) temporarily for testing. Added PIP junk-sweeping command 'PExSh(' whi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
2015-01-21 Break the infinite loop caused by receiving a break (only likely in monolith, since it "closes the comms loop"). NOTE: can cause problems when boostrap loading software! New CMU voltage thresholds (f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
2015-01-22 In Monolith, a fundamental logical flaw in the previous stress calculation scheme on the part of the CMUs, led to an inability for the IMU to know when it was OK to turn contactors back on. To solve 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
2015-01-22 Arranged for IMU to treat it like stress 15 and shut down the system if no status bytes are received for about 10 seconds. Untested.
2015-01-22 Fixed bug where IMU status-receiving timer was not being cleared.
2015-01-24 Implemented fix for problem discovered by Mike where, because an under-temperature stress >=12 can persist indefinitely despite dropping out the charge-source contactors, it could have masked an unde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
2015-01-24 Final changes prior to first installation of monolith device for customer. Reduced coulomb-counter fuel gauge 'g' command response values by a factor of two. Adjusted bypass voltage to be 5 mV higher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
2015-01-25 Added copious comments around the call to UMStar for OC voltage estimation (monolith only). It's tricky code, and deserves more commenting. I did not find an error with it, however.
2015-01-25 Mike: when re-closing contactors, i.e. stress is <= 7, don't consider stress type or charge current direction. Fixes a problem where the charge source contactor would not come on after a start-up. Ad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
2015-01-25 Mike: Moved SOC calculation code to new function StateOfCharge Temporarily re-enabled 'a' command (set fuel gauge) Added interrupt processing and initialisation to use TACCR2 as a crude PWM, outputti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
2015-01-25 Mike: many calls were missing the # char Define PWMOUT; set as output Don't set TouchV as analogue input Enable temporary 75% PWM initialisation PWM code not working, but at least it doesn't seem to 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
2015-01-25 Moved initialisation of PWMOUT (P1.3) as output, to REV61 conditional assembly. Removed 75% PWM duty cycle test. Changed renamed StateOfCharge to DepthOfDischarge and changed comments accordingly. In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
2015-02-15 Changed BSL to not echo a break if ID is 255. So monolith IMU must be changed to 255. Many changes of Monolith IMU ID tests, from ID = 0 to ID = 255. Put the new monolith SoC-meter PWM interrupt code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
2015-02-15 Mike: added DINT instruction at start of 'b' command. Would be bad if an interrupt occurred when the vectors are erased.
2015-02-15 Mike: revert last change, interrupts are never turned on for TestICal, and indeed turning them back on could be dangerous.
2015-02-18 Changed _IF _LO to _IF _EQ in 'g' fuelGauge command so it would recognise IMU IDs.
2015-03-01 Added notes for placing and soldering components
2015-04-06 Fixed EVCU bug where battery contactors would chatter after charge termination.
2015-04-17 Changed monolith.s43 to set PIP float voltage to 53.8 V (instead of 54.0 V) (3.3625 Vpc) and to bypass at 3.368 V (instead of 3.380 V). Bulk/absorb is still 55.2 V (3.45 Vpc).
2015-04-18 Changed PIP inverter intialisation so it only puts 30 A into the battery from the generator since the customer's generator browned-out at 180 Vac when it was set to put in 40 A and there were some ho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
2015-04-29 In CMU schematic and pcb, changed bypass mosfet to AO4322 or RQK0606 and updated to Design Spark 7.0 format.
    [UniCellTopCMU.pcb, UniCellTopCMU.sch]
2015-05-02 Made monolith IMU save the high word of its coulomb counter to CMU 1 approximately every 2 minutes, and restore it from there after a reset. Also added a TxEndOfPacket routine (Tx checksum and carria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
    [UniCellTopCMU.pcb]
2015-05-03 Fixed monolith so only the IMU sends a '1sG' during initialisation. Changed tail-calls of TxEndOfPacket to branches. Thanks Mike.
2015-05-11 Changed monolith so it estimates the internal resistance based on temperature, using an approximation to Arrhenius' equation. So the temperature-dependent component doubles for every 10 K drop in tem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
2015-05-12 Made the monolith IMU send commands to the CMUs when reset, to ensure they are sending and expecting checksums, and sending status bytes. This is so the customer could restore correct operation by sh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
2015-05-12 Made monolith IMU send a carriage return to flush any junk, before sending initialisation commands to the CMUs.
2015-06-25 First commit of schematic for BMU (Battery Management Unit), i.e. a BMS master unit. It is an expansion of the IMU (insulation and current monitoring unit). It is designed to work with solar and grid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
    [BMU.sch]
2015-06-29 Changed the comms ports to provide only isolated RS232 DTE on a D9 male.
    [BMU.sch, IMU.sch, UniCellTopCMU.pcb]
2015-06-30 Added 3 MOSFETs to drive the 3 IFO LEDs and renamed the Scu and Chg TX outputs to indicate an inversion in software. Added a "to do" list.
    [BMU.sch]
2015-07-01 Added surface mount piezo found by Mike.
    [BMU.sch, IMU.sch, UniCellTopCMU.sch]
2015-07-01 Added footprint for PIEZO_SMD
2015-07-02 Separated Chassis/PE from 12V return.
    [BMU.sch]
2015-07-02 Schematic complete. Ratsnest PCB auto placed.
    [BMU.sch]
2015-07-03 Rearranged touch test section of schematic for clarity. Renamed GND to HazCom. Renamed 0V to 12V-.
    [BMU.sch]
2015-07-04 Preliminary parts placement on PCB.
    [BMU.sch]
2015-07-04 Some nets routed.
    [BMU.sch]
2015-07-05 Added BMU PCB that I thought was already added. Duh.
    [BMU.pcb]
2015-07-05 Added inverse diodes on RS232 RX optos. Put resistors on both CMU TX outputs.
    [BMU.pcb, BMU.sch]
2015-07-05 Added some very low hanging fruit tracks: shunt amplifier, voltage divider ladders
    [BMU.pcb]
2015-07-05 Gull wing leads on processor and optos Many other changes that don't seem to work
2015-07-06 BMU changes: Reduced PCB size to fit CAMDENBOSS BIM2030/IP-BLK enclosure. Added 6 mounting holes. Only 3 usable (forming biggest possible triangle). Added a 5th MOSFET output. Moved reed relay drive 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
    [BMU.pcb, BMU.sch]
2015-07-06 BMU PCB: Made all 6 mounting screws usable.
    [BMU.pcb, BMU.sch]
2015-07-09 BMU PCB: Final board outline. Connectors fixed in place. Contactor-drive MOSFET section fully routed with allowance for 4.5 mm diameter light pipes on LEDs.
    [BMU.pcb, BMU.sch]
2015-07-13 Added 470u electro and 1u0 ceramic across the 12V bus that feeds the MOSFETs. Routed the RS232 and optic fibre comms sections for the system controller and inverter/charger comms.
    [BMU.pcb, BMU.sch, IMU.sch, UniCellTopCMU.pcb, UniCellTopCMU.sch]
2015-07-14 BMU: Added isolation to CMU TX output.
    [BMU.pcb, BMU.sch]
2015-07-14 Added 10 mm SMD capacitor
2015-07-14 BMU: More stuff routed
    [BMU.pcb, BMU.sch]
2015-07-26 The first version of the BMU PCB sent to be fabricated, by OSH Park.
    [BMU.pcb, BMU.sch, IMU.pcb, UniCellTopCMU.pcb]
2015-07-31 Last commit before moving to GitHub. BMU PCB: Corrected C22 footprint from 1210 to 0805. Added many parts URLs for Digikey and E14.
    [BMU.pcb, BMU.sch, IMU.pcb, IMU.sch, UniCellTopCMU.pcb, UniCellTopCMU.sch]
2015-08-01 BMU: Decided all component values and added Digikey and/or Element14 URLs for all but stock 5% R's abd C's, while ordering all parts for prototypes.
    [BMU.sch, UniCellTopCMU.sch]
2015-08-04 Tented all vias (Design tech, Layer types tab, Solder Mask row, Edit, unchecked "vias" inside Include group box.
    [BMU.pcb]
2015-08-20 Added protocol manual. BMU PCB: Improved connector and mounting-screw clearances. Firmware: Added new pinouts for BMU, with G2553 conditional assembly. TestICal G2553 code completed but untested. Add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
    [BMU.pcb, BMU.sch]
2015-08-22 TestICal now working in BMU, although not all new features are complete. Moved calibration data from $10F8 to $1010. Changed some LED resistor values in the BMU schematic to get equal brightness.
    [BMU.sch]
2015-09-05 Added UART comms for CMUs. Added timer comms for SCU and charger/inverter. Added timer Piezo drive (by Mike).
2015-09-05 Rearranged Tx UART ISR. Initialised UART pins to UART function.
2015-09-05 Initialised Port 2 and 3 directions etc. Removed initialisation of UART TX interrupts. Fixed initialisation of stack pointer.
2015-09-12 Changed the case of many port masks to be standard. Corrected stack space calculation. Changed TxMi from P1.3 to P3.7 because pin can't be UART out and CA in at same time. Fixed some port initialisat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
    [BMU.pcb, BMU.sch]
2015-09-12 No P3SEL2 bit to select comparator output (different to port 1!) Had piz and soc arguments for CCRp macro arguments swapped Changed Q command to disable compare interrupts and set output to zero, if 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
2015-09-12 Timer interrupt for piezo in TestICal untested.
2015-09-12 In TestICal, enabled interrupts generally. Disabled timer overflow interrupts.
2015-09-12 Disable interrupts in BSL2 for timed I/O Simplified piezo interrupt routine
2015-09-12 Brought Monolith up to date with Monitor. Brought DoPassword up to date. Untested.
    [BMU.pcb, BMU.sch]
2015-09-19 Added ALL_TO_ALL conditional assembly for testing multiple BMU serial ports. Added HELIDON conditional assembly for negative BMU voltage reading. Deeleted TxByteNoWaitAlternateVersion. Facilitating M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
    [BMU.pcb, BMU.sch]
2015-09-25 Changed Tritium DCU to use a minimum charge current when cells are too low to communicate. Changed monolith to use correct contactor outputs for source and loads when running in new BMU.
    [BMU.sch]
2015-09-26 Set minimum charge current down from 0.7 A to 0.2 A.
2015-09-26 Quick 'n dirty Modbus/ASCII interface added, but with no checksumming yet. BMU PCB DE9 pinouts corrected. Hole size for plug-in terminal headers reduced.
    [BMU.pcb, BMU.sch]
2015-09-27 Made modbus colon command interpret a device ID of zero as a broadcast, i.e. not compile an 's' (select) command. Made 'p' command respond with the full 7 bits of status, not just the 4 bits of stres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
2015-09-28 Added (uppercase) 'V' command to return array voltage (BMU) and bolt+ voltage (CMUs). Temporarily added 'H' command for CMU reading temperature from external thermistor (repurposing Bolt+ input). Mov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
2015-09-28 Fixed some things that stopped the code assembling for the existing CMUs with the older MSP430G2452 processor.
2015-09-30 In modbus protocol manual: Changed SoC to Uint16. Added section about end of charge.
2015-10-05 Simple Modbus/ASCII implementation BMU has ID 247 in Modbus commands Modbus address 246 is broadcast (0 is invalid Modbus address) LRC (Longtitudinal Redundancy Check) implemented Moved TxEndOfModbus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
2015-10-05 Modbus protocol: Added charge termination condition "and the stress-level field contains 7". Added note about modbus register addresses versus numbers. Formatting and minor wording changes.
2015-10-05 Control Flow Macros: Improved comments on how to use them, as suggested by Mike.
2015-10-11 Fixed problem where could not Make monolith. It was due to having #define VoltCal infoVoltCal etc. followed later by VoltCal EQU infoVoltCal etc. Kept only the EQUs. Eliminated similar duplication in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
2015-10-11 Added calibration for the external thermistor used on the CMUs in the prototype white monolith.
2015-10-12 Fixed logic of bEchoResponses to include Wunth and Modbus responses but not Modbus commands Moved specialisation of ACCEPT (2 functions) to WmBmuACCEPT and AccMaster in master.s43 serialio.s43 rename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
2015-10-12 TxBytes label was in wrong position Moved initialisation of TxByte inside #if G2553 so will assemble for G2452 IMU -> BMU in many comments If ScuRxByteNW returns Z, use an else clause to guarantee th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
2015-10-13 Fixed bad conditional assembly when MONOLITH and not HELIDON that was causing wrong v command results by falling through to boltV instead of completing cellV.
2015-10-13 WmBmuACCEPT is moved back to ACCEPT now; removed code for TxByte port steering Changes to allow wmonolith to assemble with G2553=0 AccMaster inside #if G2553 now AccMaster steers output to CMU port n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
2015-10-13 In AccMaster. added logic to detect when injecting a command when a command that was in progress timed out. In this case, a carriage return is sent, and the transmit checksum is cleared. Added bEchoR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
2015-10-14 BSL now toggles the error LED on each echoed character when watchdogged-out and not programming. wmonolith now does not send "I'm lonely" response packets e.g. "\002: c" so as not to upset a modbus S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
2015-10-14 Fixed clearing of interrupt enables in DoPassword (in all projects). Made all projects except wmonolith default to building for the older G2452 processor.
2015-10-16 Fixed doBurst for the 'f' command so it's a 10 cycle loop for both G2553 and G2452 devices.
2015-10-22 BMU Schematic: Added two 12 V inputs for auxiliary contacts on Precharge and Battery contactors (or ignition switch or other switch to +12 V). BMU PCB: Moved many things to make room for the above in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
    [BMU.pcb, BMU.sch]
2015-10-24 Many comment changes to wmonolith e.g. IMU->BMU.
2015-10-24 Changed 'p' command to do full status instead of just stress, and to goive globalStatus when a BMU is asked. Added 'j' command to give just stress (like 'p' used to. Removed code that handled separat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
2015-10-24 Changed R11 to R12 in DoPrecharge. Documented trashing of R11 by measure routines. Drove two contactor outputs in parallel for battery contactor.
2015-10-25 Made wmonolith's 'p' command output in hex and clear the high bit. Further progress on adding 12 V inputs t BMU PCB.
    [BMU.pcb, BMU.sch]
2015-10-26 Changes to assemble wmonolith when G2553 is off
2015-10-27 wmonolith: Make thermistors do stress. Fixed '>' and '<' commands.
2015-11-07 Completed the addition of two 12V inputs and green LEDs to limit IFO PT saturation. No significant design rule errors.
    [BMU.pcb, BMU.sch]
2015-11-07 Changed MOSFET protection diodes to Transorbs.
    [BMU.pcb, BMU.sch]
2015-11-07 Added E14 and Digikey links for transorbs.
    [BMU.pcb, BMU.sch]
2015-11-26 In wmonolith, changed battery capacity to 400 Ah and internal resistance to 360 uR for Kingscliff job. Improved comments re negative current means discharge. Staggered turn-on of four battery contact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
    [BMU.sch]
2015-12-05 Changed thresholds for auxiliary battery recharge in OFF mode, to suit newly installed LiFePO4 auxiliary battery.
2015-12-18 In monolith, changed PIP initialisation for low voltage cut-off from 48.0 V to 50.8 V, to make use of Mike's patched PIP firmware. Set the "HELIDON" compile flag.
2015-12-22 monolith: As installed in Black Monolith #1 at Helidon on 19/12/2015 when we installed Mike's brilliant patched PIP firmware version "LiFEPO4". Reduced IMU initialisation of PIP float voltage from 53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
2015-12-27 BMU: Added inverter to generate TxMi from TxPl, to free up crystal oscillator pins. Added 32768 Hz watch crystal for precise comms timing, to allow for possible IRDA comms in CMUs.
    [BMU.pcb, BMU.sch]
2015-12-29 First pass at new schematic 'CMU.sch' for CMU with 20 pin MSP430G2553, printed bypass resistor, watch crystal, discrete IrDA receiver and emitter. BMU.sch and BMU.pcb updated to DesignSpark 7.1.
    [BMU.pcb, BMU.sch, CMU.sch]
2015-12-29 CMU.sch: Added Yellow-green LED as "zener" to prevent saturation of IFO and optocoupler phototransistors now that R14, the collector pullup, has been increased from 470 R to 2k2, for the IrDA phototr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
    [BMU.pcb, BMU.sch, CMU.sch]
2016-01-01 CMU schematic: Changed Rx and Tx headers from 2-pin to 3-pin reversible. Changed from a 3-pin phototransistor to a photodiode feeding the base of a BC847C transistor. Changed IR device footprints fro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
    [CMU.sch]
2016-01-05 CMU schematic and PCB: Changed from IrDA to IrRC, using an integrated IR receiver, and using a NAND gate and IR LED as the transmitter. 57.6 kHz sub-carrier generated by MSP430 clocked at 3.6864 MHz.
    [BMU.sch, CMU.sch, UniCellTopCMU.pcb, UniCellTopCMU.sch]
2016-01-06 CMU schematic: Added RC filter to IrRC receiver supply and added current limiting resistor to IR LED. CMU PCB: laid out 1.3 metres of 0.2 mm track as 3R3 bypass resistor.
    [CMU.sch]
2016-01-06 Added file "CMU.pcb" to SVN version control.
    [CMU.pcb]
2016-01-09 CMU PCB: Placed all components including IR components. Routed south non-rotatey section.
    [CMU.pcb, CMU.sch]
2016-01-10 CMU PCB fully routed. No DRC errors. But much improvement yet to do.
    [CMU.pcb, CMU.sch]
2016-01-11 CMU PCB: Moved regulator to west of processor. Centred the piezo. Made progress towards rotatability.
    [CMU.pcb, CMU.sch]
2016-01-12 Done 90% of the work of removing the top 4 CMUs, making this board 4 CMUs instead of 8.
    [CMU.pcb]
2016-01-12 CMU PCB: Made creepage for rotation. Expanded printed resistor.
    [CMU.pcb]
2016-01-12 Changed rotation instructions to include selecting SG1; this allows us to skip a step and see the results of the rotation immediately. Fixed a Vdd track that extended from outside to slightly inside 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
    [CMU.pcb]
2016-01-12 Moved the locating hole to the north west corner, and removed it from the Rotatables group.
    [CMU.pcb]
2016-01-12 Slightly moved an RX via that was failing rotation
    [CMU.pcb]
2016-01-12 Attempted metrification of outlines. Removed one resistor snapoff board. WARNING: outlines are messed up; holes aren't even the right sizes. Will need to go back and find out when this happened, and 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
    [CMU.pcb]
2016-01-13 Fixed the dimensions in bottom documentation layer. However, OVAL HOLES are not yet corrected. They're somewhat all over the place. Have been since at least revision 924.
    [CMU.pcb]
2016-01-13 Flipped outline horizontally. Eliminated some bottom silkscreen text, and moved others to the top. Fixed error due to mirrored IFOs. Made IFO daughter board work with no bottom silkscreen.
    [CMU.pcb, CMU.sch]
2016-01-13 New dimensions and oval hole positions, to accommodate 79.5 to 81.5 and 102.5 to 106.5 mm terminal spacings.
    [CMU.pcb]
2016-01-13 Removed the last resistor daughter boards from the outline.
    [CMU.pcb]
2016-01-14 Top quarter (1 CMU) is about completely metrified (might have missed one or two minor spots). Removed a resistor daughter board from top doc layer. Metrified and flipped top IFO daughter board on top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
    [CMU.pcb]
2016-01-14 More metrication of outline.
    [CMU.pcb]
2016-01-15 No idea
    [CMU.pcb]
2016-01-15 Metrified, unflipped squiggle joins. Changed minimum rout bit size to 1.4 mm, reduced squiggle join thickness from 2.54 to 2.2 mm. Only squiggles between CMUs 2 and 3 from bottom are completed.
    [CMU.pcb]
2016-01-16 Squiggle joins all metrified. Some outline updates.
    [CMU.pcb]
2016-01-16 Outline metrication complete.
    [CMU.pcb]
2016-01-16 Completed swapping of copper pours on terminal wings. Some cleanup of silkscreen away from soldermask openings.
    [CMU.pcb, CMU.sch]
2016-01-17 Fixed some creepage errors when rotated. Repaired the rotatables group; several rotation errors that had crept in. Moved all text to the board, reduced sizes of some. Not ideal, but it fits.
    [CMU.pcb]
2016-01-17 Updated rotatables grouping procedure and replication procedure to something that works with the new arrangement: Rotate CMU2 before copying to CMU1 and rotate back after. Deleted copies of squiggle 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
    [CMU.pcb]
2016-01-17 Now Rev 63. Updated a dozen or so components to display name value, not actual designator (so copied parts show as same designator). Fixed a part of the outline that was straight, should be round.
    [CMU.pcb]
2016-01-17 Replaced NON_PLATED CUTOUT text in ovals and squiggle join cutouts; removed from Rotatables group. Changed PCB/Readme.txt to deselect the Cutouts Text layer when replicating.
    [CMU.pcb]
2016-01-18 Duplicated pads for supercapacitor C8, so it can optionally be inserted horizontally. This may be needed so the IR transmitter can clear it, or just to keep the overall height to 6.6 mm. NOTE: this h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
    [CMU.pcb]
2016-01-18 Metricated terminal hole diameters (from 8.6xx mm to 8.6 mm). Performed breast reduction surgery on GND pour.
    [CMU.pcb]
2016-01-19 Moved R7 to near XT1. Added red GND pour in middle. Lengthened printed resistor.
    [CMU.pcb, CMU.sch]
2016-01-20 Fixed the blue GND ground plane under the - terminals
    [CMU.pcb]
2016-01-20 Initial check-in of OctCMU.sch and OctCMU.pcb. Octagonal CMU for cylindrical cells. Hermaphrodite version that can make negative-centric and positive-centric isomers by deletion. Initial version is o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
    [OctCMU.pcb, OctCMU.sch]
2016-01-22 Removed unused via on GND net near opto. Neatens up and slightly lengthens the printed resistor. Checked with rotation; no design rule errors.
    [CMU.pcb]
2016-01-23 Added gnd plane to OctCMU.pcb. Changed lots of holes to metric on CMU.
    [CMU.pcb, OctCMU.pcb]
2016-01-23 Reduced outline for IR components More metric hole sizes
    [CMU.pcb]
2016-01-23 Thickened and metrified outlines.
    [OctCMU.pcb]
2016-01-23 Changed more outlines to 0.15 mm
    [CMU.pcb, CMU.sch]
2016-01-23 OctCMU: Fixing more silkscreen pad overlaps.
    [OctCMU.pcb, OctCMU.sch]
2016-01-24 Modified CMU.pcb outline so that a router of size 1.5 mm (60 thou) can make the squiggle join cutouts. NOTE: no components have been moved yet to compensate for the 0.2 mm less high board area.
    [CMU.pcb]
2016-01-24 Moved IFO mechanical pads in ward. More getting silkscreen off pads.
    [CMU.pcb, OctCMU.pcb]
2016-01-24 OctCMU: Added fuse in GND connection for flying lead. Changed more component outlines to 0.15 mm stroke width. I think the hermaphrodite OctCMU is ready for isomer generation, to send off for prototy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
    [OctCMU.pcb, OctCMU.sch]
2016-01-25 Fixed many radii on the outline that weren't r0.75 yet; various other outline fixes
    [CMU.pcb]
2016-01-25 Added two track segments missing from the rotatables group. Deleted junk groups.
    [CMU.pcb]
2016-01-25 Replaced small segment of track missing from squiggle joins.
    [CMU.pcb]
2016-01-25 Fixed a design rule error that crept in with a recent squiggle join track fix. Moved daughter boards north 0.1 mm so 1.5 mm router tool will fit in the channel.
    [CMU.pcb]
2016-01-25 Re-did the adding of the two sets of red tracks missing from the rotatables group. Also re-removed the junk groups associated with the snap-off holes.
    [CMU.pcb]
2016-01-25 Metricated C8's pad holes. Deleted unused nets and styles. Added procedure to Readme.txt, for generating Octagonal isomers.
    [BMU.pcb, CMU.pcb, OctCMU.pcb]
2016-01-27 This has the versions of CMU 62, OctCMU 62 (neg and pos) and BMU 4 that were sent to OSH Park for fabrication. Added the isomerisation procedure for the octagonal CMUs to Readme.txt. Moved mounting h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
    [CMU.pcb, CellTopBMU.pcb, CellTopBMU.sch]
2016-02-02 Added parts links to CMU.sch and OctCMU.sch. Minor updates to PCB populating notes and testing procedure. Minor correction to comment in wmonolith.s43.
    [CMU.sch, OctCMU.sch]
2016-02-05 CMU.pcb: Added pads to allow for 13 mm thru-hole piezo again.
    [CMU.pcb]
2016-02-15 More detail given in the manual, on the use of device addresses for individual cells, and the broadcast address.
2016-02-17 Since Geli decided they now want a BMU modbus ID of 100 instead of 240, I changed BmuModbusID back to 247 but added the comment: "Normally the highest valid ID of 247, but Geli use 100". Changed Broa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
2016-02-18 Clear bModbusOutput flag after interpreting all command packets (might not call prettyPrint) Use modbus ID of 100 for now (for Geli) Put all external temperature sensing code inside #if EXTTEMP Repla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
2016-02-22 Wmonolith: Changed the order of operation of the contactors during precharge, so it works for either the original DCM (all contactors in the positive) or the Pods and future DCMs (some contactors in 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
2016-02-24 BMU schematic: Updated comment re alternative uses of processor port bits between BMU rev 4 and CMU rev 62. All four software products: Rationalised conditional-assembly #defines in preparation for a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
    [BMU.sch]
2016-03-05 FFL command bug fixes f command: disable interrupts, handle UART -> GPIO No comms working yet
2016-03-11 Updated PCB test procedure.
2016-03-12 BSL2 at $FC00 for REV >= 62 Init SP in BSL before eint Generate 57.6 kHz output in BSL2.s43 Disable and restore interrupts for 'b' command Restore comparator function after 'f' command
2016-03-21 Free-space IR comms works! TestICal now works with the rev 62 prototype CMUs, when they are wire-patched as shown in OctCMU.sch (Rev 62.1). These PCB patches connect the GND pin of the IR receiver to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
    [OctCMU.pcb, OctCMU.sch]
2016-03-22 Improved commenting of the rev 62 FLL interrupt routine in the BSL. Removed erroneous update comment from the end of the Modbus protocol manual. Changed UV stress levels in wmonolith so level 8 is ar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
2016-03-23 Added C# version of CMUSend, called LFSend. Only the open button works so far. Needing this because Visual Studio 2013 Express, which replaced VS 2010 Express, no longer supports MFC (Microsoft Found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
2016-04-01 Corrected the log reading procedure in the wmonolith folder. Moved certain commonly-changed constants to the start of wmonolith.s43. Added an infinite loop after the BMU drops out the battery contact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
2016-04-04 Fixed broken GND net to IR receiver
    [CMU.pcb, CMU.sch]
2016-04-05 Restored #endif that I mistakenly removed. Changed shutdown timeout from 60 s to 15 s. Changed batterey capacity from 400 to 160 Ah and int res from 360 to 900 uR (to suit pods instead of DCM).
2016-04-07 Changed Rev62 code to assume that TxMi is generated externally by an inverter. Changed ACLK to be watch-crystal div by 8 (4096 Hz). Changed FLL to accommodate this change to ACLK and removed piezo to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
2016-04-11 Rotated pins for Piezo, TouchV and PreI
    [BMU.sch, CMU.sch]
2016-04-11 Removed master/Tritium folder, and some obsolete PCB files
    [Contactors Truth Table.xlsx, DCU wiring.xlsx, IMU.pcb, IMU.sch, UniCellTopCMU.pcb, UniCellTopCMU.sch]
2016-04-25 Set Piezo P1.0 as output. Made TestICal test if a 20 pin chip by pulling P3 pins up and down, and set ID to 0 if so.
2016-04-28 Changed BMU op-amp from OPA335 (obsolete) to OPA333.
    [BMU.sch]
2016-04-30 Removed a redundant and incorrect setting of P1DIR in BSL2.s43 Moved 57k6 signal to P2.1 in CMU.sch, was P2.3 Piezo no longer part of P2 in TestICal.s43
    [CMU.sch]
2016-04-30 C10 -> 10nF (was 100 nF). Updated Digi-Key and e14 links
    [BMU.sch]
2016-04-30 R35 -> R62 (nothing to do with R35a and R35b, too confusing)
    [BMU.sch]
2016-04-30 R59 -> R63 (too confusing given R59a and R59b). R53 -> R66 (too confusing given R53a and R53b). Moved "_57.6kHz" from P2.3 to P2.1. Changed it to "57k6".
    [BMU.sch]
2016-04-30 Changed definitions in common.h to agree with new schematic Cont -> Ctor in many names (source code and BMU schematic), to avoid confusion with "contact"
    [BMU.sch]
2016-04-30 Removed erroneous #if G2553 Cont -> Ctor in many names Removed commented out #defines for REV and G2553 33n -> 3n3 for C7 Don't leave P3REN non-zero; outputs don't work
    [BMU.sch]
2016-04-30 Eliminated interrupt routine for old piezo drive. Updated Q (quiet) command for new (ACLK) piezo drive.
2016-04-30 Moved "xxxCtor" labels so they could be read.
    [BMU.pcb, BMU.sch]
2016-05-02 Removed many #if (PROG_START < ...) Started fixing the clocks for monitor, not completed Swapped CCR0 and CCR1 for system and charger software UARTs Removed piezo interrupt code Removed #define for K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
2016-05-02 Applied the changes of Rev 1130 to rev61 and trunk: Corrected the calibration formulae for temperature and link voltsge (IMU current) where 4096 should have been 4092 (=1023*4).
2016-05-03 In both Rev61 branch and trunk: Fixed bug where wmonolith precharge would fail if Vcap was higher than Vbat. Fixed bug where wmonolith would turn off battery contactors on undervoltage despite the fa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
2016-05-03 WMonolith: Changed ControlContactors to require a definite charge or discharge current before ignoring appropriate stress types -- at least 1 amp.
2016-05-06 Tidied up initialisation of timer registers in BSL2 SMclk now same frequency as Mclk, TA0 and TA1 same as well now Added "real time clock" to the monoliths Use &measureCount to determine when to meas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
2016-05-06 Don't initialise the UART or Port1; already set by BSL
2016-05-13 Made it clearer what RAM bytes get cleared on initialisation Don't clear RAM associated with BSL2 Disable interrupts during intialisation Don't disturb the XIN and XOUT bits in P2DIR and P2SEL Fixed 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
2016-05-13 Corrected br BumpRtc to br #BumpRtc. Rearranged interrupt service routines for Tx and Pwm.
2016-05-13 Enable UART TX interrupts Initialise TA1 (not done in BSL2 if ID=255)
2016-05-13 For wmonolith only: Include add instruction in total of CPU cycles to add to timer value for start of start bit. Add txBitTime to parameter list for TxRxIsrTimerMacro . Remove RAM reservation for txB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
2016-05-13 Swapped port bit definitions for DisCtor and TxMiChg to match new schematic. Fixed ALL_TO_ALL test code. Corrected some out-of-date comments re Piezo in initialisation.
2016-05-20 Fixed the error LED coming on during downloads Removed old setPainThresholds ('P' command) Removed no longer used '[' and ']' commands (like XON/XOFF but usable in INIT_CMD_STR) Added comEraseEnd log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
2016-05-23 3mm holes in D9 mounting holes; C&W lib was female 4.8 mm creepage where possible Separate ground from processor to diffamp, noit via DC/DC Pin rotations to agree with schematic
    [BMU.pcb]
2016-05-27 Increased all creepages to 4.8 mm, in some cases by adding 3.2 mm holes at DC-DCs. Rotated one DC-DC 90 degrees as part of the above. Ran Diffamp output alongside Vref and a new clean GND (HaxCom) tr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
    [BMU.pcb, BMU.sch]
2016-05-27 Added master.s43 to monolith folder Rrnamed monolith in wmonolith folder to wmaster.s43 Many changes to bring monolith up to date with latest hardware (from wmonolith.s43 mostly). Assembles but is un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
2016-05-27 Added 39R to TX+ out on CMU schematic.
    [CMU.sch]
2016-05-27 Removed unwanted 'W' definition Added bolt voltage monitoring Added separate voltage calibration for bolt/array port Updated spare command characters in definitions.txt
2016-05-30 Added + for RX, TX Increased clearance D6 to C6 Added note re D5 to JTAG clearance
    [CMU.pcb]
2016-05-30 Fixed an error with TX+ shorted to TX-
    [CMU.sch]
2016-05-30 Replaced single inverter with dual inverter to drive dual LED
    [CMU.sch]
2016-05-30 Added R54 in series with IFO LED so that wired connection continues to work when IFO is present
    [CMU.sch]
2016-06-04 BMU: Added optocoupler and resistors to give a second TX on pin 9 of the SCU DE9 connector using Rly+. PCB complete. CMU: Made a start on laying out the dual inverter.
    [BMU.pcb, BMU.sch, CMU.pcb, CMU.sch]
2016-06-05 Swapped SCU and CHG ports (note: schematic only) Tidied up TxdChg2 layout
    [BMU.sch]
2016-06-05 Routed pins of U10. Started routing the Piezo track; would work if clearances can be fixed Removed FLK from TX- net, but still no hope of placing R54
    [CMU.pcb]
2016-06-05 BMU: Swapped Err and Rly-. Added CHG2 serial port; placed on PCB with creepage, but not yet routed. CMU: Finished routing piezo and dual inverter and swapped Err and Byp.
    [BMU.pcb, BMU.sch, CMU.pcb, CMU.sch, IMsection.pcb, IMsection.sch]
2016-06-06 Doubled (to 0.4 mm) the GND trace under the processor
    [CMU.pcb]
2016-06-06 Added files IMsection.sch and IMsection.pcb on a previous commit but forgot to mention it. BMU: Finished routing the new CHG2 DE9 connector and related components, with the full 4.8 mm creepage.
    [BMU.pcb, BMU.sch]
2016-06-27 Moved LEDs to symmetrical and hopefully sensible places. WARNING: not usable yet! Still 24 design rule violations, and possibly several creepage violations.
    [BMU.pcb]
2016-06-27 Design rule checks pass. Now to creepage violations.
    [BMU.pcb]
2016-06-27 Still needs some creepage checking. Fixed some missing tracks due to pads losing their nets.
    [BMU.pcb]
2016-06-27 BMU PCB: More cleanup by mike after he made the LEDs symmetrical. Still needs some creepage checking.
    [BMU.pcb, BMU.sch]
2016-06-30 Moved Q2, was under a light pipe Restored ground (Hazcom) copper pours Corrected or improved several parts designators Added tracks to recent vias so that the design rules pass with no copper pours F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
    [BMU.pcb]
2016-06-30 Brought OctCMU schematic and PCB up to the new processor pinout, and the dual inverter instead of the nand gate. Minor changes to CMU schematic and PCB.
    [CMU.pcb, CMU.sch, OctCMU.pcb, OctCMU.sch]
2016-07-01 BMU checked for 4.8 mm creepage. LEDs moved to integral mm coordinates.
    [BMU.pcb, BMU.sch]
2016-07-16 BMU PCB: Moved all comms LEDs (blue and yellow-green) from +-13 mm y-coord to +-12 mm y-coord so they align with contactor LEDs. Rotated all comms LEDs to have the same orientation.
    [BMU.pcb]
2016-07-17 Fixed bugs found in testing rev61 software for the first time since branching the project. Testing was done on the on the rev61 hardware in the standalone PV system at Kingscliff TAFE. Some of these 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
2016-07-19 Changed all JTAG pads except negative, from square to round. Put red LED on whole mm coords, centred between comms LEDs.
    [BMU.pcb]
2016-07-28 Corrected UV comment in rev61/monolith.s43. Increased printed bypass resistor length to 1380 mm in both CMU and OctCMU. Increased OctCMU creepage to 2.0 mm. Many minor changes to BMU, CMU, OctCMU PCB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
    [BMU.pcb, BMU.sch, CMU.pcb, CMU.sch, OctCMU.pcb, OctCMU.sch]
2016-08-08 Double slosh at end of packet buffer, in case second char is undefined 80 -> $80 Replaced rla.b with rla to enable 2 char commands to work
2016-08-19 Major rationalisation of component designators. Fixed problems of silkscreen on pads or via-holes, caused by the above. Changed inverter in BMU to dual (same as CMU) to reduce inventory.
    [BMU.pcb, BMU.sch, CMU.pcb, CMU.sch, IMsection.pcb, IMsection.sch, OctCMU.pcb, OctCMU.sch]
2016-08-22 Fixed rotatables group and moved a few tracks and a via so that the design rotates properly now.
    [CMU.pcb]
2016-08-22 Updated Readme.txt for PCB rotation. Fixed one perforation hole that needed style3.
    [CMU.pcb]
2016-08-22 Fixed two components that had the wrong value showing (hence bad designator after replication) Added "Non-plated cutout" text for round holes in replicated outlines
    [CMU.pcb]
2016-08-22 Minor changes to cutout text.
    [CMU.pcb]
2016-08-22 Put text "Weber & Coulomb" and "CMU" into the Rotatables group.
    [CMU.pcb]
2016-08-22 Changed LED colours for 12V inputs and outputs. Dual Red/Blue used for inputs and replaced with plain Blue for outputs. Changed the order of other colours. Fixed problem where yellow (really amber) w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
    [BMU.pcb, BMU.sch, CMU.sch, OctCMU.pcb]
2016-08-26 Swapped BMU LEDs that were incorrectly labelled yellow and orange. Renamed them to amber and red-orange after their actual colours, not what the manufacturer calls them (LED redshift). Added waveleng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
    [BMU.pcb, BMU.sch, CMU.pcb, CMU.sch, OctCMU.pcb, OctCMU.sch]
2016-08-26 Removed silk screen lines from pads (needed for PCB Zone)
    [OctCMU.pcb]
2016-08-26 PCB Readme.txt: there should be no design rule errors now. Also don't need to use the "delete error" button.
    [OctCMU.pcb]
2016-08-26 Improved R6 creepage. Added GND copper pour at north of PCB, as in OctCMU. Made many small improvements to the replication and manufacturing file procedures.
    [CMU.pcb]
2016-08-26 Eliminated 0.025 mm lines from soldermask layers -- was outlines of circular terminal pads. Changed to 0.2 mm like oval terminal pads.
    [CMU.pcb]
2016-08-28 Restore fuse F1 that was somehow accidentally deleted. Improve OctCMU isomerisation instructions.
    [OctCMU.pcb]
2016-08-29 This is the version ove everything that was sent tp PCB Zone for prototyping. Reduced pad area of DPak MOSFET in library. Many changes to BMU to obtain 4.8 mm creepage.
    [BMU.pcb]
2016-08-29 This is what was sent to PCB Zone. Removed obsolete text "Non-plated Cutout" from Cutouts Text layer of OctCMU. The terminal pad has a plated-thru drilled hole.
    [OctCMU.pcb]
2016-09-02 Added comments to pcbs re adding pads for 9mm piezos. Updated URLs for components.
    [BMU.pcb, BMU.sch, CMU.pcb, CMU.sch, OctCMU.sch]
2016-09-02 Updated component URLs in schematic
    [BMU.sch, CMU.sch]
2016-09-05 Updated component URLs. Added heatsink copper for bypass MOSFET. Added pads for 9 mm SMD piezo.
    [BMU.sch, CMU.pcb, CMU.sch, OctCMU.pcb, OctCMU.sch]
2016-09-05 Added pads for 9mm SMD and 13 mm round piezo to BMU. Enlarged 9 mm piezo pads to 1.25 mm.
    [BMU.pcb, CMU.pcb]
2016-09-24 Stopped contactor output being used for analog SoC meter PWM. Renamed contactor outputs in both software and schematic/PCB to Pre, BatPos, BatNeg, AcLfPv, RtPv respectively. Changed precharge sequenc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
    [BMU.pcb, BMU.sch]
2016-09-25 Increase delays on source contactor outputs from 160 ms to 400 ms to allow for multiple contactors with delay boards between.
2016-09-26 Added definitions for ChgPortDIR/SEL/OUT and ScuPortDIR/SEL/OUT Changed port initialisation to be agnostic to ordering of Chg and Scu ports (SEL and DIR ports) Swapped Chg and Scu interrupt vectors. 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
2016-09-30 Corrected pin assignments for RxChg2 and TxMiChg2. Ensured RxChg2 was not set as output (but only in TestICal so far). Made the 'l' command do the right thing on BMUs -- pos and neg currents. Added c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
2016-10-02 Fixed bug in BMU schematic where reset-on-break came from RxChg. In now comes from RxScu as it used to, but PCB is not fixed yet. Fixed bugs in new QUOTE and TYPE commands for strings. Corrected pret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
    [BMU.sch]
2016-10-03 Renamed all CMUSend to LyteFlash New icon Version 1.5 Corrected prompt for File/Send menu pick
    [EnumSerial.cpp, EnumSerial.h, LyteFlash.cpp, LyteFlash.h, LyteFlashDoc.cpp, LyteFlashDoc.h, LyteFlashView.cpp, LyteFlashView.h]
2016-10-07 Moved Halt routine from comDefinitions.s43 to InterruptComms.s43 so TestICal would assemble. Also moved DELAY_IF_NEEDED, DoEcho and DoPassword from monitor.s43, monolith.s43 and wmonolith.s43 to Inte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
2016-10-07 Added TxStringCrcS to send a string to a charger with CRC updating Modified TxtringCRC to pre-test the string length (so zero length strings should work) Completed PipCommand command (send string to 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
2016-10-07 Debugged 'Pp' command (send command to PIP). Changed 'I' command to 'Is' (shunt current). Changed 'P' to 'In' (input port value). Updated definitions.txt with the above. Increased the Master unblock 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
2016-10-10 Added code to connect charger out to SCU in.
2016-10-14 Found numerous bugs in TestICal while testing Rev63 CMU prototypes. Added clearing of the oscillator fault interrupt flag in the BSL. Added 'Ms' millisecond delay command to comDefinitions.s43. Fixed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
2016-10-21 First cut at controlling individual cell stress while charging by decreasing the bulk and float charge voltage settings on the PIP-4048(s). Untested, and may ultimately not work at all, because of th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
2016-10-21 Added 32 second timer to even considering raising the bulk or float charger voltages.
2016-10-21 BSL2 interrupt vector for FLL was pointing to BSL2 copy in TestiCal. Hardware revision 63 now. Copied 'j' and 'p'definitions from wmonolith. Start whinge OverVoltage at 3.3 V.
2016-10-24 Replaced BAV70 (SOT-23) diodes with 1N4148 (SOD-323) diodes. Routed the freewheeling diode for the bypass "inductor". Added a 2n2 to the Reset input and a separate limiting resistor for the wired TX 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
    [BMU.pcb, CMU.pcb, CMU.sch]
2016-10-24 TxStringCrc needed a .b reading the length byte Removed references to PI controller, though original code is still there commented out. Whinge is now more critical for testing. May be too critical. E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
2016-10-25 Made CMU PCB survive rotation again, while achieving 1.39 metres of printed bypass resistor not under hot 1N4004 diode.
    [CMU.pcb, CMU.sch]
2016-11-10 BMU rev changed to Rev 6. Added pin 1 dot to U1 and U4 outlines -- improved LED outline orientation. Moved U5 outline south relative to its pins. Moved C5 closer to micro. Renamed C15 to C8 to match 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
    [BMU.pcb, BMU.sch]
2016-11-11 Enlarged holes for pluggable connectors from 1.0 to 1.1 mm. Changed rev on schematic to "Rev 6 Nov 2016", same as PCB.
    [BMU.pcb, BMU.sch]
2016-11-18 Don't echo CMU status to SCU if bNotSendStatus Cut initial power supply settle time from 500 to 200 ms Turn off pre-charge contactor as soon as possible now
2016-12-07 Prevented the 'Pp' (send to PIP) command from being executed by CMUs. Added 'Br' command, to send a break out of the UART port, so a BMU can reset its CMUs. Added new jWriteBreak entry point to the B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
2016-12-07 Increased delay between PV contactors in DoPrecharge, to allow for contactor delay boards that have up to 400 ms delays.
2016-12-07 Cleared hi bit on charger (PIP) responses sent to SCU (BBB) so CRC bytes are not confused with status bytes.
2016-12-15 Changed monolith main loop so it only reads one character at a time from the Charger port. Changed Charger buffer size back to 32 bytes (from 64 bytes). Renamed "AccMaster" to "Master".
2016-12-16 Fixed problem in trunk/monolith where communication between SCU and CMU ports of a BMU would slow to less than 2 char/s, and there was no PIP initialisation. The fix was to add a check for PV contact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
2016-12-26 Fixed comments and calculations related to the change from 1.9 to 2.0 Hz status frequency, and the current units changing from 0.2 to 0.1 A.
2017-01-01 If the source contactors are off, treat it as if we are charging, and so ignore only undervoltage stress. Added the aliases _IF_OR and _OR, for the _OR_ELSE short-circuit-OR conditional macro, to imp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
2017-01-05 Changed the PIP initialisation to set parameter 13 (back to battery) from 52 V to 53 V in trunk monolith.
2017-01-30 Changed battery capacity and cell resistance from source code constants to calibration values stored in info-flash.
2017-01-30 Moved the disabling of interrupts to the start of the bit-banging read from the SCU port in ReadByte in the BSL.
2017-01-31 In BSL initialisation, allowed time for the FLL to tune the DCO, before interrupts get disabled in the bit-sniffing version of ReadByte used in BMUs. Renamed oldCCR0 to oldFllTime. Ensured that oldFl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
2017-02-05 Bootstrap loading of trunk BMUs via their SCU ports is now working! This includes pass-thru of Rev61 bootstrap loads for mixed systems. It also includes bootstrap loading from the Halt routine. This 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
2017-02-06 Ensure that neither the BSL nor the initialisation part of any program changes the state of any of the contactor outputs, so as to avoid loss of power during firmware updates or changes between TestI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
2017-02-06 Made main programs initialise contactors to off when the reset was due to powering up. Unfortunately contactors still get dropped out after a bootstrap load. Made BMU send a break to CMUs on reset.
2017-02-17 On the CMU,aAdded a 4 pin expansion header near the processor, with two GPIOs (one also an analog in), Veref+ and GND). This is to allow add=on boards that do shunt monitoring and contactor control.
    [CMU.pcb, CMU.sch]
2017-02-17 CMU PCB, restored Rotatables group and ensured it rotated without error.
    [CMU.pcb]
2017-02-18 This is the CMU PCB version sent to RF Tech by Lithium Battery Systems. Changed top overlay from "P6" to "EX" for 4-pin expansion header. Added "JT" for JTAG connector.
    [CMU.pcb]
2017-02-20 CMU PCB, update sent to Lithium Battery Systems. Fixed clearance from MOSFET drain pour to real VDD objects. Stopped name of C3 changing on copies. Moved U4 name off via hole. Added manufacturer's na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
    [CMU.pcb, CMU.sch]
2017-02-21 In the trunk software, finally got bootstrap-loading to work without dropping out contactors and thereby losing power, thanks to much help from Dr Van Emmerik. Hoorah! Moved ErrorFlash routine to the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
2017-02-21 Added entry in PipInit table for 120 A max charge (for use with >= 200 Ah batteries) Commented out by default.
2017-02-22 Changed BSL to use $C0 (the combination of RSTIFG and PORIFG) to indicate a bootstrap-load in the reset log. The apparently-spare bit at $20 did strange things. Changed all programs to distinguish po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
2017-02-22 Changed DoPrecharge, in Monolith and WMonolith, to only turn on the precharge contactor if the positive contactor isn't already on, say after a bootstrap-load, because otherwise it puts too much load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
2017-03-01 CMU PCB, Increased all header pin holes from 0.8 mm to 0.9 mm. Increased pad area for 4 pin expansion header. Added pads for thru-hole watch crystal. Added circular outline for thru-hole piezo. Check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
    [CMU.pcb, CMU.sch]
2017-03-05 CMU: Removed squiggle-joins so all CMUs are separate. Separated the IFO daughter board. Added daughter boards for shunt monitoring and contactor control. Tiled outlines for 12 CMUs and 3 of each daug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
    [CMU.pcb, CMU.sch]
2017-03-06 CMU: Completed shunt monitor (S) and contactor control (C) daughter boards. Zero DRC errors, including when mid section of CMU-A is rotated to make CMU-B.
    [CMU.pcb, CMU.sch]
2017-03-07 CMU: Implemented Mike's corrections and his suggestion re additional RC filtering at the input to the shunt monitor. Added a fourth kind of daughter board "CMU-G" to (hopefully) meet Greg's requireme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
    [CMU.pcb, CMU.sch]
2017-03-07 Minor improvement to CMU-G layout.
    [CMU.pcb]
2017-03-08 Removed CMU-G daughter board and added resistors to CMU-C that can replace the MOSFETs and give direct opto-coupler outputs.
    [CMU.pcb, CMU.sch]
2017-03-09 Separated CMU daughter boards into separate .sch and .pcb files. Panelised 2 x 6 CMUs with no fill-ins but no rails in rectangle 205.5 mm x 275.8 mm. Added tooling holes and global and local fiducial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
    [CMU daughters.pcb, CMU daughters.sch, CMU.pcb, CMU.sch]
2017-03-11 More tabs added as suggested by Norm. "ROUT OUT" text added to all routs, in cutouts text layer. Dangling tracks eliminated. Min and max terminal hole-spacing dimensions updated in bottom documentati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
    [CMU.pcb]
2017-03-11 Fixed minor problems found on inspecting gerbers. Arranged for coordinates in gerbers to be a nice round X+200 mmm and Y+100 mm of those seen in DesignSpark (gerber coords can't be negative). Shifted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
    [CMU.pcb]
2017-03-13 CMU: removed IFO mounting pads from paste layer and eliminated internal sharp points from piezo pads, as suggested by Norm. Moved R7 west to reduce a track length. Changed several parts values in the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
    [CMU.pcb, CMU.sch]
2017-03-13 CMU: Minor track movement.
    [CMU.pcb, CMU.sch]
2017-03-14 Corrected Digikey link for THD piezo. Changed voltage divider resistors from 1% to 0.1%.
    [CMU.pcb, CMU.sch]
2017-03-15 Added schematic and PCB for minimal CMU. Width reduced from 41 mm to 27 mm. Only one isomer. No piezo. No TX LED (blue). No bolt voltage sensing. No reset on break. No supercap for ride-thru of deep 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
    [MinCMU.pcb, MinCMU.sch]
2017-03-16 CMU: Determined (by experiment) the range of resistor values required to make the free-space infrared comms work over typical cell-to-cell distances without crosstalk or skipping a cell. Added a seco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
    [CMU.pcb, CMU.sch, MinCMU.pcb, MinCMU.sch]
2017-03-20 CMU: Cleaned up and checked pours and rotation. All OK. Parts links updated. This was used to generate gerbers and placement and BoM.
    [CMU daughters.pcb, CMU.pcb, CMU.sch]
2017-03-20 CMU daughter boards changed to match moved expansion header on CMU. Changed net from P2.2 to P2.3.
    [CMU daughters.sch]
2017-03-26 Initial commit of MidCMU (PCB - Design Rule Check Report).txt(30.4 mm). Incomplete.
    [MidCMU.pcb, MidCMU.sch, MinCMU.pcb, MinCMU.sch]
2017-03-26 MidCMU: Zero DRC errors in both isomers. Pads for 5W resistor added, for optional extra bypass. Only the top-side printed resistor remains to be done.
    [MidCMU.pcb]
2017-03-27 MidCMU: Completed. Ready for checking by others.
    [MidCMU.pcb, MidCMU.sch]
2017-03-27 MidCMU: Previous version was accidentally committed with the mid-section rotated. Restored that. Fixed numerous minor problems revealed by viewing the gerbers and drill files.
    [MidCMU.pcb, MidCMU.sch]
2017-03-27 MidCMU: Fixed MOSFET drain copper-pour clearance.
    [MidCMU.pcb]
2017-03-30 MidCMU: Created outlines for panellisation. Added mouse-bites to tabs. Added Mouser URLs to many components. Updated Readme.txt with new offsets when replicating MidCMU.
    [MidCMU.pcb, MidCMU.sch]
2017-03-31 BSL: Added WriteScuByte, untested. Added calculation of low pass filtered version of battery voltage, untested. Indicated a BSL "reset" after a 'b' command. MidCMU: Fixed some comments about MOSFET p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
    [MidCMU.pcb]
2017-03-31 Corrected subtract of "old" in battery voltage low pass filter code Still not working
2017-03-31 Added macros: neg, rra8_l, rla8_l. Added test for low rested voltage for updating SoC. Untested. Added code to convert an SoC to a discharge counter value. Untested.
2017-04-02 Updated Digikey links for all parts. Added BoM to SVN control. Removed all parts, vias and tracks from the phantom Rotatables group left by DesignSpark 8.0. Reported the bug where Forward Design Chan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
    [MidCMU (BoM).csv, MidCMU.pcb, MidCMU.sch]
2017-04-03 MidCMU: Changed MOSFET to RTR030N05 as primary choice. Multi-sourced 45 V 95 mR. Added Mouser URLs for all parts.
    [MidCMU (BoM).csv, MidCMU.pcb, MidCMU.sch]
2017-04-03 Monolith: Fixed 11 bugs in the new code for setting the coulomb counter when low rested battery voltages are measured. The bugs were found by reading the code. Added some rounding to some divisions.
2017-04-04 Move 'a' command to monoDefinitions.s43 so TestICal will assemble Call _updateInfoFlash to write an ID of 0 to new CMU chips. Otherwise, BSL won't even read a byte from the UART
2017-04-05 Implemented new voltage range of 4.35 V. Use manufacturer's cal data as defaults for VoltCal, BoltCal and TempCal. Corrected LinkCal calculation for 4092 max instead of 4095. Initialised port bit for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
2017-04-06 MidCMU: Finished layout changes after testing prototypes. Ready for replicating to fill the panel.
    [MidCMU.pcb, MidCMU.sch]
2017-04-07 MidCMU: Final version that was replicated and used to generate manufacturing plots sent to Greg for sending to KingBrother.
    [MidCMU.pcb, MidCMU.sch]
2017-04-07 MiCMU: Initial commit of the fully replicated panel of 12 MidCMUs.
    [12MidCMUs.pcb]
2017-04-08 TestICal: Added 'Ir' command that takes a parameter between 0 and 7 to set the infrared emitter signal level. Modified the 'Mv' command so it gives the correct millivolts for Vcc.
2017-04-08 Increased the depth of the assembly-time control-flow stack from 8 to 12, to allow for larger CASE statements like the one in the 'Ir' command.
2017-04-09 TestICal: Made 'Mv' command give correct response type. Added setting of REN bits in case 0 of 'Ir' command. Changed from byte compares to word compares in 'Ir'.
2017-04-09 MidCMU: Changed red LED resistor from 510R to 150R. Changed yellow LED resistor from 82R to 510R. Changed WTX+ resistor from 82R to 150 R.
    [MidCMU.pcb, MidCMU.sch]
2017-04-10 Clear REN bits in Ir command whenever outputs are toggling. The REN (Resistor ENable) bits seem to upset the outputs when SEL bits are on.
2017-04-10 Changed Ir command from 8 cases (0-7) to 5 (0-4) Changed Ir command case 0 to make both outputs high (so don't have to fiddle pullup port at all)
2017-04-10 MidCMU: Updated schematic and CSV BoM with new IR LED resistors.
    [MidCMU (BoM).csv, MidCMU.pcb, MidCMU.sch]
2017-04-10 MidCMU: Initial commit of 2MidCMUs placement CSV file.
    [2MidCMUs (Component Positions CSV).csv]
2017-04-10 MidCMU: Initial commit of MidCMU BoM Excel file.
    [MidCMU (BoM).xlsx]
2017-04-10 MidCMU: Updated Placement file with new resistor values and named the parts on the B isomer with "_B".
    [2MidCMUs (Component Positions CSV).csv]
2017-04-10 TestICal: Fixed bug in the zero case of the 'Ir' command.
2017-04-17 Common: Made it so BMUs to not apply the 17/16 times the raw voltage measurements.
2017-05-05 Fixed bug in temperature offset calculation for new chip. Added adjustment for systematic error in voltage calibration.
2017-05-05 Changed to fast jtag programming. Fixed bug in temperature cal value calculation. * 2 becomes * 8. Added adjustment for systematic error in temperature calibration.
2017-05-05 Added 100 mV threshold so bare boards don't scream Minor updates to Testing.txt Reduce systematic voltage error adjustment from 80 to 70
2017-05-06 TestICal: Added the appropriate multiplication by 17/16 in the voltage calibration routine. Added #define FAKE_NEW_CHIP 0 and associated conditional assembly to allow forcing a recalculation of our c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
2017-05-21 Use TI provided ADC gain and offset correction values in our calibration constants Added cell and boltPlus offsets to calibration flash and ram areas Added 'o' and 'O' to calAddressTable so offsets c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
2017-05-21 Bug fixes for previous checkin, following Dave's review: Comment fixed in common.h (word -> byte) Removed unnecessary test for hardware rev != 63; also fixes ret being in the wrong place (was inside 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
2017-05-21 Monolith: Fixed bug where measureCount was allowed to slip a little each time,leading to a tiny error in SoC. Improved a comment about estimating cell internal resistance, in the 'rw command. BMU: Ad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
    [BMU.pcb, BMU.sch]
2017-05-22 measAndScale -> measAndCorr Calls to measAndCorr changed to measAndCorrBolt where the channel is the boltPlus channel Fixed monitor and wmonolith not assembling by adding definitions for VoltOff etc 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
2017-05-22 Added conditional assembly for BMU to tell CMUs never to beep. Added code to subtract 10 degrees from the temperature that is used to calculate OT stress if we have bypassed in the last 5 minutes. Th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
2017-05-22 Modified Hazcom tracks around the shunt diffamp to maintain a somewhat separated "dirty earth" from C24, C25 back to the processor.
    [BMU.pcb]
2017-05-22 Re-arranged HazCom grounds to make the HazCom terminal part of the dirty ground, per Dave's suggestion.
    [BMU.pcb]
2017-05-23 BMU PCB with manufacturing plot settings as sent to PCBZone.
    [BMU.pcb]
2017-05-23 Updated Digi-Key links to BMU parts; fixed some problems such as wrong 1N4148 diode. Swapped values for R28d, R57d.
    [BMU.pcb, BMU.sch]
2017-05-25 TesDefinitions.s43: fixed an invisible line ending problem that prevents assembling. BMU.sch: more updates to DigiKey links for less expensive parts that do the same thing
    [BMU.sch]
2017-06-01 BMU: Corrected the digikey link for U20, the OPA333 op-amp from the SOIC-8 package to the SOT23-5 package. Forwarded parts URL changes to PCB.
    [BMU.pcb, BMU.sch]
2017-06-02 BMU: Updated some parts URLs and component descriptions.
    [BMU.pcb, BMU.sch]
2017-06-04 BSLFLG is now a combination of watchdog and reset pin bits Contactors stay on when needed, and go off when needed now
2017-06-04 Added a check for the existence of BoltPlCal, and substituted (cell)VoltCal if it doesn't exist (i.e. if it is $FFFF).
2017-06-04 Slight improvement in the precision of the calculation in the 'tc (temperature calibration) command. Change in JTAG speed for monolith project.
2017-06-04 Changed temperature calibration to use the two TI provided calibration values (for 85C and 30C) Added MMStar for mixed-sign mixed-size multiplication infoTempCal -> infoTempOff (similarly ramTempOff)
2017-06-04 Added scale calibration for bolt-. Renamed many related things.
2017-06-04 Applied tempOff (temperature offset) to temperature measurement function temp()
2017-06-04 Updated monitor and wmonolith with latest additions and renames of calibration constants.
2017-06-04 Removed obsolete calculation of temp offset for new chip. Set it to zero. Added rounding to temp slope calculation for new chip. Renamed temp routine to Temp. Added a _CS_CHECK macro at the end of al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
2017-06-05 Renamed LinkVChan to BoltVMiChan, and fixed related comments. Added "enabling" of BoltVPlChan in ADC10AE0. Really just disconnects digital buffers at all time, instead of only when converting.
2017-06-05 Updated 'tc (temperature calibrate) command to use the new method of temp calibration.
2017-06-05 Corrected a Fixed Point arithmetic error in calculating a temperature measurement. Untested.
2017-06-05 Tested Mike's fix to 't command. Much improved. Error now only 2degC. Changed &infoTempSlope to &TempSlope in Temp: routine in measure.s43. Added EQUate for TempSlope to all programs. In newChip:, ch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
2017-06-05 For new chip, multiplied manufacturer's ADC offset by 4 for setting CellOff, BoltPlOff and BoltMiOff, because of our effective 12 bits of ADC. Subtracted (Vref_factor - 1)*2046 from the above value o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
2017-06-07 Added C? and C! commands for peek char and poke char (byte). Changed ? and ! commands to peek word and poke word. Moved peeks and Mv to all programs, pokes only in TestICal. Changed TestIcal q comman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
2017-06-07 In TestICal, made ADC10CLK come out on pin 5 (unused on BMU, expansion port on CMU) so its frequency can be measured.
2017-06-07 Moved setup of ADC10CLK function of P1.3 (pin 5) out of the initialisation and into a new Fa command. Added Fa command that puts a 5s burst of ADC10CLK out on pin 5.
2017-06-07 Changed Fa command to do repeated conversions. Yet another attempt at getting ADC10CLK out on a pin to be measured.
2017-06-08 Deleted +ADC10DIV_7 from several ADC conversions. Added commented-out code in the measure routine to try different ADC clocks. Added a call to CellV at the start of the Fa command. Removed initialisa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
2017-06-08 Add corrections for three systematic errors: 1131/1129 for the Vref calibration factor, +1 for Is/bolt measurement, and +1 for temperature measurement. All three corrections end up in existing calibr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
2017-06-09 Fix bugs in systematic correction code: 1131/1129 factor -> 3329/3323, but don't apply to ramBoltMiOff Moved adjustment of ramBoltMiOff from 'lc to new chip logic Reversed sign of systematic temperat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
2017-06-09 Data version 7: Temperature calibration offset is in half degrees now, and added to rather than subtracted from the measurement Systematic temperature correction is now -1.5 degrees ~1 second error f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
2017-06-09 Reinstated +1 systematic BoltMi offset correction Fixed 1 second delay when TestICal finds data version 6
2017-06-09 Made Temp: routine return correctly rounded value in half-degrees in R9 as well as the usual correctly rounded whole degrees in R10. Made 'tc command use the measured half-degrees value in R9 from Te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
2017-06-09 Increased the BoltMi systematic error correction from 1 to 2, due to the fact that it gets divided by 1.364. Swapped 'n' and 'o' aliases, so 'n' stands for Negative-bolt/curreNt-shuNt and is now an a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
2017-06-12 Preparing to provide the equivalent of w and r commands (write and read calibration data) to monolith Monolith 'r' becomes 'Rx' Added OFFGRID etc definitions to hopefully make it easier to manage PIP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
2017-06-13 Added new info data byte AdcTimIdx to save the optimal ADC timing for this CMU/BMU Added new commands 'aw and 'ar to write and read this new info flash byte Added FindOptAdc function to TestICal, and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
2017-06-14 Changed the convention for R9 parameter of MonoUpdFlash to agree with other byte/word parameters Moved MonoUpdFlash from monolith.s43 to monoDefinitions.s43 Fixed and added some comments on _IF _NN R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
2017-06-14 In TestICal's FindOptAdc, average 128 GetCellV samples rather than 16 to find the "actual" cell voltage
2017-06-15 Added Ad debugging command for ADC timing deviations without having to do the FAKE_NEW_CHIP thing Tidied up the FindOptAdc code, and changed to pairs of 256 measurements
2017-06-16 Monolith command does only 'r', 'c', 'i' subcommands Added monolith 'ic (ident) and 'nc commands (zero current shunt) Enabled or_w and or_b macros MonoUpdFlash -> UpdFlash Commented out monolith "Cha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
2017-06-16 Fixed TestICal's 'ac command to display the chosen ADC clock index
2017-06-18 Made BMU ignore Ctrl+Q (XON). Changed the order of the 'w', 'c' and 'r' commands in MonoDefinitions, to match TesDefinitions. Eliminated other needless differences between the two versions. Capitalis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
2017-07-08 Changed smoothed stress to average the last 8 values, not the last 4, for the purposes of contactor control (BMU only). Proposed as a solution for a customer having dropouts when a water pump starts.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
2017-07-10 SPECIAL CASE VERSION! This version has the 'sc command added, for updating flash data from data version 6 to data version 7, while maintaining already calibrated cell voltages. It suppresses the \Don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
2017-07-20 Start unification of the three branches. Here, treatment of ignorable stress is unified: the current direction is checked, and if the resultant stress is ignorable, it is treated as stress 5 (was 7 i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
2017-07-20 Unification part 2. UV_ZERO set to 3380 in rev58 monolith. OT_ZERO set to 33 (was 32) in rev58 monolith and rev61 wmonolith. RxSz -> ChgRxSz etc in a couple of places. Ported the overtemperature comp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
2017-07-22 Added a timeout to (rev61 and trunk) x (monolith and wmonolith) so that if an 'i' command is not received for 9 status cycles the current will be assumed to be zero.
2017-07-22 Added digikey URLs for the optic fibre, to the Daughterboard schematic
    [CMU daughters.sch, MidCMU.sch]
2017-08-04 PIP init string sent one command at a time, allowing activity between commands and not crippling the BMU until the commands are all sent. Also checked in some changes to schematic symbols, for PIP pa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
2017-08-05 Fixed negative-temperature bug caused by TI redefining their calibration constant identifiers from indexes to offsets.
2017-08-11 Added #ifed-out setting for a possible 2.8 V per cell cutoff (LV stress 15).
2017-08-11 Added LOW_LOW_CUTOFF conditional assembly. Moved commonly-used conditional assembly to the start of monolith.s43.
2017-08-11 Cleared the discharge counter on reset (100% SoC) in BMU and CMUs. This means the stored SoC value in CMU 1 goes to 100% when the CMU is first bolted to a cell. In BSL, stopped a reset BMU from sendi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
2017-08-14 Fixed a comment regarding BSL passwords in InterruptComms.s43.
2017-08-18 Added 'n subcommand of the 'w' (write calibration) command. For adjusting SOC drift. Added # command to definitions.txt
2017-08-21 Changed the command for smoothed estimated open circuit voltage from 'a' to 'O' and documented it in definitions.txt. Improved a few related comments.
2017-09-07 Documented the Fa command (frequency of ADC clock), in definitions.txt. Changed default ID for new CMUs from 0 to 1, so that a comms error will not be generated when all new CMUs are randomly bolted 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
2017-09-08 Reinstated calculation of stress based on link voltage. With 6 mV per stress level. Tested and works a treat.
2017-09-22 Fixed bugs in trunk Monitor that have accumulated through many changes since rev58 and through neglect of proper testing. The most serious was an excess push of the cell voltage (without matching pop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
2017-11-16 Changed the temperature quota allowed for bypassing, from 10 °C to 12 °C, in trunk monitor, monolith and wmonolith.
2017-11-19 Rev61 monolith: Changed bypass temperature quota from 10 °C to 12 °C, same as trunk. Trunk monolith: Changed bypass stress level to 7 and full to 8, same as rev61. Raised ignorable stress and stress 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
2017-11-21 Added a 140 ms delay before turning source contactors back on, in case they were only just turned off, as this would otherwise overload the 12 V DC-DC converter and shut down the Monolith. Added anot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
2017-12-09 In TestICal, initialised ScuRx and ScuTx pins to GPIO because other programs use the timer functions of these pins, and we may have been bootstrap-loaded over one of them, in which case we wouldn't h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
2017-12-15 Starting to make interrupt driven ADC that averages over 10 ms so we don't see 100 Hz ripple. Not finished yet. Renamed SocPWM interrupt to become a Measure interrupt. Fixed some comments.
2017-12-15 Preparation for IntMeasure code: Declare RAM variables Enable appropriate CCTL interrupts Set ADC10ON bit when initialising ADC10 Precalculate chanList Define MeasCCTL
2017-12-15 Added code to MeasureIsr to ensure it is called at 1600 Hz. Corrected and improved many comments.
2017-12-15 Made separate MeasureCmuIsr and MeasureBmuIsr entry points so in the CMU case, with a CCR2, we can read TAIV to clear the interrupt flag.
2017-12-17 Interrupt driven measurement is now working in both BMU and CMUs. It was fixed by changing mov &TAIV,R3 to MOV &TAIV,R8. There is a remaining annoyance, that on bootstrap loading, some CMUs beep and 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
2017-12-17 Arranged for state-of-charge to survive a reflash (bootstrap-load) of monolith.bin.
2017-12-18 Fixed In (Input) command: was running into # command; now prints Is instead of P definitions.txt: Mv is documented as a CMU only command
2018-01-01 Major overhaul of the structured-control-flow macros. The corresponding labels and jump instructions now appear in the listing, in the correct places. No more mysterious out-of-order DWs. Condition c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
2018-01-02 More changes to Control flow macros. Changed the definition of _OF (within _CASE..._ENDCASE) to allow more general tests, and thereby allow the equivalent of IF cond1...ELSEIF cond2...ELSEIF cond3...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
2018-01-03 Added "In memory of Wil Baden (1928-2016)". Changed _COND..._ENDIFS and _CASE..._ENDCASE to use a zero terminator on the control-flow stack instead of a counter, as Wil Baden was trying to tell me al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
2018-01-05 Added tests and error messages for Control-flow stack overflow and underflow as suggested by Mike.
2018-01-09 Comment re bypass voltage corrected (trunk and Rev 61) The same comment has been unified so that trunk and Rev 61 agree exactly now.
2018-01-24 Changed UMStar and UMSlashMod to use structured-control-flow macros instead of jumps and labels. Checked that the machine code generated for the above did not change.
2018-03-05 Ignore ERROR_INSUFFICIENT_BUFFER that seems to come up for certain odd devices (perhaps bluetooth auto-generated serial ports) Version 1.8, ©2018
    [EnumSerial.cpp]
2018-03-06 Made UpdErrorRatio more efficient and changed rounding adjustments from $8000 to $7FFF to ensure the error ratio can get down to 0 and can't overflow. Used the PIP init timer to reset the errorRatio 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
    [Crc12Calc.xlsx]
2018-03-06 Added CRC12 Excel spreadsheet and its Bitwise-operation add-ins.
    [Crc12Calc.xlsx]
2018-07-03 In trunk monolith: Changed defaults to OFF_GRID and 80 A SCC. Made Ff (Force fuel gauge) command clamp its argument down to 100%. In rev 58 monolith: Changed PIP low voltage cutoff from 50.8 V to 50.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
2018-08-08 Made it so the cell temperature used for calculating internal resistance is not updated when a CMU is, or has been, bypassing. Changed definition of "been bypassing" from 5-minutes-after to 3-minutes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
2018-09-22 Changed bolt-voltage stress from 6 mV per level to 8 mV per level. Changed "been-bypassing" time from 3 minutes back to 5 minutes.
2018-11-19 Ported the Control Flow Macros to the Code Composer Studio assembler for the TMS320C28x processor as used in patching the firmware for the PIP-5048MS (Axpert MKS 5K-48) inverters.
2018-12-10 Moved clearing of the ENC bit in ADC10CTL0 to inside a conditional clause, so that the ADC system is only turned off when needed (when changing channels), not every conversion. Seems to fix a 6-10 mV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
2018-12-10 Fixed the problem of the alarm going off when removing a CMU. Actively turn off alarm and LED if the raw measurement is below approx 200 mV.
2019-07-10 Made open circuit cell voltage (as returned by the 'O' command) work for CMUs as well as BMUs.
2019-07-28 Added all calibration-value write commands to monolith. Added all calibrate commands except ADC clock to monolith. Removed the 'a' (ADC raw) command. Removed the 'Mv' (measure Vcc) command from monol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
2019-07-29 Added a new 'a' command, which stands for "additive alteration", which is the best mnemonic I can come up with for "positive volt drop", i.e. V - v. It is the positive counterpart to the 'n' (negativ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
2019-07-30 Trying to find out why, on some CMUs, the cell voltage readings can differ by up to 15 mV between monolith and TestICal. Adding the ability to calibrate cell voltage in monolith is a workaround for t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
2019-07-30 Stopped forcing temperature measurement to use divide-by-8 on the clock, as this may be less accurate than the divider chosen by the 'ac command. Used BoltPlV for both the average and the deviations,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
2019-07-31 'ac (find best ADC clock) command in monolith tested OK. Found that the best clock for monolith can be almost the worst for TestICal and vice versa. Changed default and reference ADC clocks to MCLK/5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
2019-07-31 Changed default ADC timing to MCLK/5 (index 11) (wasn't changed last time). Fixed bug where the capacity cal value was not being scaled by 10 for 'cr and 'cw in TestICal and 'cw in Monolith.
2019-08-01 Used the upper and lower nibbles of infoAdcTimIdx to record separate best ADC clocks for Monolith (MS nibble) and TestICal and other non-interrupt measurement software (LS nibble). Default for monoli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
2019-08-05 Eliminated forbidden values in cell voltage measurements (was all n*17+8) by doing the multiply-by-17/16 on the raw 12.2-bit value /before/ correcting it for scale and offset and rounding it to 12 bi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
2019-08-05 Fixed bug introduced in last revision, in TestICal, where cell voltage was multiplied by 17/16 twice.
2019-08-05 Added 'W' "woltage" command to return unfiltered estimated open-circuit voltage (IR compensated). Adjusted the undervoltage stress scale after learning, with Matt James, of the low plateau between 3.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
2019-08-08 Added lowercase 'o' command to Monolith to return filtered estimated open circuit voltage in sixteenths of a millivolt, to allow dV/dSoC calculations to produce results with reasonable resolution. Ma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
2019-08-13 Improved the internal resistance adjustment for temperature so it changes with every degree Celsius, not merely every 6 degrees, and made it a better fit to the graph in Lu 2011. (Untested). Added a 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
2019-08-13 Internal resistance temperature adjustment now correct. Added correction for tempco of voltage reference, by subtracting (T-25)>>2 mV.
2019-09-09 Increased default overvoltage thresholds by 2 mV to make them multiples of 10 mV. Added monolith command 'Th' to set some thresholds. 'V Overvolt stress zero & step mV, 'b bypass mV, 'f full mV, 'a a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
2019-09-13 Fixed bug where cell temperature (not updated during bypassing) was being used instead of CMU temperature, for correcting for the tempco of the ADC voltage reference. Added 'Tc' command that returns 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
2019-10-17 Made Monolith's WriteCalValue 'w' command treat certain values as special when writing the Cell or Bolt+ voltage scale factor. 'v'Vw sets the Bolt+ voltage scale factor the same as the Cell voltage s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
2020-09-30 Added TX- output resistor to protect against short-circuits when two CMUs are accidentally connected TX to TX, in MidCMU.pcb. Not yet in 12MidCMUs.pcb. Brought library instructions up to date.
    [MidCMU.pcb, MidCMU.sch]
